SatelliteApplicationsCatapult/PocketQube/hardware/Electronic/PCB Designs/RFP/Manufacture files/RFP.jpg

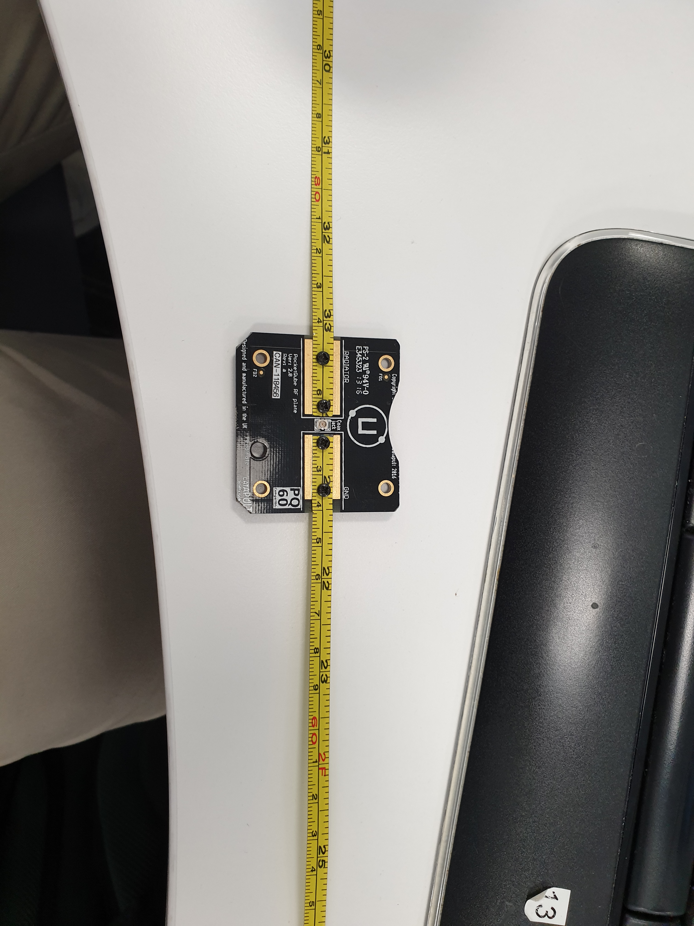
hardware/Electronic/PCB Designs/RFP/Manufacture files/RFP.jpg
