SatelliteApplicationsCatapult/PocketQube/hardware/Electronic/Sketchup Component Models/Textures/IXYS_rear.jpg

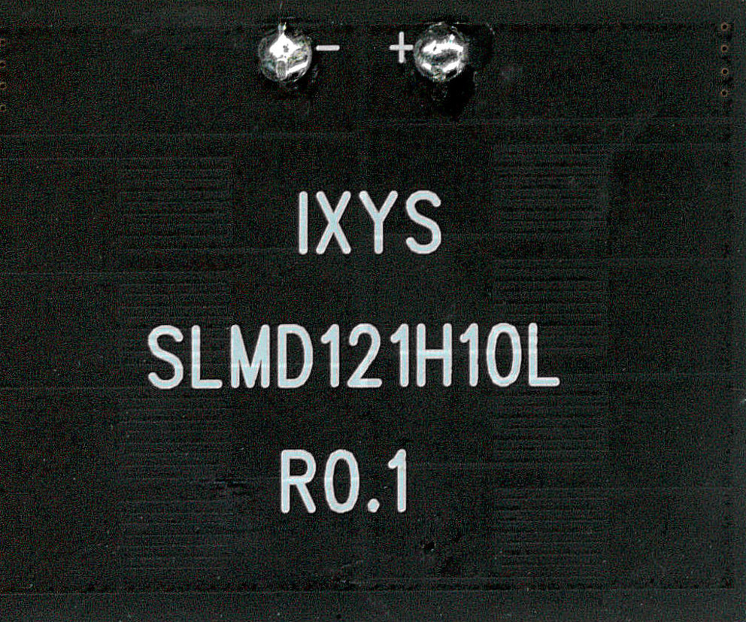
hardware/Electronic/Sketchup Component Models/Textures/IXYS_rear.jpg
