SatelliteApplicationsCatapult/PocketQube/cube/examples/README.md

New example structure. Propose _Basics_ contains blink, and a USB / radio debug terminal, incorporating self tests
_Cube_ will contain sensor access examples through the cube library, EPS communications, mode switching etc
_Payload_ contains payload examples, camera and mock?
_Examples_ will contain a single example for every satellite component
