SatelliteApplicationsCatapult/PocketQube/hardware/Electronic/PCB Designs/EPS/KiCAD/EPS/EPS_conversion_log.txt

#********** START OF renumber-sheet.ulp ULP Version 4.4.4 14-03-2016 :10:27:15 LOG **********#
#OldRef				SheetNumber	NewRef
BAT				2	BAT56
BU4331G-TR				2	BU4331G-TR56
INA210AIDCKT				2	INA210AIDCKT56
PQ60_HEADER				3	PQ60_HEADER56
PQ60_RECEPTACLE				3	PQ60_RECEPTACLE56
PWR				2	PWR56
STWD100PYW83F				2	STWD100PYW83F56
#********** END OF renumber-sheet.ulp ULP Version 4.4.4 14-03-2016 :10:27:15 LOG **********#

#********** START OF fix_via_hack.ulp ULP Version 4.6.0 14-03-2016 :10:28:07 LOG **********#
PADFILL	PadCount=5		Net=GND				(X=6850.000000 Y=21200.000000)	LayerStart=16	LayerEnd=16
PADFILL	PadCount=9		Net=GND				(X=32600.000000 Y=15550.000000)	LayerStart=16	LayerEnd=16
PADFILL	PadCount=11		Net=GND				(X=27400.000000 Y=8750.000000)	LayerStart=16	LayerEnd=16
PADFILL	PadCount=13		Net=GND				(X=26800.000000 Y=14250.000000)	LayerStart=16	LayerEnd=16
PADFILL	PadCount=15		Net=GND				(X=32850.000000 Y=19900.000000)	LayerStart=16	LayerEnd=16
PADFILL	PadCount=17		Net=GND				(X=40800.000000 Y=15550.000000)	LayerStart=16	LayerEnd=16
PADFILL	PadCount=19		Net=GND				(X=34700.000000 Y=8750.000000)	LayerStart=16	LayerEnd=16
PADFILL	PadCount=21		Net=GND				(X=34700.000000 Y=14250.000000)	LayerStart=16	LayerEnd=16
PADFILL	PadCount=23		Net=GND				(X=41050.000000 Y=19800.000000)	LayerStart=16	LayerEnd=16
PADFILL	PadCount=25		Net=GND				(X=4900.000000 Y=21950.000000)	LayerStart=16	LayerEnd=16
PADFILL	PadCount=27		Net=GND				(X=3050.000000 Y=25500.000000)	LayerStart=16	LayerEnd=16
PADFILL	PadCount=29		Net=GND				(X=10600.000000 Y=21950.000000)	LayerStart=16	LayerEnd=16
PADFILL	PadCount=31		Net=GND				(X=28400.000000 Y=22150.000000)	LayerStart=16	LayerEnd=16
PADFILL	PadCount=33		Net=GND				(X=26800.000000 Y=21150.000000)	LayerStart=16	LayerEnd=16
PADFILL	PadCount=39		Net=GND				(X=3600.000000 Y=17200.000000)	LayerStart=16	LayerEnd=16
PADFILL	PadCount=50		Net=GND				(X=29600.000000 Y=16850.000000)	LayerStart=16	LayerEnd=16
PADFILL	PadCount=58		Net=GND				(X=29600.000000 Y=15500.000000)	LayerStart=16	LayerEnd=16
PADFILL	PadCount=61		Net=GND				(X=37800.000000 Y=16850.000000)	LayerStart=16	LayerEnd=16
PADFILL	PadCount=69		Net=GND				(X=37800.000000 Y=15500.000000)	LayerStart=16	LayerEnd=16
PADFILL	PadCount=72		Net=GND				(X=13500.000000 Y=32775.000000)	LayerStart=1	LayerEnd=1
PADFILL	PadCount=73		Net=GND				(X=14100.000000 Y=32775.000000)	LayerStart=1	LayerEnd=1
PADFILL	PadCount=76		Net=GND				(X=15900.000000 Y=32775.000000)	LayerStart=1	LayerEnd=1
PADFILL	PadCount=77		Net=GND				(X=16500.000000 Y=32775.000000)	LayerStart=1	LayerEnd=1
PADFILL	PadCount=80		Net=GND				(X=18300.000000 Y=32775.000000)	LayerStart=1	LayerEnd=1
PADFILL	PadCount=81		Net=GND				(X=18900.000000 Y=32775.000000)	LayerStart=1	LayerEnd=1
PADFILL	PadCount=84		Net=GND				(X=20700.000000 Y=32775.000000)	LayerStart=1	LayerEnd=1
PADFILL	PadCount=85		Net=GND				(X=21300.000000 Y=32775.000000)	LayerStart=1	LayerEnd=1
PADFILL	PadCount=88		Net=GND				(X=23100.000000 Y=32775.000000)	LayerStart=1	LayerEnd=1
PADFILL	PadCount=89		Net=GND				(X=23700.000000 Y=32775.000000)	LayerStart=1	LayerEnd=1
PADFILL	PadCount=92		Net=GND				(X=25500.000000 Y=32775.000000)	LayerStart=1	LayerEnd=1
PADFILL	PadCount=93		Net=GND				(X=26100.000000 Y=32775.000000)	LayerStart=1	LayerEnd=1
PADFILL	PadCount=97		Net=GND				(X=28500.000000 Y=32775.000000)	LayerStart=1	LayerEnd=1
PADFILL	PadCount=114		Net=GND				(X=21300.000000 Y=37225.000000)	LayerStart=1	LayerEnd=1
PADFILL	PadCount=115		Net=GND				(X=20700.000000 Y=37225.000000)	LayerStart=1	LayerEnd=1
PADFILL	PadCount=116		Net=GND				(X=20100.000000 Y=37225.000000)	LayerStart=1	LayerEnd=1
PADFILL	PadCount=117		Net=GND				(X=19500.000000 Y=37225.000000)	LayerStart=1	LayerEnd=1
PADFILL	PadCount=122		Net=GND				(X=16500.000000 Y=37225.000000)	LayerStart=1	LayerEnd=1
PADFILL	PadCount=123		Net=GND				(X=15900.000000 Y=37225.000000)	LayerStart=1	LayerEnd=1
PADFILL	PadCount=124		Net=GND				(X=15300.000000 Y=37225.000000)	LayerStart=1	LayerEnd=1
PADFILL	PadCount=125		Net=GND				(X=14700.000000 Y=37225.000000)	LayerStart=1	LayerEnd=1
PADFILL	PadCount=132		Net=GND				(X=13500.000000 Y=32150.000000)	LayerStart=16	LayerEnd=16
PADFILL	PadCount=133		Net=GND				(X=14100.000000 Y=32150.000000)	LayerStart=16	LayerEnd=16
PADFILL	PadCount=136		Net=GND				(X=15900.000000 Y=32150.000000)	LayerStart=16	LayerEnd=16
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
PADFILL	PadCount=335		Net=GND				(X=24400.000000 Y=21750.000000)	LayerStart=16	LayerEnd=16
PADFILL	PadCount=336		Net=GND				(X=24400.000000 Y=21250.000000)	LayerStart=16	LayerEnd=16
PADFILL	PadCount=363		Net=GND				(X=21800.000000 Y=22000.000000)	LayerStart=16	LayerEnd=16
PADFILL	PadCount=364		Net=GND				(X=23246.400000 Y=23245.900000)	LayerStart=16	LayerEnd=16
PADFILL	PadCount=365		Net=GND				(X=23600.000000 Y=21800.000000)	LayerStart=16	LayerEnd=16
PADFILL	PadCount=370		Net=GND				(X=35990.000000 Y=31765.000000)	LayerStart=16	LayerEnd=16
PADFILL	PadCount=372		Net=GND				(X=40600.000000 Y=21300.000000)	LayerStart=16	LayerEnd=16
PADFILL	PadCount=374		Net=GND				(X=38100.000000 Y=26750.000000)	LayerStart=16	LayerEnd=16
PADFILL	PadCount=376		Net=GND				(X=38100.000000 Y=20450.000000)	LayerStart=16	LayerEnd=16
PADFILL	PadCount=381		Net=GND				(X=12700.000000 Y=19275.000000)	LayerStart=16	LayerEnd=16
PADFILL	PadCount=387		Net=GND				(X=17925.000000 Y=12200.000000)	LayerStart=16	LayerEnd=16
PADFILL	PadCount=396		Net=GND				(X=24508.000000 Y=10352.200000)	LayerStart=16	LayerEnd=16
PADFILL	PadCount=397		Net=GND				(X=24000.000000 Y=10352.200000)	LayerStart=16	LayerEnd=16
PADFILL	PadCount=398		Net=GND				(X=23492.000000 Y=10352.200000)	LayerStart=16	LayerEnd=16
PADFILL	PadCount=403		Net=GND				(X=24508.000000 Y=13247.800000)	LayerStart=16	LayerEnd=16
PADFILL	PadCount=405		Net=GND				(X=24000.000000 Y=11800.000000)	LayerStart=16	LayerEnd=16
PADFILL	PadCount=410		Net=GND				(X=14300.000000 Y=9484.000000)	LayerStart=16	LayerEnd=16
PADFILL	PadCount=412		Net=GND				(X=14300.000000 Y=10500.000000)	LayerStart=16	LayerEnd=16
PADFILL	PadCount=418		Net=GND				(X=13169.800000 Y=29970.000000)	LayerStart=16	LayerEnd=16
PADFILL	PadCount=426		Net=GND				(X=17969.800000 Y=29970.000000)	LayerStart=16	LayerEnd=16
PADFILL	PadCount=434		Net=GND				(X=22669.800000 Y=29970.000000)	LayerStart=16	LayerEnd=16
#********** END OF fix_via_hack.ulp ULP Version 4.6.0 14-03-2016 :10:28:07 LOG **********#

#********** START OF eagle6xx-sch-to-kicad-sch.ulp 1.8 14-03-2016 :10:28:19 LOG **********#
Symbol Name Conflict: Symbol=FX8C-060P-SV(92) from Internal SCH lib=OBC  With Symbol=FX8C-060P-SV(92) from LIB=Template
Device Name Conflict: Device=GND from Internal SCH lib=SparkFun-Aesthetics  With Device=GND from LIB=supply1
Device Name Conflict: Device=GND from Internal SCH lib=SparkFun-Aesthetics  With Device=GND from LIB=ubo_PQ60
Symbol Name Conflict: Symbol=DGND from Internal SCH lib=SparkFun-Aesthetics  With Symbol=DGND from LIB=ubo_PQ60
Symbol Name Conflict: Symbol=FX8C-060P-SV(92) from Internal SCH lib=Template  With Symbol=FX8C-060P-SV(92) from LIB=OBC
Device Name Conflict: Device=GND from Internal SCH lib=supply1  With Device=GND from LIB=SparkFun-Aesthetics
Device Name Conflict: Device=GND from Internal SCH lib=supply1  With Device=GND from LIB=ubo_PQ60
Device Name Conflict: Device=GND from Internal SCH lib=ubo_PQ60  With Device=GND from LIB=SparkFun-Aesthetics
Device Name Conflict: Device=GND from Internal SCH lib=ubo_PQ60  With Device=GND from LIB=supply1
Symbol Name Conflict: Symbol=DGND from Internal SCH lib=ubo_PQ60  With Symbol=DGND from LIB=SparkFun-Aesthetics
#********** END OF eagle6xx-sch-to-kicad-sch.ulp 1.8 14-03-2016 :10:28:19 LOG **********#

#********** START OF exp-lbrs.ulp 6.6 14-03-2016 :10:28:29 LOG **********#
OK: Eagle lib export from SCH/PCB OK
    Conversion completed with no Messages
#********** END OF exp-lbrs.ulp 6.6 14-03-2016 :10:28:29 LOG **********#

#********** START OF eagle-lbr2kicad-1.0.ulp 2.0 14-03-2016 :10:28:39 LOG **********#
Missing Prefix Part =''				ADAFRUIT_FIDUCIAL_1MM					EPS		M
Missing Prefix Part =''				EPS_PQ60_SSOP5					EPS		M
Missing Prefix Part =''				OBC_FX8C-060P-SV(92)					EPS		M
Missing Prefix Part =''				OBC_MKL02Z16VFM4					EPS		M
Missing Prefix Part =''				UBO_PQ60_3MMPILAR					EPS		M
Missing Prefix Part =''				UBO_PQ60_961102-5604-AR					EPS		M
Missing Prefix Part =''				UBO_PQ60_ABS25					EPS		M
Missing Prefix Part =''				UBO_PQ60_SOD-123					EPS		M
Missing Prefix Part =''				UBO_PQ60_PVQFN16-THERM					EPS		M
Missing Prefix Part =''				UBO_PQ60_DEBUG-TP					EPS		M
Missing Prefix Part =''				UBO_PQ60_EL3H7					EPS		M
Missing Prefix Part =''				UBO_PQ60_FAN4010IL6X_F113					EPS		M
Missing Prefix Part =''				UBO_PQ60_SC-70					EPS		M
Missing Prefix Part =''				UBO_PQ60_JST-B2B-ZR					EPS		M
Missing Prefix Part =''				UBO_PQ60_DFN-3X3					EPS		M
Missing Prefix Part =''				UBO_PQ60_XDFN8					EPS		M
Missing Prefix Part =''				UBO_PQ60_SOT23-3					EPS		M
Missing Prefix Part =''				UBO_PQ60_SOT_323-5					EPS		M
Missing Prefix Part =''				UBO_PQ60_TAG_CONNECT					EPS		M
Missing Prefix Part =''				UBO_PQ60_WE-TPC-744031100					EPS		M
#********** END OF eagle-lbr2kicad-1.0.ulp 2.0 14-03-2016 :10:28:39 LOG **********#
