SatelliteApplicationsCatapult/PocketQube/hardware/Electronic/PCB Designs/EPS/pinout.xlsx

Sheet: Pinout
Pin # | Port | Function
1 | PTB6 | OPTO_SHDN
2 | PTB7 | Test Pad
3 | - | VDD
4 | - | VREFH
5 | - | VREFL
6 | - | VSS
7 | PTA3 | EXTAL
8 | PTA4 | XTAL
9 | PTA5 | USB_SHDN
10 | PTA6 | WDI
11 | PTB8 | BAT_BUS_ISEN
12 | PTB9 | BAT_RAW_ISEN
13 | PTB10 | SOL_ISEN
14 | PTB11 | BAT_RAW_ISEN_EN
15 | PTA7 | +3V3_SW_ISEN
16 | PTB0 | +3V3_ISEN
17 | PTB1 | GPIO0
18 | PTB2 | +3V3_SW1_EN
19 | PTA8 | +3V3_SW2_EN
20 | PTA9 | +3V3_SW3_EN
21 | PTA10 | BATV_SW1_EN
22 | PTA11 | BATV_SW2_EN
23 | PTB3 | SCL
24 | PTB4 | SDA
25 | PTB5 | BATV_SENS
26 | PTA12 | MPPTV_SENS
27 | PTA13 | BATV_SENS_EN
28 | PTB12 | MPPTV_SENS_EN
29 | PTB13 | NC
30 | PTA0 | SWDCLK
31 | PTA1 | SWDRST
32 | PTA2 | SWDIO

Sheet: Register map
Address (HEX) | Address (DEC) | Register | R/W | Bit 7 | Bit 6 | Bit 5 | Bit 4 | Bit 3 | Bit 2 | Bit 1 | Bit 0 | Description
0x14 | 20 | WHO_AM_I | R | 0 | 1 | 0 | 1 | 0 | 1 | 0 | 1 | 0x55 or 85 decimal. Read only.
0x15 | 21 | STATUS | R | PWR_GOOD | CHG | SOL | USB | SWTCH_FLT | SNS_FLT | MCU_FLT | Reserved | Brief indication of operational status
0x16 | 22 | OPERATIONAL_MODE | R/W | RESET | LOW_PWR_1 | LOW_PWR_2 | LOW_PWR_3 | MODE_1 | MODE_2 | Reserved | Reserved | Basic operational modes
0x17 | 23 | SWITCHED_BUSES | R/W | 3V3_SW1 | 3V3_SW2 | 3V3_SW3 | BATV_SW1 | BATV_SW2 | USBV? | Reserved | Reserved | Bus switching register
0x18 | 24 | VOLTAGE_BATTERY_L | R | data | data | data | data | data | data | data | data | Battery voltage register
0x19 | 25 | VOLTAGE_BATTERY_H | R | data | data | data | data | data | data | data | data
0x1A | 26 | VOLTAGE_MPPT_L | R | data | data | data | data | data | data | data | data | MPPT voltage register
0x1B | 27 | VOLTAGE_MPPT_H | R | data | data | data | data | data | data | data | data
0x1C | 28 | CURRENT_MPPT_L | R | data | data | data | data | data | data | data | data | MPPT current register
0x1D | 29 | CURRENT_MPPT_H | R | data | data | data | data | data | data | data | data
0x1E | 30 | CURRENT_BATTERY_TOTAL_L | R | data | data | data | data | data | data | data | data | Battery raw current register
0x1F | 31 | CURRENT_BATTERY_TOTAL_H | R | data | data | data | data | data | data | data | data
0x20 | 32 | CURRENT_BATTERY_SWITCHED_L | R | data | data | data | data | data | data | data | data | Battery bus current register
0x21 | 33 | CURRENT_BATTERY_SWITCHED_H | R | data | data | data | data | data | data | data | data
0x22 | 34 | CURRENT_3V3_SYSTEM_L | R | data | data | data | data | data | data | data | data | 3V3 system current register
0x23 | 35 | CURRENT_3V3_SYSTEM_H | R | data | data | data | data | data | data | data | data
0x24 | 36 | CURRENT_3V3_SWITCHED_L | R | data | data | data | data | data | data | data | data | 3V3 switched current register
0x25 | 37 | CURRENT_3V3_SWITCHED_H | R | data | data | data | data | data | data | data | data
0x26 | 38
0x27 | 39
0x28 | 40
0x29 | 41
0x2A | 42
0x2B | 43
0x2C | 44
0x2D | 45
0x2E | 46
0x2F | 47
0x30 | 48
0x31 | 49
0x32 | 50
0x33 | 51
0x34 | 52
0x35 | 53
0x36 | 54
0x37 | 55
0x38 | 56
0x39 | 57
0x3A | 58
0x3B | 59
0x3C | 60
0x3D | 61
0x3E | 62
0x3F | 63

Sheet: Functions
Current sensing:
Raw combined solar output
Total bidirectional battery charge / discharge
Raw battery PQ60 switched line draw
3V3 systems load
3V3 switched line load
Voltage sensing
Raw battery voltage
Raw combined solar output
Switched busses
3 switched 3V3 PQ60 lines
2 switched battery voltage lines
1 switched 5V USB input charging line
Monitors
Watchdog timer STWD100PY
Brownout monitor BU4331G
Internal functions
MPPT shutdown through opto-isolator, to enable accurate voltage measurements
Total battery current sense enable, to prevent power loss through resistor divider
MPPT voltage sense enable
Battery voltage sense enable
Watchdog output
Jumper pin to enable system power
SWD RST, DIO, CLK for debugging
External functions
Reset line, low to reset
I2C connectivity
GPIO0 for interrupting the OBC
