SatelliteApplicationsCatapult/PocketQube/hardware/Electronic/PCB Designs/OBC/pinout.xlsx

Sheet: Pinout
MK20DX256VLH7 pinout
Pin | Name | Function | Teensy | PQ60 | Comments
1 | PTE0 | IO | D31/A20 | N/C | SD card detect pin
2 | PTE1/LLWU_P0 | SD power | D26/A15 | N/C | SD power enable pin
3 | VDD | Supply | VCC | +3V3
4 | VSS | Ground | VSS | GND
5 | USB0_DP | USB D+ | USB D+ | N/C
6 | USB0_DM | USB D- | USB D+ | N/C
7 | VOUT33 | Supply | VCC | +3V3
8 | VREGIN | Supply | VCC | +3V3
9 | PGA0_DP/ADC0_DP0/ADC1_DP3 | N/C | A11/ADC0_DP0 | N/C
10 | PGA0_DM/ADC0_DM0/ADC1_DM3 | N/C | A10/ADC0_DM0 | N/C
11 | PGA1_DP/ADC1_DP0/ADC0_DP3 | IO | A12/ADC0_DP3 | GPIO10 | 13-bit differential or 12-bit single-ended ADC
12 | PGA1_DM/ADC1_DM0/ADC0_DM3 | IO | A13/ADC0_DM3 | GPIO9 | 13-bit differential or 12-bit single-ended ADC
13 | VDDA | Supply | VCC | N/C
14 | VREFH | Reference voltage | VREF-H | N/C
15 | VREFL | Reference voltage | VSS | GND
16 | VSSA | Reference voltage | VSS | GND
17 | VREF_OUT/CMP1_IN5/CMP0_IN5/ADC1_SE18 | Reference output | VREF_OUT | N/C
18 | DAC0_OUT/CMP1_IN3/ADC0_SE23 | IO | A14/DAC | GPIO1 | 12-bit 'true analogue' DAC
19 | XTAL32 | N/C | XTAL32 | N/C | Broken out to test pad
20 | EXTAL32 | N/C | EXTAL32 | N/C | Broken out to test pad
21 | VBAT | Supply | VBAT | +3V3
22 | PTA0 | JTAG | JTAG_TCLK/SWD_CLK | N/C | Connected to MKL02Z PTB0 and SWD header
23 | PTA1 | JTAG | JTAG_TDI | N/C | Connected to USB ID
24 | PTA2 | JTAG | JTAG_TDO/TRACE_SWO | N/C | Connected to MKL02Z PTB1 and SWD header
25 | PTA3 | JTAG | JTAG_TMS/SWD_DIO | N/C | Connected to MKL02Z PTA7 and SWD header
26 | PTA4/LLWU_P3 | LED | D33/PWM/TOUCH | N/C | Connected to blue LED (on OBC)
27 | PTA5 | N/C | D24 | N/C
28 | PTA12 | IO | D3/CAN-TX/PWM | GPIO7 | Digital IO, CAN-TX and PWM support
29 | PTA13/LLWU_P4 | IO | D4/CAN-TX/PWM | GPIO6 | Digital IO, CAN-RX and PWM support
30 | VDD | Supply | VCC | +3V3
31 | VSS | Ground | VSS | GND
32 | PTA18 | XTAL | OSC1 | N/C | Connected to 16MHz crystal
33 | PTA19 | XTAL | OSC2 | N/C | Connected to 16MHz crystal
34 | RESET_b | RESET | RESET | N/C | Connected to MKL02Z PTA4 and PTB5. Not connected to PQ60 reset, power cycling will reset MCU regardless. Bootloader chip requires reset control for programming.
35 | PTB0/LLWU_P5 | NIRQ | D16/A2/TOUCH | N/C | Connected to RF module NIRQ (on OBC)
36 | PTB1 | N/C | D17/A3/TOUCH | NC
37 | PTB2 | SCL | D19/A5/SCL0/TOUCH | SCL | Primary I2C clock line on bus. Externally connected to 4.7K pullup resistor
38 | PTB3 | SDA | D18/A4/SDA0/TOUCH | SDA | Primary I2C data line on bus. Externally connected to 4.7K pullup resistor
39 | PTB16 | LED | D0/RX1/TOUCH | N/C | Connected to green LED (on OBC)
40 | PTB17 | LED | D1/TX1/TOUCH | N/C | Connected to yellow LED (on OBC)
41 | PTB18 | LED | D32/PWM/TOUCH | N/C | Connected to amber LED (on OBC)
42 | PTB19 | N/C | D25/PWM/TOUCH | N/C
43 | PTC0 | CS | D15/A1/TOUCH | N/C | Connected to RF module chip select (on OBC)
44 | PTC1/LLWU_P6 | N/C | D22/A8/PWM/TOUCH | N/C | Broken out to test pad
45 | PTC2 | N/C | D23/A9/PWM/TOUCH | N/C | Broken out to test pad
46 | PTC3/LLWU_P7 | IO | D9/RX2/PWM | GPIO5 | Digital IO, UART RX support
47 | VSS | Ground | VSS | GND
48 | VDD | Supply | VCC | +3V3
49 | PTC4/LLWU_P8 | IO | D10/TX2/PWM | GPIO4 | Digital IO, UART TX support
50 | PTC5/LLWU_P9 | SPI | D13/SCK | SCK | Clock line for SPI communications, connected to PQ60 SCK. Also digital IO
51 | PTC6/LLWU_P10 | SPI | D11/MOSI | MOSI | Master Out Slave In for SPI communications. Also digital IO
52 | PTC7 | SPI | D12/MISO | MISO | Master In Slave Out for SPI communications. Also digital IO
53 | PTC8 | N/C | D28/A17 | N/C
54 | PTC9 | N/C | D27/A16 | N/C
55 | PT10 | IO | D29/A18/SCL1 | GPIO3 | Digital IO, I2C SCL support
56 | PTC11/LLWU_P11 | IO | D30/A19/SDA1 | GPIO2 | Digital IO, I2C SDA support
57 | PTD0/LLWU_P12 | IO | D2 | GPIO0 | EPS interrupt line, not to be used by other systems
58 | PTD1 | N/C | D14/A0 | N/C
59 | PTD2/LLWU_P13 | N/C | D7/RX3 | N/C | Broken out to test pad
60 | PTD3 | N/C | D8/TX3 | N/C | Broken out to test pad
61 | PTD4/LLWU_P14 | N/C | D6/PWM | N/C | Broken out to test pad
62 | PTD5 | IO | D20/A6/PWM | GPIO8 | Digital IO, 12-bit ADC and PWM support
63 | PTD6/LLWU_P15 | IO | D21/A7/PWM | GPIO12 | Digital IO, 12-bit ADC and PWM support
64 | PTD7 | IO | D5/PWM | GPIO11 | Digital IO, PWM support. Connected to SD card chip select

Sheet: PQ60
PQ60 pin | Function
1 | +3V3_SW1
2 | +3V3_SW1
3 | GND
4 | GND
5 | +3V3_SW2
6 | +3V3_SW3
7 | GND
8 | GND
9 | +3V3_SW3
10 | +3V3_SW4
11 | GND
12 | GND
13 | BATV_SW1
14 | BATV_SW1
15 | GND
16 | GND
17 | BATV_SW2
18 | BATV_SW2
19 | GND
20 | GND
21 | USBV
22 | USBV
23 | GND
24 | GND
25 | GPIO0
26 | GPIO1
27 | RESET
28 | GND
29 | SCL
30 | SDA
31 | MOSI
32 | MISO
33 | SCK
34 | GPIO2
35 | GPIO3
36 | GPIO4
37 | GPIO5
38 | GPIO6
39 | GPIO7
40 | GPIO8
41 | GPIO9
42 | GPIO10
43 | GPIO11
44 | GPIO12
45 | GND
46 | GND
47 | GND
48 | GND
49 | BATV_BUS
50 | BATV_BUS
51 | BATV_BUS
52 | BATV_BUS
53 | GND
54 | GND
55 | GND
56 | GND
57 | 3V3_BUS
58 | 3V3_BUS
59 | 3V3_BUS
60 | 3V3_BUS

Sheet: GPIO
GPIO | Port | Pin | Teensy | Description
0 | PTD0/LLWU_P12 | 57 | D2 | EPS interrupt line, not to be used by other systems
1 | DAC0_OUT/CMP1_IN3/ADC0_SE23 | 18 | A14/DAC | 12-bit 'true analogue' DAC
2 | PTC11/LLWU_P11 | 56 | D30/A19/SDA1 | Digital IO, I2C SDA support
3 | PT10 | 55 | D29/A18/SCL1 | Digital IO, I2C SCL support
4 | PTC4/LLWU_P8 | 49 | D10/TX2/PWM | Digital IO, UART TX support
5 | PTC3/LLWU_P7 | 46 | D9/RX2/PWM | Digital IO, UART RX support
6 | PTA13/LLWU_P4 | 29 | D4/CAN-TX/PWM | Digital IO, CAN-RX and PWM support
7 | PTA12 | 28 | D3/CAN-TX/PWM | Digital IO, CAN-TX and PWM support
8 | PTD5 | 62 | D20/A6/PWM | Digital IO, 12-bit ADC and PWM support
9 | PGA1_DM/ADC1_DM0/ADC0_DM3 | 12 | A13/ADC0_DM3 | 13-bit differential or 12-bit single-ended ADC
10 | PGA1_DP/ADC1_DP0/ADC0_DP3 | 11 | A12/ADC0_DP3 | 13-bit differential or 12-bit single-ended ADC
11 | PTD7 | 64 | D5/PWM | Digital IO, PWM support - SD card chip select
12 | PTD6/LLWU_P15 | 63 | D21/A7/PWM | Digital IO, 12-bit ADC and PWM support
