SatelliteApplicationsCatapult/PocketQube/hardware/Electronic/PCB Designs/Archive/OBC_PQ60/pinout.xlsx

ATmega32U4 port pinouts
Port B
Pin | Name | Function | PQ60 | Notes
P$8 | PB0 | SS | SS/GPIO2 | D17, Slave Select, also RX LED
P$9 | PB1 | SCK | SCK | Serial Clock for SPI
P$10 | PB2 | MOSI | MOSI | Master Out Slave In
P$11 | PB3 | MISO | MISO | Master In Slave Out
P$28 | PB4 | GPIO | GPIO3 | (ADC11, D17) ISOL, solar panel current sensor
P$29 | PB5 | GPIO | 3V3_BUS | (ADC12, D9) VBUS, bus voltage measurement DO NOT CONNECT DIRECTLY
P$30 | PB6 | GPIO | NC | (ADC13, D10), NSEL rf module, all on OBC
P$12 | PB7 | GPIO | GPIO4 | (D11) Currently free.
Port C
P$31 | PC6 | GPIO | GPIO11 | (D5) Currently free
P$32 | PC7 | GPIO | GPIO1 | (D13) Currently free
Port D
P$18 | PD0 | SCL | SCL | I2C Serial Clock line
P$19 | PD1 | SDA | SDA | I2C Serial Data line
P$20 | PD2 | RX | GPIO8 | UART RX, or GPIO
P$21 | PD3 | TX | GPIO9 | UART TX, or GPIO
P$25 | PD4 | GPIO | GPIO5 | IBUS, bus current
P$22 | PD5 | TX LED | NC | TX LED
P$26 | PD6 | GPIO | GPIO7 | SHDN, solar disconnect
P$27 | PD7 | GPIO | GPIO6 | (D6) VSOL, Solar voltage
Port E
P$33 | PE2 | HWB | NC | Hardware boot. Ground, but break out.
P$1 | PE6 | NIRQ | NC | RF module. All on OBC
Port F
P$41 | PF0 | GPIO | +3V3_SW2 | Not currently used
P$40 | PF1 | GPIO | +3V3_SW3 | Not currently used
P$39 | PF4 | GPIO | BATV_SW | GPIO2, Not used
P$38 | PF5 | GPIO | GPIO10 | GPIO3, not used
P$37 | PF6 | GPIO | GPIO0 | GPIO0, watchdog kicker. On header, so other modules can kick it if they really have to.
P$36 | PF7 | GPIO | GPIO12 | SD card
