SatelliteApplicationsCatapult/PocketQube/cube/softwarearchitecture.png

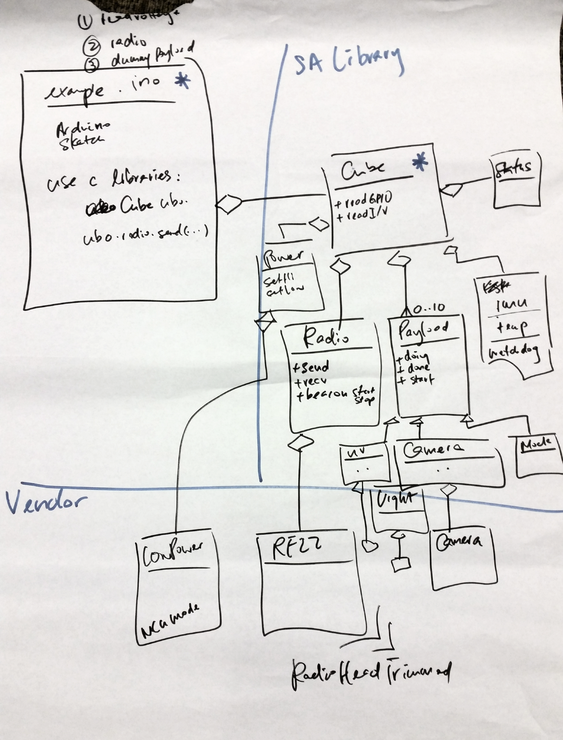
cube/softwarearchitecture.png
