SatelliteApplicationsCatapult/PocketQube/hardware/Electronic/PCB Designs/EPS/Sketchup/EPSBottom.jpg

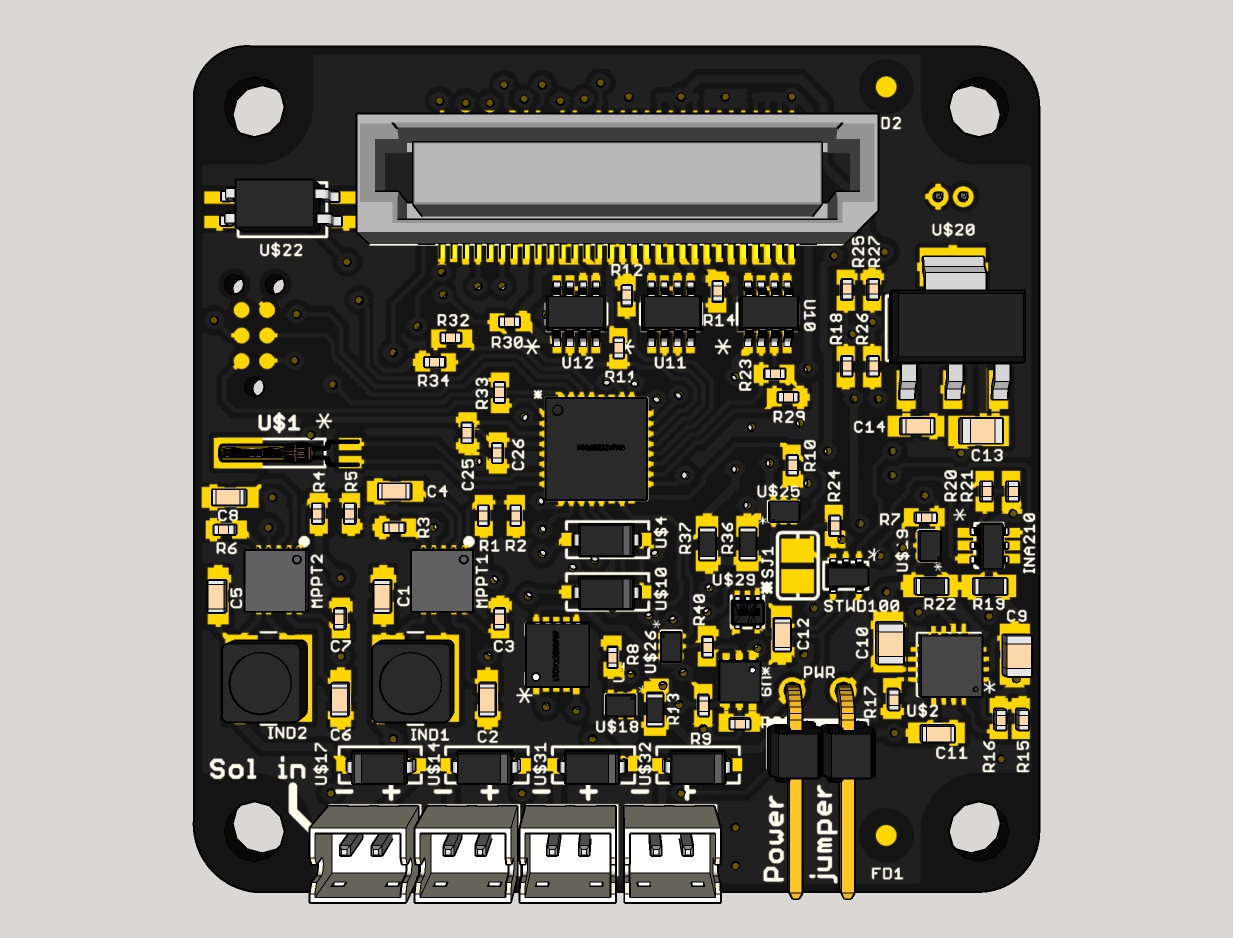
hardware/Electronic/PCB Designs/EPS/Sketchup/EPSBottom.jpg
