SatelliteApplicationsCatapult/PocketQube/hardware/Electronic/PCB Designs/EPS/Sketchup/EPSTop.jpg

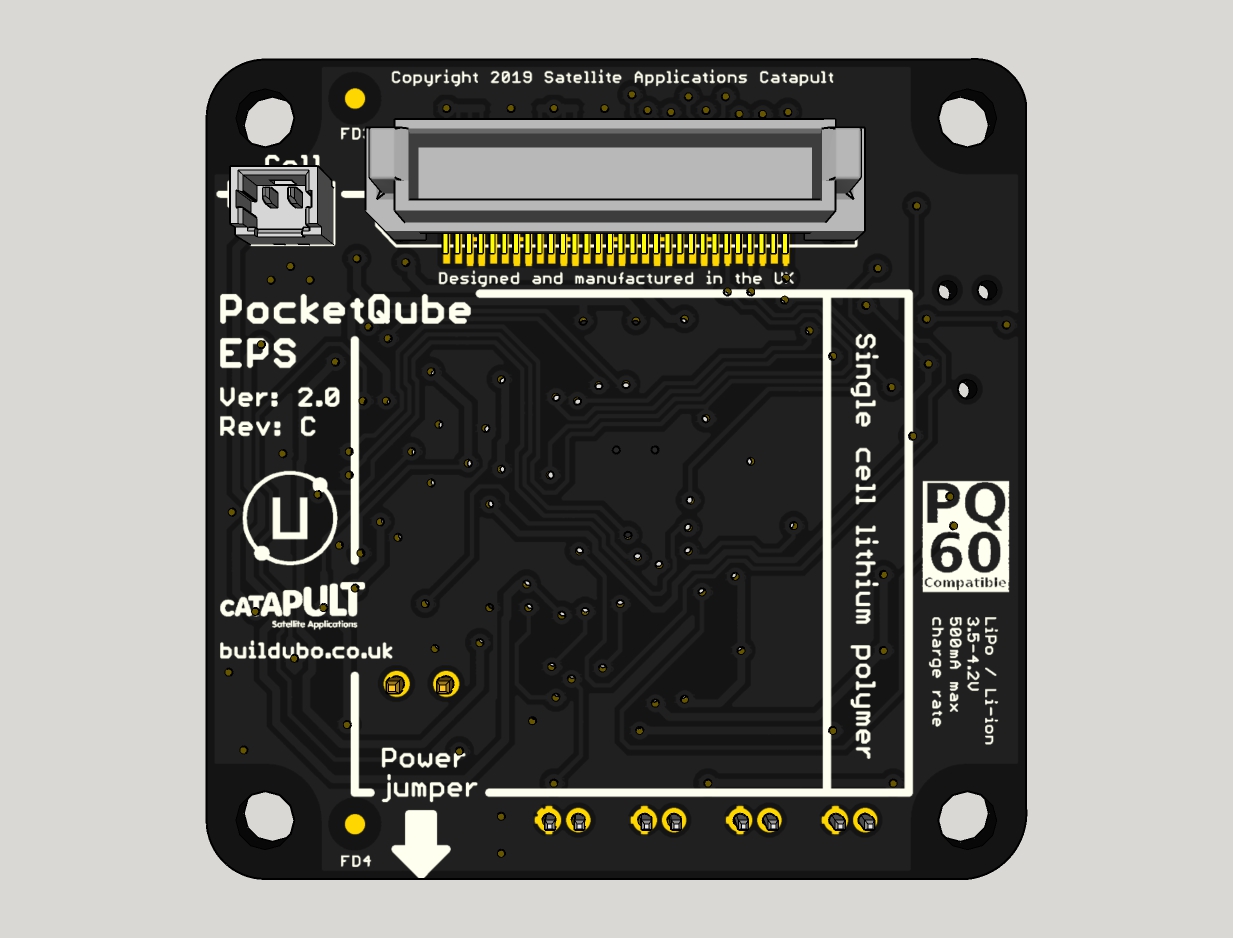
hardware/Electronic/PCB Designs/EPS/Sketchup/EPSTop.jpg
