SatelliteApplicationsCatapult/PocketQube/hardware/Electronic/PCB Designs/OBC/Sketchup/OBCBottom.jpg

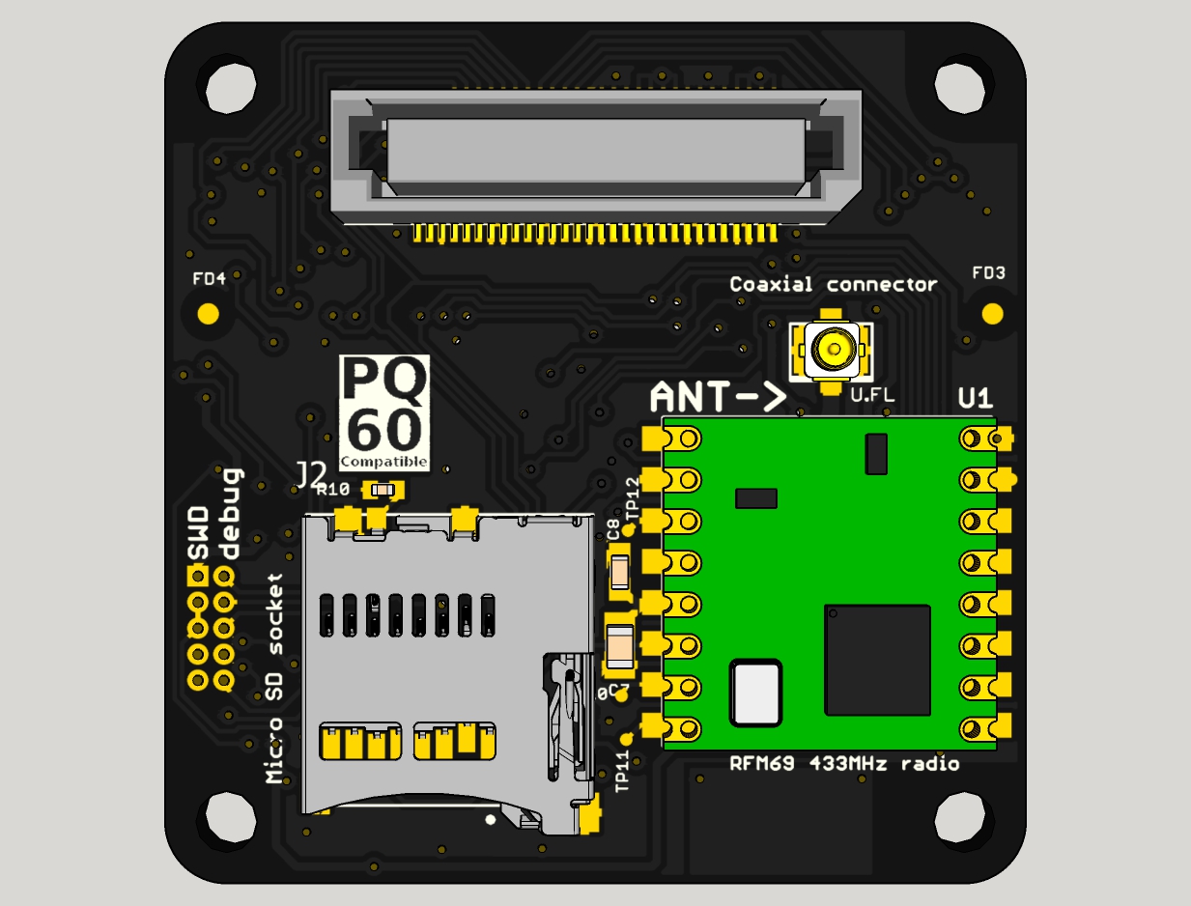
hardware/Electronic/PCB Designs/OBC/Sketchup/OBCBottom.jpg
