SatelliteApplicationsCatapult/PocketQube/hardware/Electronic/PCB Designs/OBC/Sketchup/OBCTop.jpg

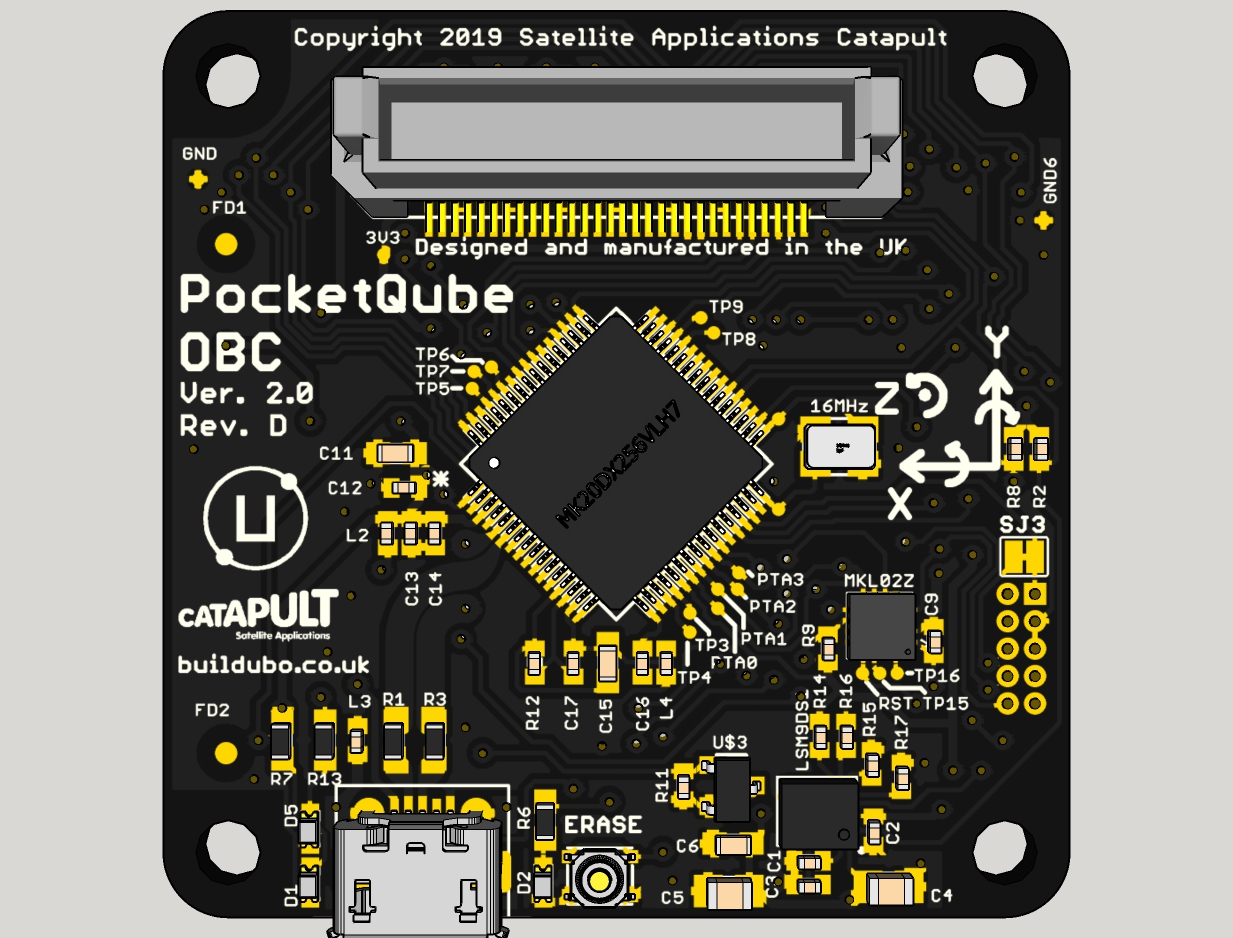
hardware/Electronic/PCB Designs/OBC/Sketchup/OBCTop.jpg
