SatelliteApplicationsCatapult/PocketQube/hardware/Electronic/PCB Designs/Pq60_comp.bmp

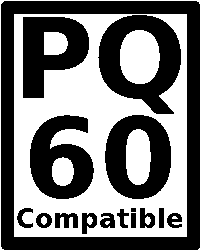
hardware/Electronic/PCB Designs/Pq60_comp.bmp
