SatelliteApplicationsCatapult/PocketQube/hardware/Electronic/PCB Designs/PSB/eagleUp/eagleUp_PSB_board_bottom.jpg

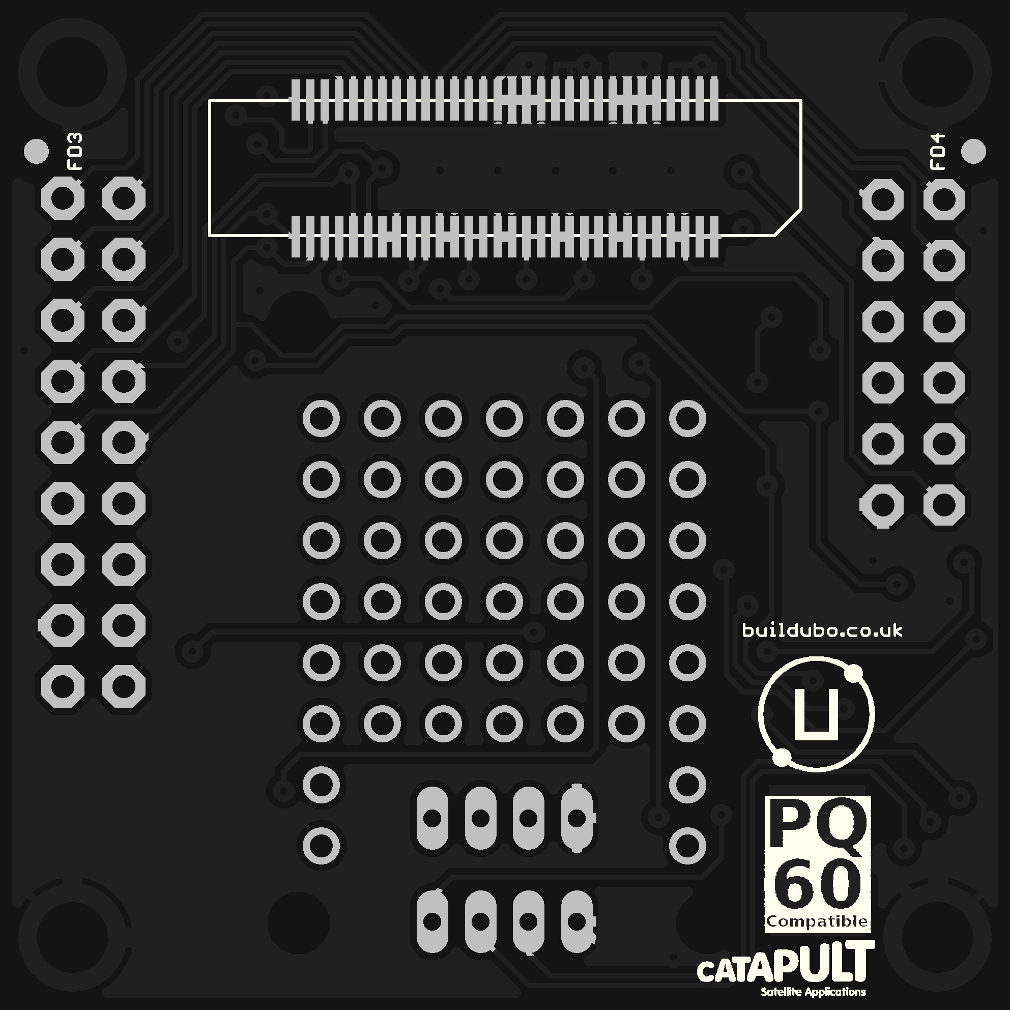
hardware/Electronic/PCB Designs/PSB/eagleUp/eagleUp_PSB_board_bottom.jpg
