SatelliteApplicationsCatapult/PocketQube/hardware/Electronic/PCB Designs/PSB/eagleUp/eagleUp_PSB_board_bottom.png

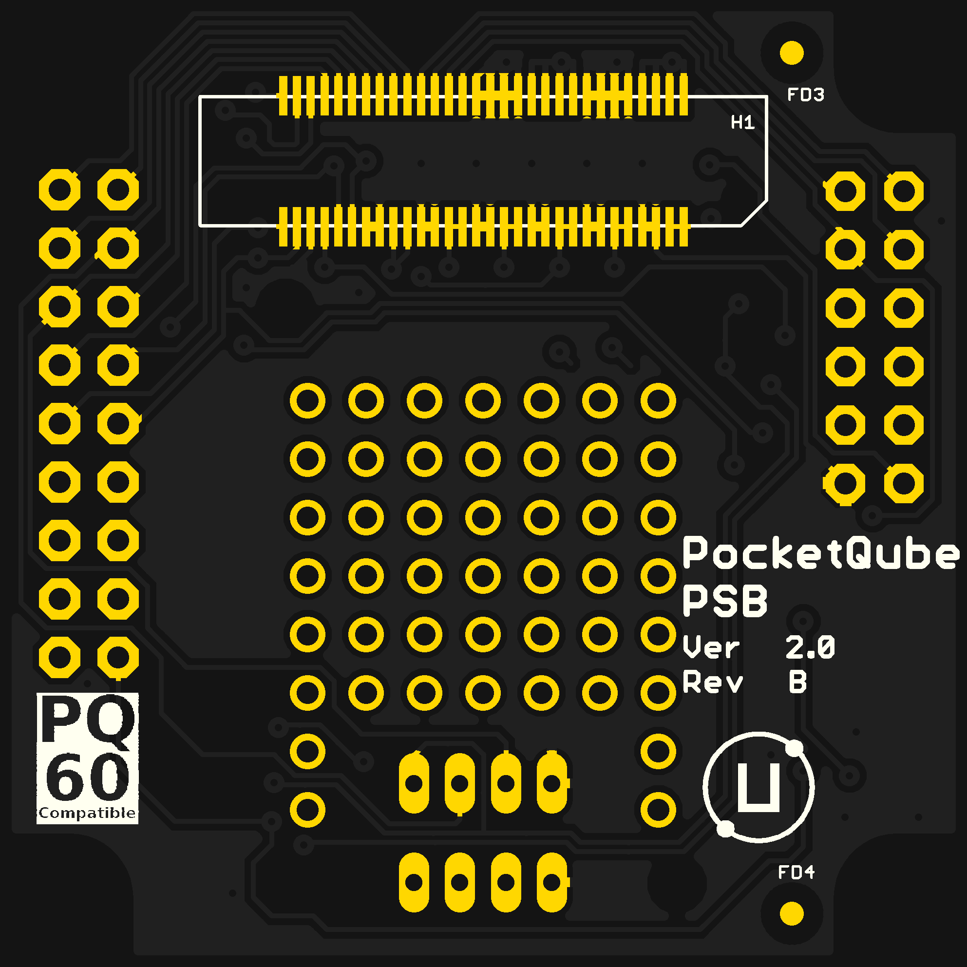
hardware/Electronic/PCB Designs/PSB/eagleUp/eagleUp_PSB_board_bottom.png
