SatelliteApplicationsCatapult/PocketQube/hardware/Electronic/PCB Designs/PSB/eagleUp/eagleUp_PSB_board_top.jpg

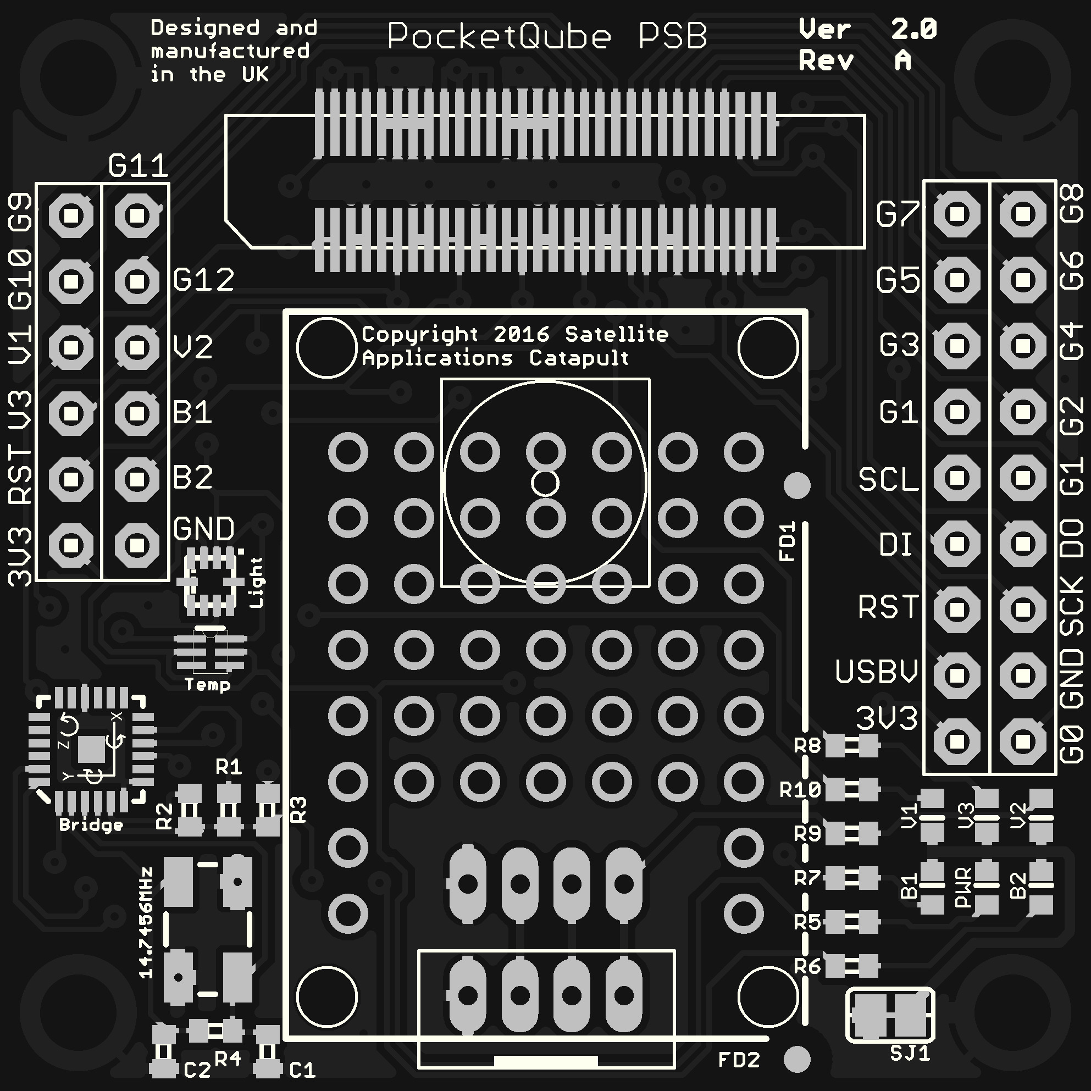
hardware/Electronic/PCB Designs/PSB/eagleUp/eagleUp_PSB_board_top.jpg
