SatelliteApplicationsCatapult/PocketQube/hardware/Electronic/PCB Designs/PSB/eagleUp/eagleUp_PSB_board_top.png

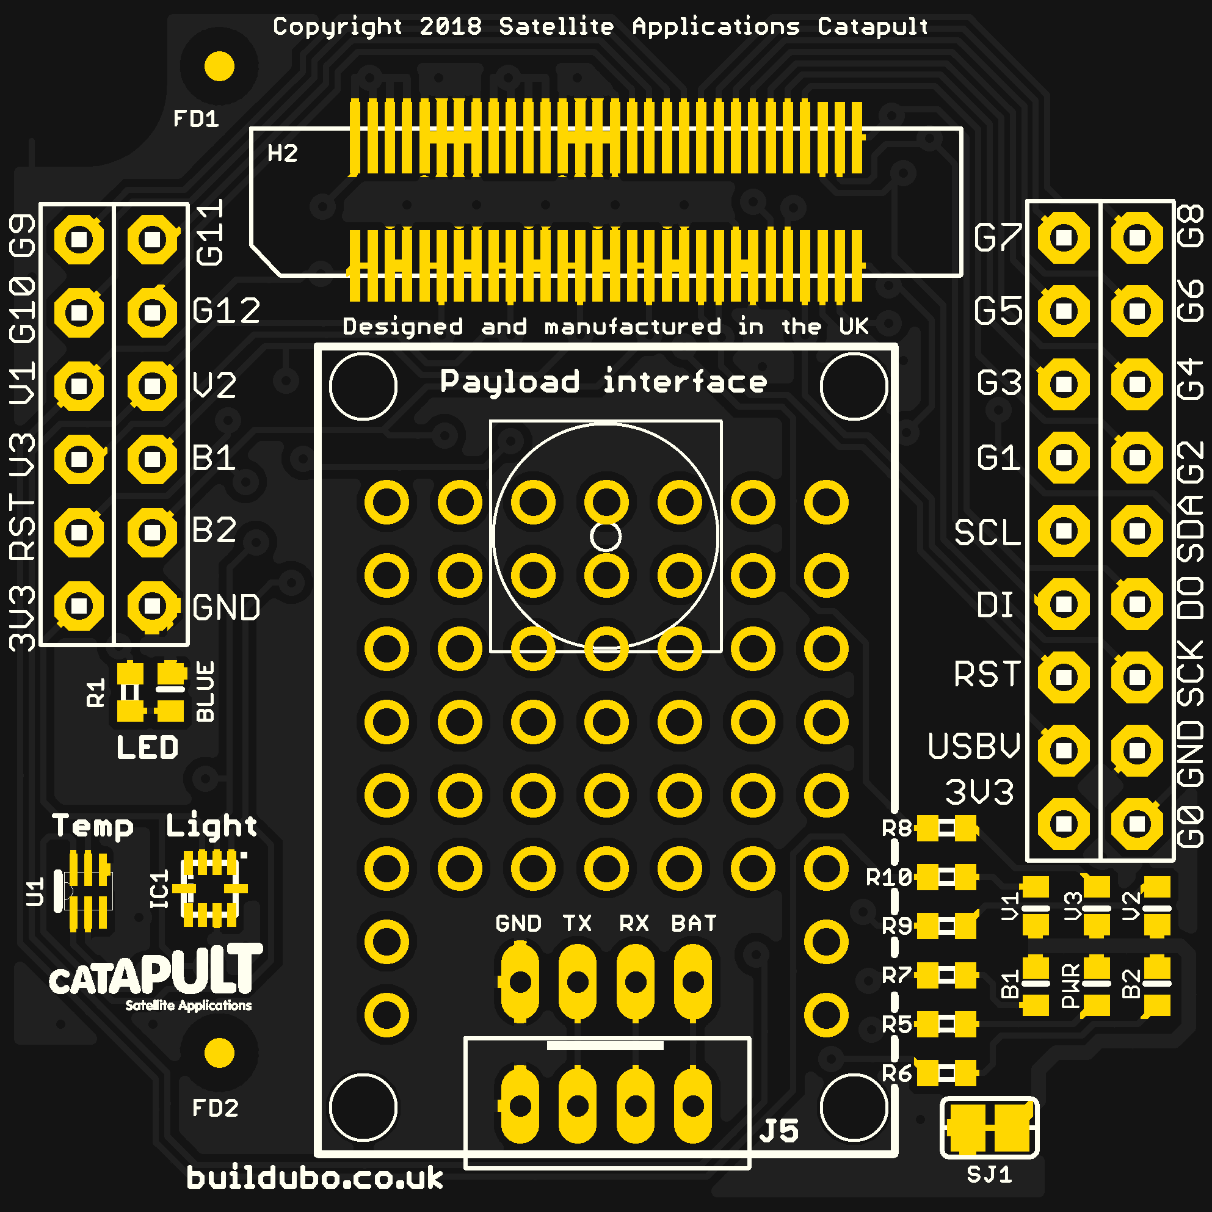
hardware/Electronic/PCB Designs/PSB/eagleUp/eagleUp_PSB_board_top.png
