SatelliteApplicationsCatapult/PocketQube/hardware/Electronic/PCB Designs/PSB/Sketchup/bottom.png

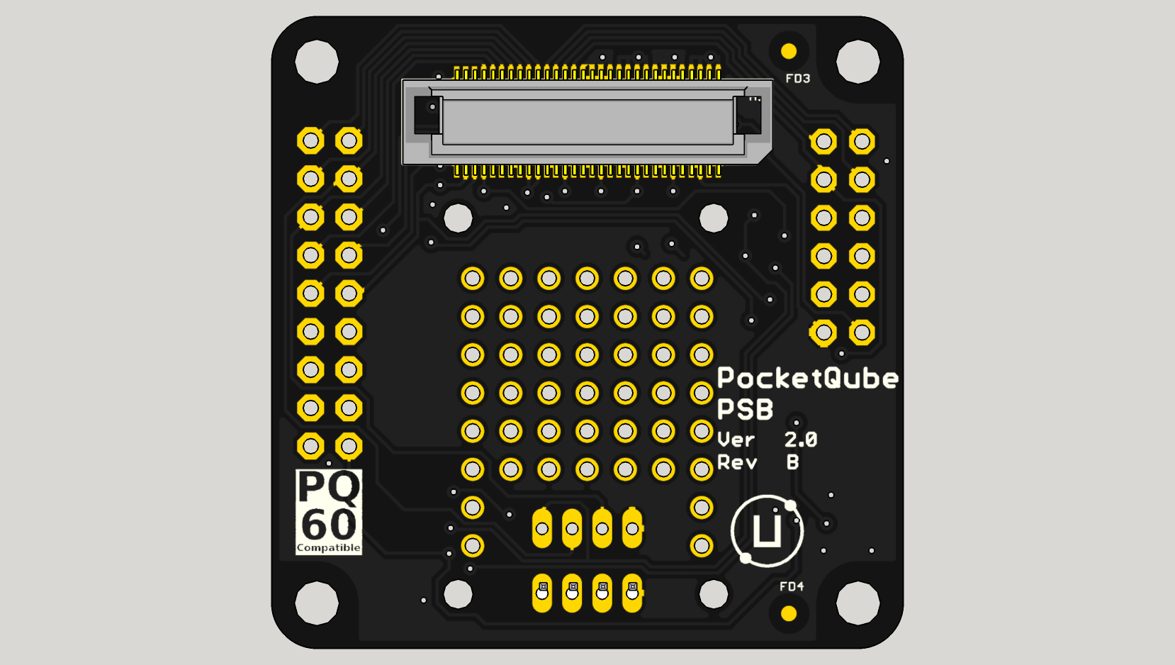
hardware/Electronic/PCB Designs/PSB/Sketchup/bottom.png
