SatelliteApplicationsCatapult/PocketQube/hardware/Electronic/PCB Designs/PSB/Sketchup/top.png

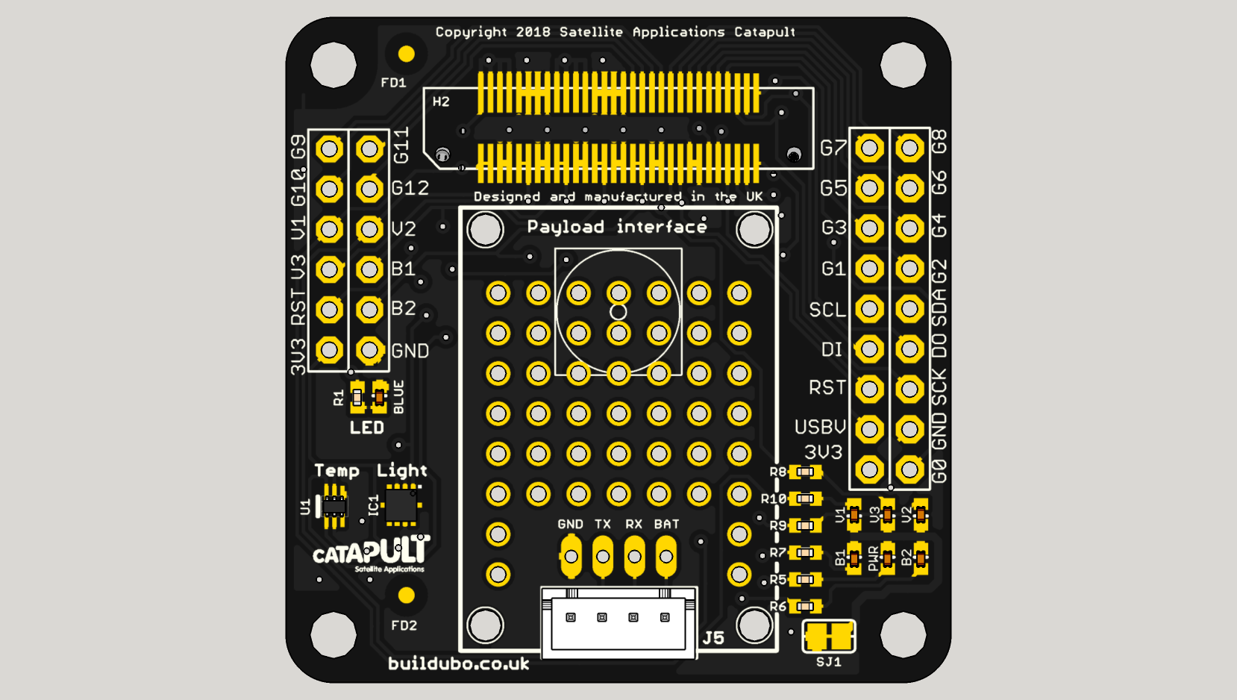
hardware/Electronic/PCB Designs/PSB/Sketchup/top.png
