SatelliteApplicationsCatapult/PocketQube/hardware/Electronic/PCB Designs/RFP/eagleUp/eagleUp_RFP_board_bottom.png

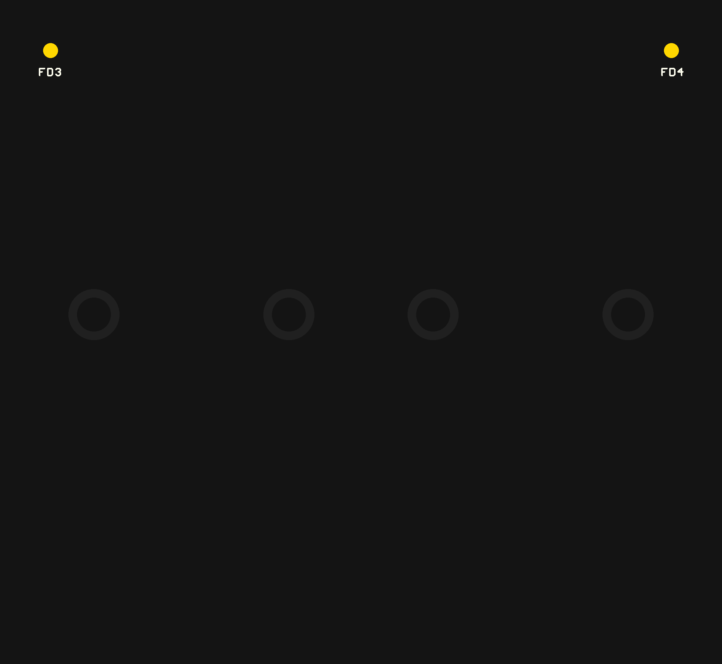
hardware/Electronic/PCB Designs/RFP/eagleUp/eagleUp_RFP_board_bottom.png
