SatelliteApplicationsCatapult/PocketQube/hardware/Electronic/PCB Designs/RFP/eagleUp/eagleUp_RFP_board_top.png

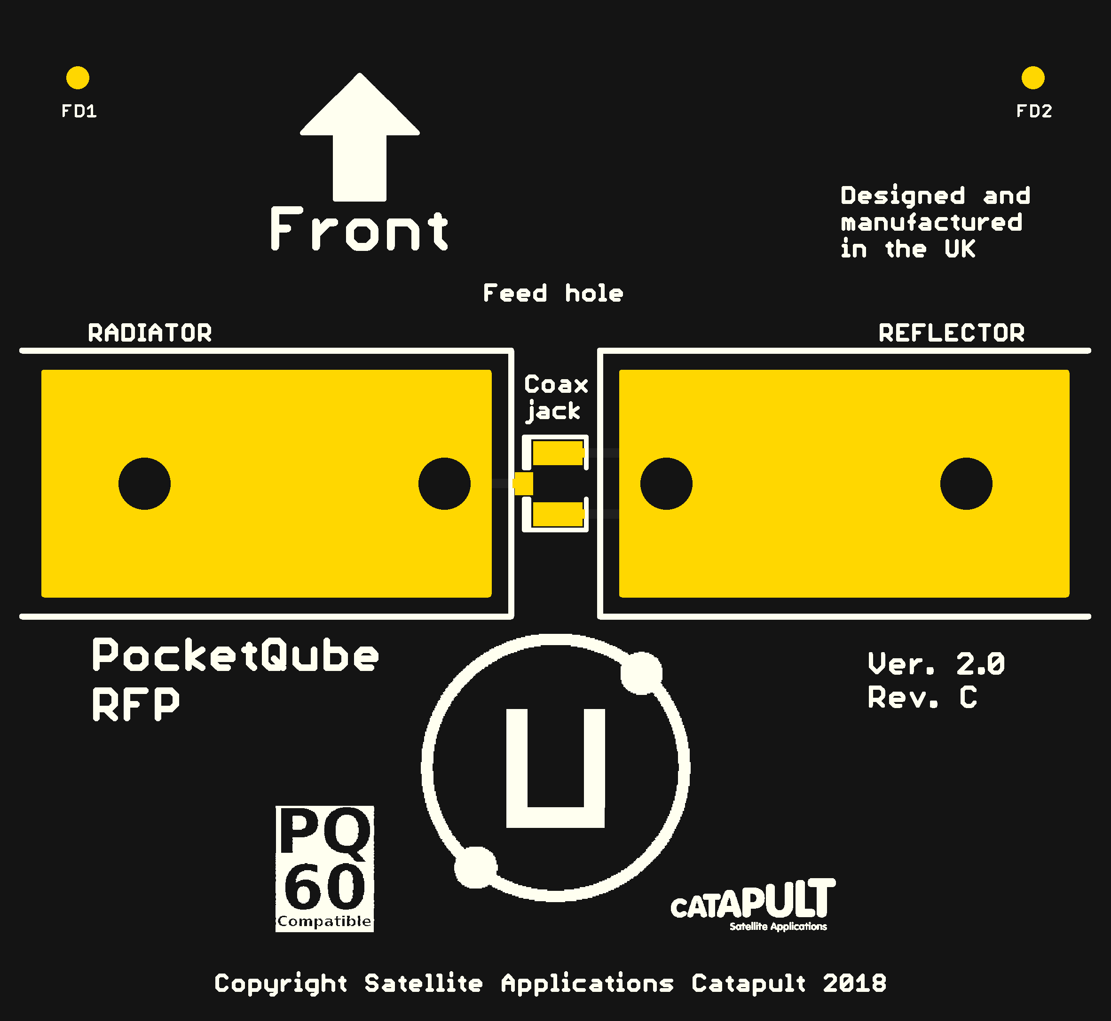
hardware/Electronic/PCB Designs/RFP/eagleUp/eagleUp_RFP_board_top.png
