SatelliteApplicationsCatapult/PocketQube/hardware/Electronic/PCB Designs/RFP/Sketchup/bottom.png

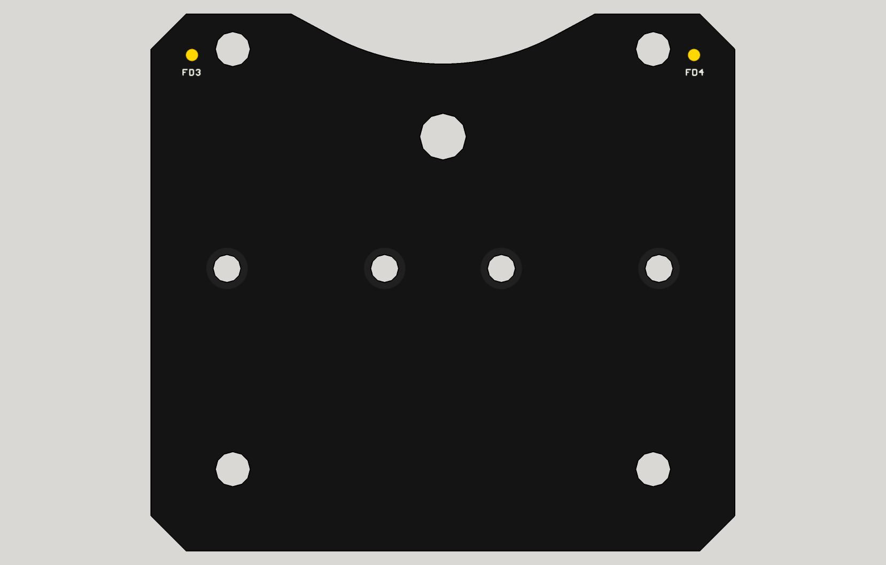
hardware/Electronic/PCB Designs/RFP/Sketchup/bottom.png
