SatelliteApplicationsCatapult/PocketQube/hardware/Electronic/PCB Designs/RFP/Sketchup/top.png

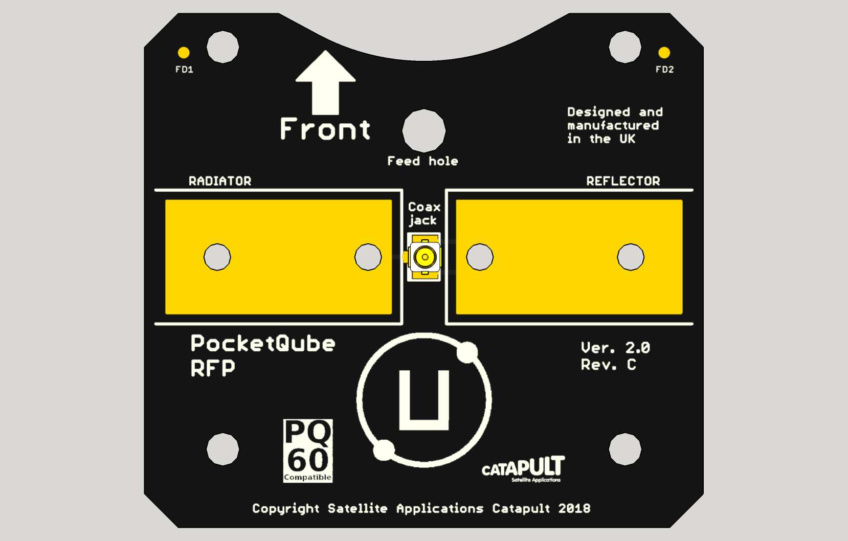
hardware/Electronic/PCB Designs/RFP/Sketchup/top.png
