SatelliteApplicationsCatapult/PocketQube/hardware/Electronic/PCB Designs/SA_LG_Black.bmp

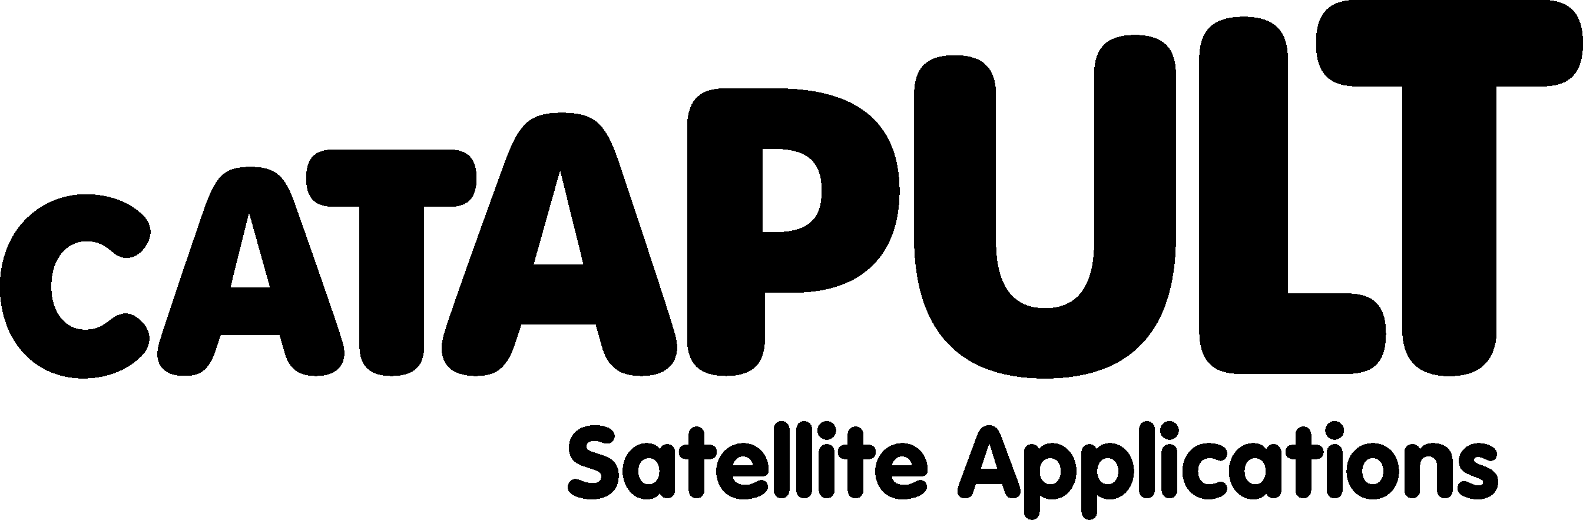
hardware/Electronic/PCB Designs/SA_LG_Black.bmp
