SatelliteApplicationsCatapult/PocketQube/hardware/Electronic/PCB Designs/EPS/Manufacture files/EPS_BOM.xlsx

Parts | Manufacturer | Part number | Value | Qty | Package | Description | Distributor | Order code | Price per | Total | Notes | ROHS | Temp range
C1, C2, C4, C5, C6, C8 |  | C-EUC0603 | 10uF | 6 | C0603 | CAPACITOR, European symbol |  |  |  |  | Any compatible X7R MLCC
C11, C12, C14 |  | C-EUC0603 | 1uF | 3 | C0603 | CAPACITOR, European symbol |  |  |  |  | Any compatible X7R MLCC
C13 |  | C-EUC0805 | 4.7uF | 1 | C0805 | CAPACITOR, European symbol |  |  |  |  | Any compatible X7R MLCC
C25 |  | C-EUC0402 | 0.1uF | 1 | C0402 | CAPACITOR, European symbol |  |  |  |  | Any compatible X7R MLCC
C3, C7, C26 |  | C-EUC0402 | 1uF | 3 | C0402 | CAPACITOR, European symbol |  |  |  |  | Any compatible X7R MLCC
C9, C10 |  | C-EUC0805 | 10uF | 2 | C0805 | CAPACITOR, European symbol |  |  |  |  | Any compatible X7R MLCC
FD1, FD2, FD3, FD4 |  | FIDUCIAL |  | 4 | FIDUCIAL_1MM | For use by pick and place machines to calibrate the vision/machine, 1mm |  |  |  |  | Do not populate
INA210 | Texas Instruments | INA210AIDCKR |  | 1 | SC-70 | Current sense amplifier | Digi-key | 296-38954-1-ND | 1.1 | 30.8 |  | Yes | -40 to 125
IND1, IND2 | Würth | 744031100 |  | 2 | WE-TPC-744031100 | Series Shielded Wire-wound SMD Inductor with a Ferrite Core | Digi-key | 732-1010-1-ND | 1.223 | 68.488 | Alternative suppliers available | Yes | -40 to 125
MPPT1, MPPT2 | Linear Technology | LTC3105EMS#PBF |  | 2 | DFN-3X3 | Step-up DC/DC converter | Mouser | 584-LTC3105EMS#PBF | 3.56 | 199.36 |  | Yes | -40 to 85
PQ60_HEADER | Hirose | FX8C-60P-SV6(91) |  | 1 | FX8C-060P-SV(92) | Header | Mouser | 798-FX8C60PSV691 | 2.48 | 69.44 | Alternative suppliers available, however ensure the FX8C60PSV6 part is used, not SV or SV2. | Yes
PQ60_RECEPTACLE | Hirose | FX8C-60S-SV(91) |  | 1 | FX8C-060S-SV(92) | Socket | Digi-key | H126151-ND | 2.7516 | 77.0448 | Alternative suppliers available for FX8C60SSV | Yes
PWR | Molex | 90121-0762 |  | 1 | NA | PCB Header, 2.54mm pitch, right angle | Farnell | 9733442 | 0.391 | 10.948 |  | Yes | -55 to 125
R1, R4 |  | R-EU_R0402 | 1.3M | 2 | R0402 | RESISTOR, European symbol |  |  |  |  | Any standard chip SMD resistor acceptable, 1% tolerance or better
R13, R22, R36, R37 | Panasonic | ERJ8RQFR56V | 0.56R, 1% | 4 | R0603 | RESISTOR, European symbol | Farnell | 1717849 | 0.14 | 15.68 | Or compatible alternative | Yes | -55 to 125
R16 |  | R-EU_R0402 | 1.2K | 1 | R0402 | RESISTOR, European symbol |  |  |  |  | Any standard chip SMD resistor acceptable, 1% tolerance or better
R17 |  | R-EU_R0402 | 3.3K | 1 | R0402 | RESISTOR, European symbol |  |  |  |  | Any standard chip SMD resistor acceptable, 1% tolerance or better
R18, R20, R21, R25, R27 |  | R-EU_R0402 | 22K 1% | 5 | R0402 | RESISTOR, European symbol |  |  |  |  | Any standard chip SMD resistor acceptable, 1% tolerance or better
R19 | Panasonic | ERJ3BQFR30V | 0.015R 1% | 1 | R0603 | RESISTOR, European symbol | Farnell | 2692819 | 0.18 | 5.04 | Or compatible alternative
R2, R5 |  | R-EU_R0402 | 330K | 2 | R0402 | RESISTOR, European symbol |  |  |  |  | Any standard chip SMD resistor acceptable, 1% tolerance or better
R26 |  | R-EU_R0402 | 22k 1% | 1 | R0402 | RESISTOR, European symbol |  |  |  |  | Any standard chip SMD resistor acceptable, 1% tolerance or better
R3, R6 |  | R-EU_R0402 | 501K | 2 | R0402 | RESISTOR, European symbol |  |  |  |  | Any standard chip SMD resistor acceptable, 1% tolerance or better
R32, R34 |  | R-EU_R0402 |  | 2 | R0402 | RESISTOR, European symbol |  |  |  |  | Do not populate
R33 |  | R-EU_R0402 | 150R | 1 | R0402 | RESISTOR, European symbol |  |  |  |  | Any standard chip SMD resistor acceptable, 1% tolerance or better
R40 |  | R-EU_R0402 | 47K | 1 | R0402 | RESISTOR, European symbol |  |  |  |  | Any standard chip SMD resistor acceptable, 1% tolerance or better
R7, R8, R9, R10, R11, R12, R14, R15, R23, R24, R28, R29, R30 |  | R-EU_R0402 | 10K | 13 | R0402 | RESISTOR, European symbol |  |  |  |  | Any standard chip SMD resistor acceptable, 1% tolerance or better
SJ1 |  | SJ |  | 1 | SJ | SMD solder JUMPER |  |  |  |  | Do not populate
SOL1, SOL2, SOL3, SOL4 | JST | B2B-ZR(LF)(SN) |  | 4 | JST-B2B-ZR | 2-way crimp style Header Connector | Farnell | 9491775 | 0.0697 | 6.97 | Alternative suppliers available | Yes | -25 to 85
STWD100 | STMicroelectronics | STWD100PYW83F |  | 1 | SOT_323-5 | Watchdog timer circuit | Farnell | 2460853RL | 0.678 | 18.984 | Alternative suppliers available | Yes | -40 to 125
U$1 | Abracon LLC | AB26TRQ |  | 1 | AB26TRQ |  |  |  |  |  | Do not populate
U$18, U$19, U$25, U$26 | ON Semiconductor | FAN4010IL6X-F113 |  | 4 | FAN4010IL6X_F113 | Current sense amplifier | Farnell | 2454632 | 0.341 | 38.192 | Alternative suppliers available | Yes | -40 to 85
U$2 | Texas Instruments | BQ24079RGTR |  | 1 | PVQFN16-THERM | Battery Charger for 1 Cell of Li-Ion battery | Farnell | 2492089 | 1.52 | 42.56 | Alternative suppliers available | Yes | -40 to 85
U$20 | Microchip | MCP1826S-3302E/DB |  | 1 | SOT223-3 | Fixed LDO Voltage Regulator | Farnell | 1578424 | 0.479 | 13.412 | Alternative suppliers available | Yes | -40 to 125
U$21 | NXP | MKL02Z16VFM4 |  | 1 | MKL02Z16VFM4 | Microcontroller | Farnell | 2409469 | 1.83 | 51.24 | Alternative suppliers available | Yes | -55 to 150
U$22 |  | TAG_CONNECT_NO_HOLES |  | 1 | TAG_CONNECT_NO_HOLES |  |  |  |  |  | Do not populate
U$24 | Everlight Electronics | EL3H7(TA)-VG |  | 1 | EL3H7 | Phototransistor photocoupler | Digi-key | 1080-1198-1-ND | 0.304 | 8.512 | Alternative suppliers available | Yes | -55 to 125
U$29 | ROHM Semiconductor | BD4835FVE-TR |  | 1 | VSOF5 | CMOS voltage monitor | Mouser | 755-BD4835FVE-TR | 0.339 | 9.492 | Or compatible alternative | Yes | -40 to 105
U$3 | Molex | 53047-0210 |  | 1 | PICOBLADE53047 | Wire-to-board header | Farnell | 9733051 | 0.119 | 3.332 | Alternative suppliers available | Yes | -40 to 85
U$4, U$10, U$14, U$17, U$31, U$32 | STMicroelectronics | BAT41 |  | 6 | SOD-123 | Schottky diode | Farnell | 9801421 | 0.12 | 20.16 | Alternative suppliers available | Yes | -60 to 125
U1 | Linear Technology | LTC4413EDD#TRPBF |  | 1 | DFN300X300X80-11N | Dual 2.6A, 2.5V to 5.5V, Ideal Diodes | Digi-key | LTC4413EDD#PBF-ND | 2.8424 | 79.5872 | Alternative suppliers available | Yes | -40 to 85
U10, U11, U12 | Texas Instruments | TPS22960DCNR |  | 3 | SOT65P280X145-8N | LOW INPUT VOLTAGE, DUAL LOAD SWITCH WITH CONTROLLED TURN-ON | Farnell | 3008910 | 0.621 | 52.164 | Alternative suppliers available | Yes | -40 to 85
U9 | Texas Instruments | TPS2553DRVT |  | 1 | SON65P200X200X80-7N | POWER-DISTRIBUTION SWITCHES | Mouser | 595-TPS2553DRVT | 1.45 | 40.6 | Alternative suppliers available | Yes | -40 to 85
 |  |  |  | Partlist exported from C:/Users/Ken.Diep/repos/hardware/Electronic/PCB Designs/EPS/EPS.sch at 08/08/2019 10:52
 |  |  |  |  |  |  |  |  |  | 862.006
