SatelliteApplicationsCatapult/PocketQube/hardware/Electronic/PCB Designs/OBC/Manufacture files/OBC_BOM.xlsx

Parts | Manufacturer | Part number | Value | Qty | Package | Description | Distributor | Order code | Notes | ROHS | Temp range
3V3, GND, GND6, PTA0, PTA1, PTA2, PTA3, RST, TP1, TP2, TP3, TP4, TP5, TP6, TP7, TP8, TP9, TP10, TP11, TP12, TP13, TP14, TP15, TP16 |  | PTR1TP06R |  | 24 | TP06R | TEST PIN |  |  | Do not populate
C1, C2, C9, C12, C13, C14, C16, C17 |  | C-EUC0402 | 0.1uF | 8 | C0402 | CAPACITOR, European symbol |  |  | Any compatible X7R MLCC
C11, C15 |  | C-EUC0603 | 2.2uF | 2 | C0603 | CAPACITOR, European symbol |  |  | Any compatible X7R MLCC
C3 |  | C-EUC0402 | 10nF | 1 | C0402 | CAPACITOR, European symbol |  |  | Any compatible X7R MLCC
C4, C5, C7 |  | C-EUC0805 | 10uF | 3 | C0805 | CAPACITOR, European symbol |  |  | Any compatible X7R MLCC
C6, C8 |  | C-EUC0603 | 1uF | 2 | C0603 | CAPACITOR, European symbol |  |  | Any compatible X7R MLCC
D1 | Kingbright | KPT-1608EC | Red | 1 | CHIPLED_0603 | LED | Farnell | 2099221RL | Or any compatible 0603 SMD low power red LED | Yes | -40 to 85
D2 | Kingbright | KPG-1608QBC-D | Blue | 1 | CHIPLED_0603 | LED | Farnell | 1686063RL | Or any compatible 0603 SMD low power blue LED | Yes | -40 to 85
D5 | Kingbright | KPTD-1608SYCK | Yellow | 1 | CHIPLED_0603 | LED | Farnell | 2449898 | Or any compatible 0603 SMD low power yellow LED | Yes | -40 to 85
ERASE | Panasonic | EVPAF7B70 |  | 1 | EVPAF7B70 | Tactile switch | Farnell | 2425605 | Alternative suppliers available | Yes | -40 to 85
FD1, FD2, FD3, FD4 |  | FIDUCIAL |  | 4 | FIDUCIAL_1MM | For use by pick and place machines to calibrate the vision/machine, 1mm |  |  | Do not populate
J2 | Molex | 47352-1001 |  | 1 | MOLEX_47352-1001 | 1.10mm Pitch microSD Card Connector, Push-Push Type, with VSS (Supply Voltage Ground) Detect Switch, Lead-Free | RS Components | 720-6016P | Alternative suppliers available | Yes | -20 to 85
L2, L3, L4 | Murata | BLM15HG601SN1 |  | 3 | 402 | EMIFIL (R) Chip Ferrite Bead for GHz Noise | RS Components | 724-1289P | Alternative suppliers available | Yes | -55 to 125
LSM9DS1 | STMicroelectronics | LSM9DS1TR |  | 1 | LGA24-8X4 | LSM9DS1 3D accelerometer, gyroscope & magnetometer | Mouser | 511-LSM9DS1TR | Alternative suppliers available | Yes | -40 to 85
NDK_NX3225SA | Epson | X1E0000210117 TSX-3225 16MHZ 9PF | 16MHz | 1 | 4SMD_DFN_LCC | 16 MHz SMD crystal | Farnell | 2471850 | Must be 16 MHz, 9 pF, ≤10ppm, 3.2x2.5 crystal | Yes | -20 to 75
PQ60_HEADER | Hirose | FX8C-60P-SV6(91) |  | 1 | FX8C-060P-SV4(92) | Header | Mouser | 798-FX8C60PSV691 | Alternative suppliers available, however ensure the FX8C60PSV6 part is used, not SV or SV2. | Yes
PQ60_RECEPTACLE |  | FX8C-060S-SV(92) |  | 1 | FX8C-060S-SV(92) |  |  |  | Do not populate | Yes
R1, R3 |  | RESISTOR0603-RES | 33R | 2 | 0603-RES | Resistor |  |  | Any standard chip SMD resistor, 1% tolerance or better
R12 |  | RESISTOR0402-RES | 10K | 1 | 0402-RES | Resistor |  |  | Any standard chip SMD resistor, 1% tolerance or better
R14, R15, R16, R17 |  | R-EU_R0402 | 10K | 4 | R0402 | RESISTOR, European symbol |  |  | Any standard chip SMD resistor, 1% tolerance or better
R2, R8 |  | R-EU_R0402 | 4.7K | 2 | R0402 | RESISTOR, European symbol |  |  | Any standard chip SMD resistor, 1% tolerance or better
R6, R7, R13 |  | RESISTOR0603-RES | 330R | 3 | 0603-RES | Resistor |  |  | Any standard chip SMD resistor, 1% tolerance or better
R9, R10, R11 |  | R-EU_R0402 | 22K | 3 | R0402 | RESISTOR, European symbol |  |  | Any standard chip SMD resistor, 1% tolerance or better
SJ3 |  | SJNC |  | 1 | SJNC | Solder jumper |  |  | Do not populate
U$1 | NXP | MKL02Z32VFG4SMD |  | 1 | QFN16 | Kinetis KL02 32 KB Flash |  |  | This must be pre-programmed with Teensy bootloader. We will supply this component.
U$11 | Molex | 105017-0001 |  | 1 | USB-MICRO-TABS | Micro USB type B connector | Farnell | 2293836 | Alternative suppliers available | Yes | -30 to 85
U$3 | Nexperia | PMV40UN2R |  | 1 | SOT23-3 | N-channel trench MOSFET | Mouser | 771-PMV40UN2R | Alternative suppliers available | Yes | -55 to 150
U$4 | NXP | MK20DX256VLH7 |  | 1 | QFP50P1200X1200X160-64N | This is a footprint for the MK20dx256VHL7, the chip at the heart of the Teensy 3.1 | Farnell | 2133577 | Alternative suppliers available. | Yes | -40 to 105
U$9 |  | SWD_10_PIN |  | 1 | SWD_10_PIN |  |  |  | Do not populate
U.FL | Hirose | U.FL-R-SMT-1(10) |  | 1 | U.FL | SMD antenna connector- WRL-09144 | Farnell | 1688077 | Alternative suppliers available | Yes | -40 to 90
U1 | SparkFun | COM-13910 |  | 1 | RFM69HCW-XXXS2 | Wireless transceiver | Mouser | 474-COM-13910 | Alternative suppliers available but must be 433 MHz, HCW variant | Yes | -55 to 115
 |  |  |  | Partlist exported from C:/Users/Ken.Diep/repos/hardware/Electronic/PCB Designs/OBC/OBC.sch at 08/08/2019 13:57
