SatelliteApplicationsCatapult/PocketQube/hardware/Electronic/PCB Designs/PSB/Manufacture files/PSB BOM.xlsx

Qty | Value | Device | Package | Parts | Description | Supplier | Order code | Price per | Total | Notes
2 |  | PINHD-1X9 | 1X09-BIG | JP2, JP5 | Pin header 1x10 0.1 spacing" |  |  |  | 0 | Do not populate
1 |  | PINHD-2X6 | 2X06-CLEANBIG | JP1 | PIN HEADER |  |  |  | 0 | Do not populate
1 |  | SJ | SJ | SJ1 | SMD solder JUMPER |  |  |  | 0 | Do not populate
5 | 220R | R-EU_R0402 | R0402 | R1, R5, R8, R9, R10 | RESISTOR, European symbol |  |  |  | 0
2 | 330R | R-EU_R0402 | R0402 | R6, R7 | RESISTOR, European symbol |  |  |  | 0
4 | FIDUCIAL | FIDUCIAL | FIDUCIAL_1MM | FD1, FD2, FD3, FD4 | For use by pick and place machines to calibrate the vision/machine, 1mm |  |  |  | 0 | Do not populate
1 | FX8C-060P-SV(91) | FX8C-060P-SV(91) | FX8C-060P-SV(91) | H2 |  |  |  |  | 0 | Do not populate
1 | FX8C-060P-SV(91) | FX8C-060P-SV(91) | FX8C-060S-SV(91) | H1 |  | Farnell |  | 2.7516 | 77.0448 | Other suppliers available
1 | JST-PH_4-PIN_HEADER | JST-PH_4-PIN_HEADER | JST_B4B-PH_HEADER | J5 | 4-pin JST PH Shrouded Header, top entry | Farnell | 9492437 | 0.112 | 11.2 | Other suppliers available
1 | JST-PH_4-PIN_HEADER | JST-PH_4-PIN_HEADER | JST_B4B-PH_HEADER | J6 | 4-pin JST PH Shrouded Header, top entry |  |  |  | 0 | Do not populate
1 | LED-0402 | LED-0402 | 0402-LED | BLUE |  |  |  |  | 0 | Any 0402 blue LED
3 | LED-0402 | LED-0402 | 0402-LED | GREEB@2, GREEN@1, GREEN@3 |  |  |  |  | 0 | Any 0402 green LED
1 | LED-0402 | LED-0402 | 0402-LED | RED |  |  |  |  | 0 | Any 0402 red LED
2 | LED-0402 | LED-0402 | 0402-LED | YELLOW@1, YELLOW@2 |  |  |  |  | 0 | Any 0402 yellow LED
1 | SI1146 | SI1146 | QFN-10 | IC1 | PROXIMITY/UV/AMBIENT LIGHT SENSOR IC WITH I2C INTERFACE | Digikey | 336-2623-1-ND | 3.1136 | 87.1808 | Available from other suppliers, but must be A10 variant
1 | TMP102AIDRLT | TMP102AIDRLT | SOT50P160X60-6N | U1 | Temperature Sensor | Farnell | 1652477 | 1 | 28 | Available from other suppliers
 |  |  |  |  |  |  |  |  | 203.4256
