SatelliteApplicationsCatapult/PocketQube/hardware/Electronic/PCB Designs/RFP/Manufacture files/RFP_BOM.xlsx

Qty | Value | Device | Package | Parts | Description | Supplier | Order number | Notes
4 | 2MMPILLAR | 2MMPILLAR | 2MMPILLAR | U$5, U$6, U$7, U$8 |  |  |  | Do not populate
1 | ANTENNA | ANTENNA_U.FL | U.FL | ANTENNA | U.FL Antenna Connector | Farnell | 1688077 | Or compatible alternative
4 | FIDUCIAL | FIDUCIAL | FIDUCIAL_1MM | FD1, FD2, FD3, FD4 | For use by pick and place machines to calibrate the vision/machine, 1mm |  |  | Do not populate
1 | TPSQTP20SQ | TPSQTP20SQ | TP20SQ | RADIATOR | Test pad |  |  | Do not populate
