SatelliteApplicationsCatapult/PocketQube/hardware/Electronic/Sketchup Component Models/Models/CAM01.png

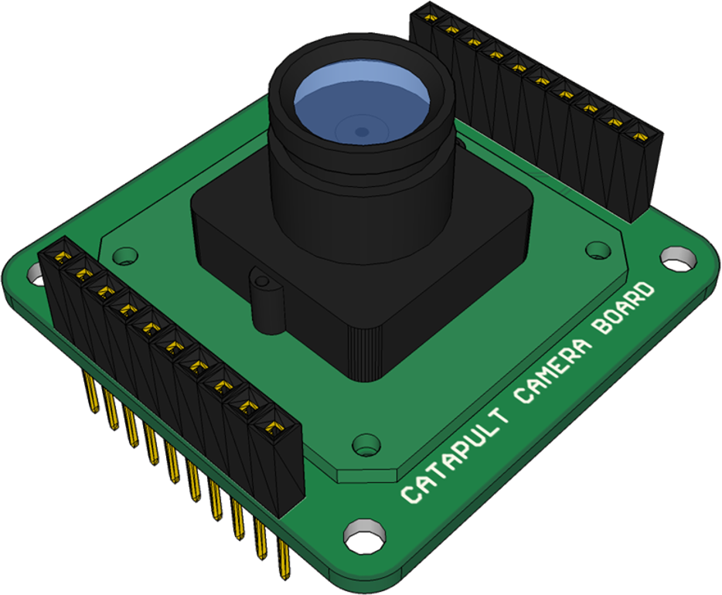
hardware/Electronic/Sketchup Component Models/Models/CAM01.png
