SatelliteApplicationsCatapult/PocketQube/hardware/Electronic/Sketchup Component Models/Models/OBC1.png

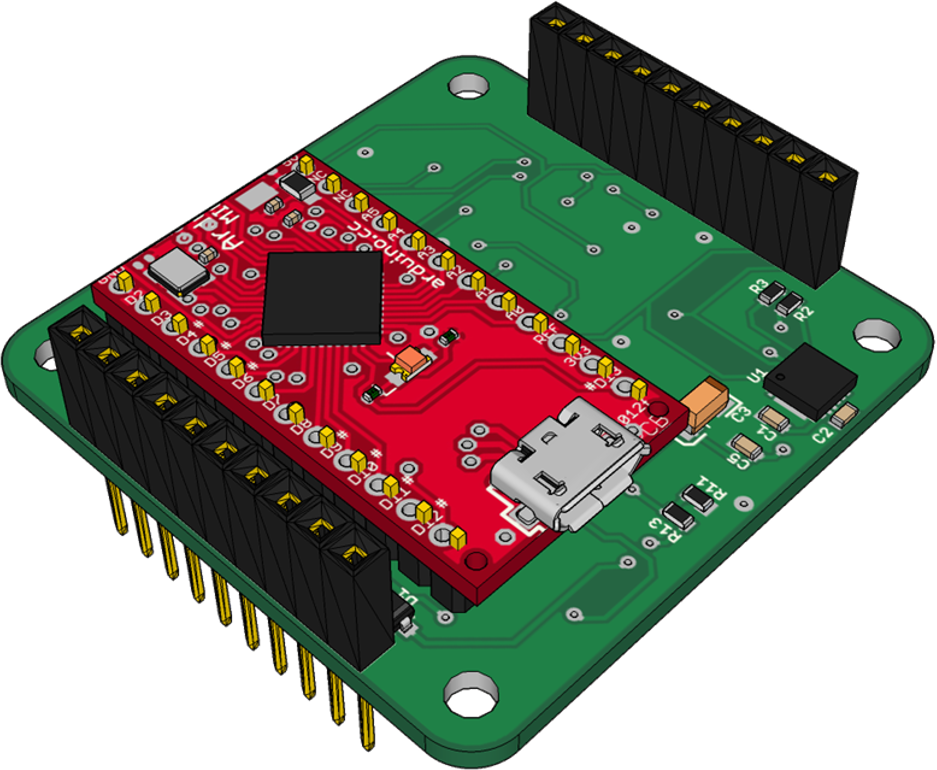
hardware/Electronic/Sketchup Component Models/Models/OBC1.png
