SatelliteApplicationsCatapult/PocketQube/hardware/Electronic/Sketchup Component Models/Models/PocketQube structure.png

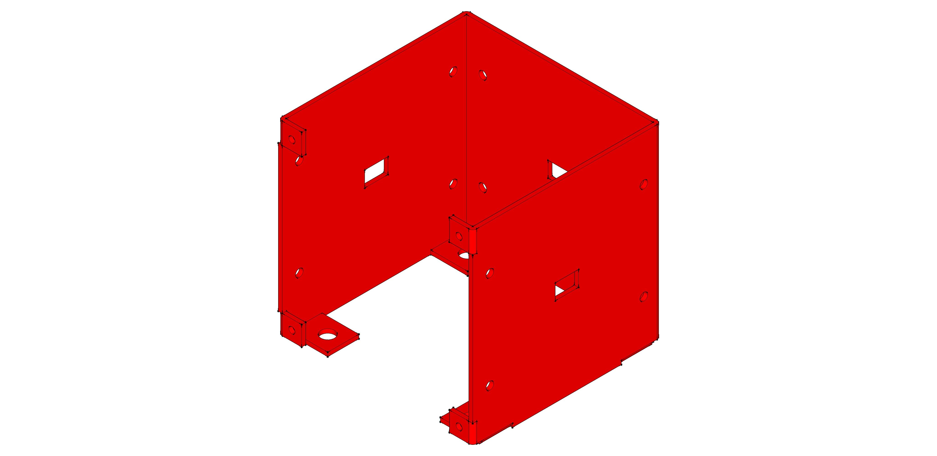
hardware/Electronic/Sketchup Component Models/Models/PocketQube structure.png
