SatelliteApplicationsCatapult/PocketQube/hardware/Electronic/Sketchup Component Models/Models/PSIMU_bottom.png

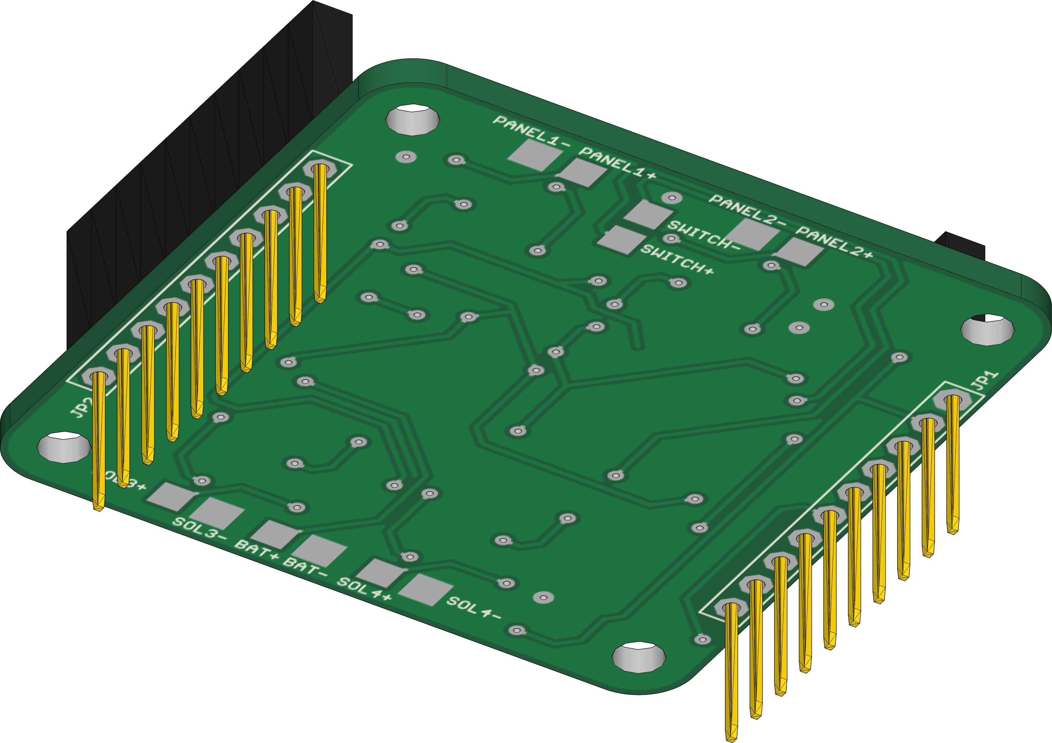
hardware/Electronic/Sketchup Component Models/Models/PSIMU_bottom.png
