SatelliteApplicationsCatapult/PocketQube/hardware/Electronic/Sketchup Component Models/Models/PSIMU_top.png

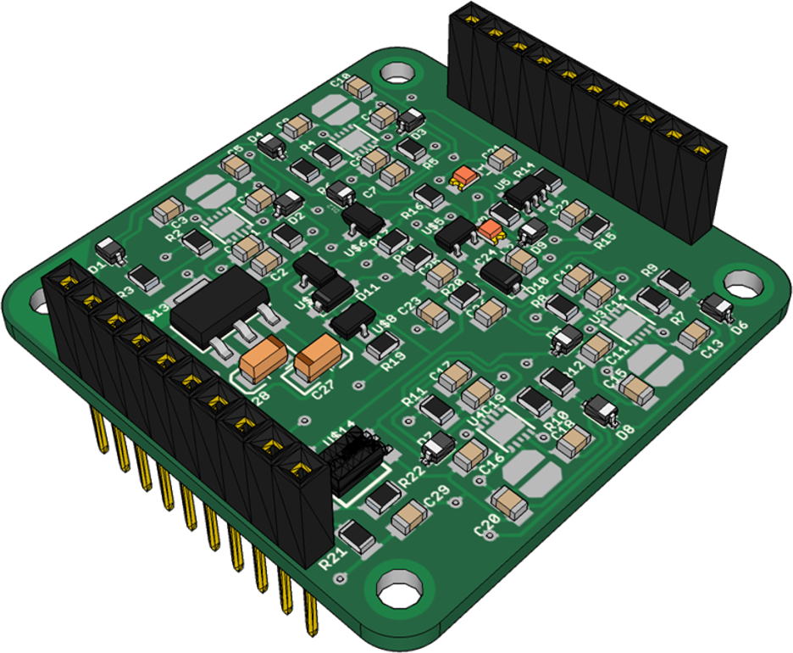
hardware/Electronic/Sketchup Component Models/Models/PSIMU_top.png
