SatelliteApplicationsCatapult/PocketQube/hardware/Electronic/Sketchup Component Models/Models/SNS01.png

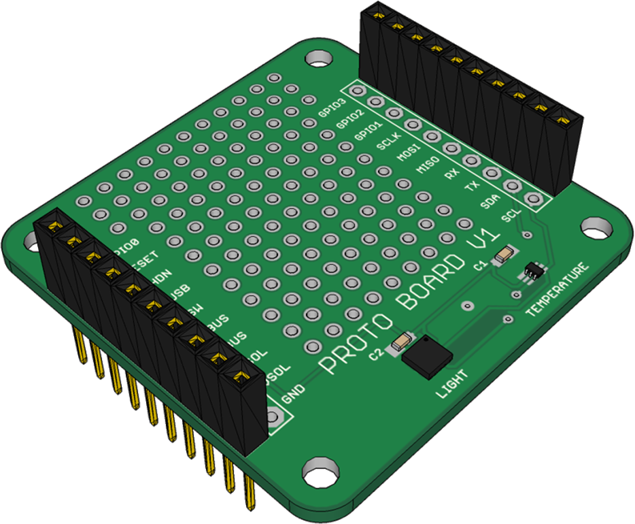
hardware/Electronic/Sketchup Component Models/Models/SNS01.png
