SatelliteApplicationsCatapult/PocketQube/hardware/Electronic/Sketchup Component Models/Textures/IXYS_front.jpg

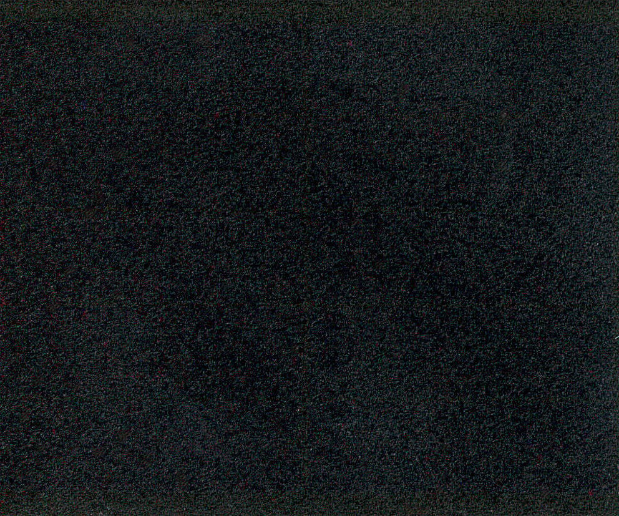
hardware/Electronic/Sketchup Component Models/Textures/IXYS_front.jpg
