SatelliteApplicationsCatapult/PocketQube/hardware/Electronic/Sketchup Component Models/Textures/TASC texture.png

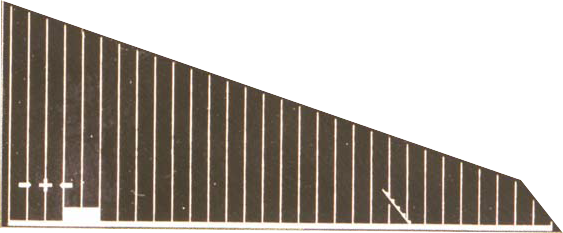
hardware/Electronic/Sketchup Component Models/Textures/TASC texture.png
