SatelliteApplicationsCatapult/PocketQube/hardware/Electronic/Sketchup Component Models/Models/CAM01.stl

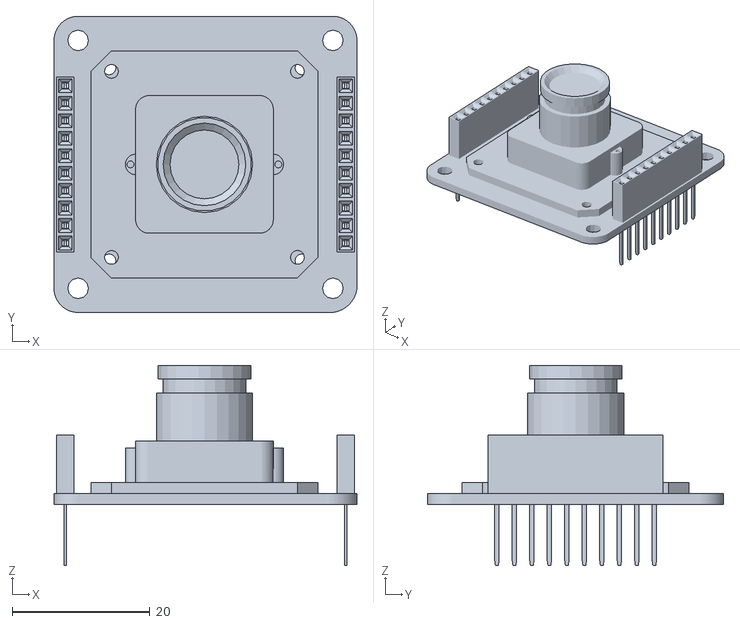
[picture p28: CAD file, 2022-01-14]
hardware/Electronic/Sketchup Component Models/Models/CAM01.stl
44.0 x 43.0 x 29.1
