SatelliteApplicationsCatapult/PocketQube/hardware/Structure/Fusion/top_cap v11.stl

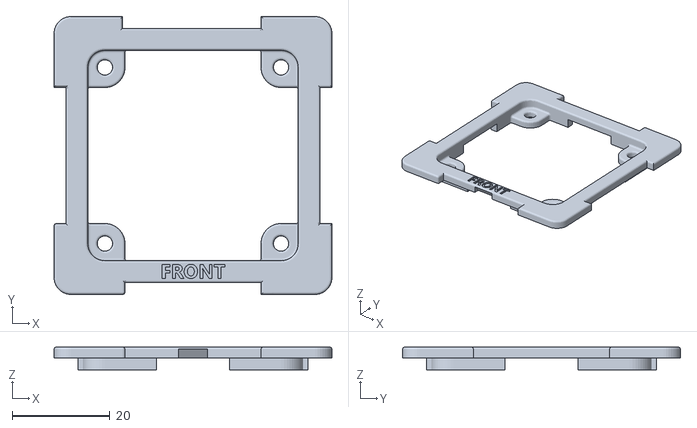
[picture p29: CAD file, 2022-01-14]
hardware/Structure/Fusion/top_cap v11.stl
56.8 x 56.8 x 4.70
