SatelliteApplicationsCatapult/PocketQube/hardware/Structure/Solidworks/pillar.SLDPRT

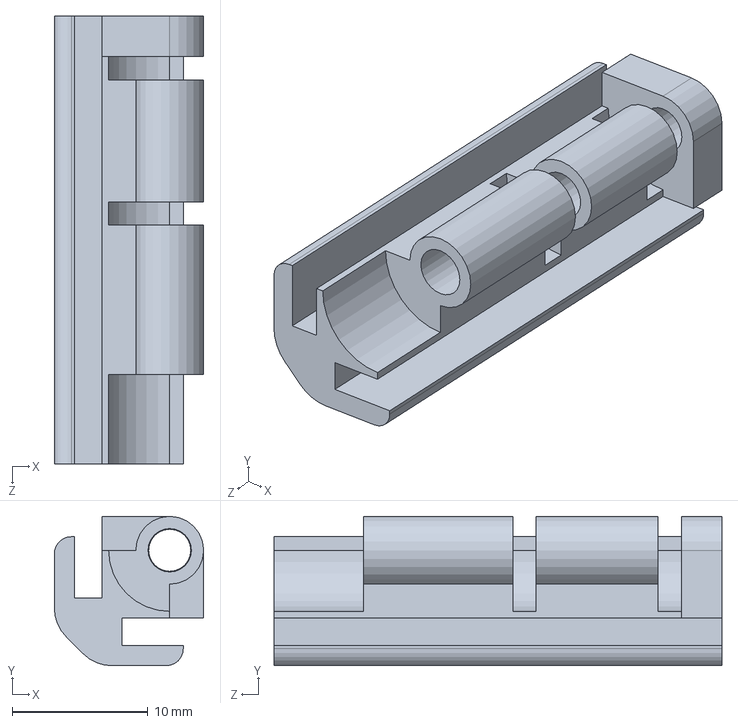
[picture p30: CAD file, 2022-01-14]
hardware/Structure/Solidworks/pillar.SLDPRT
11.0 x 11.0 x 33.0 mm
