SatelliteApplicationsCatapult/PocketQube/hardware/Structure/Fusion/pillar v21.stl

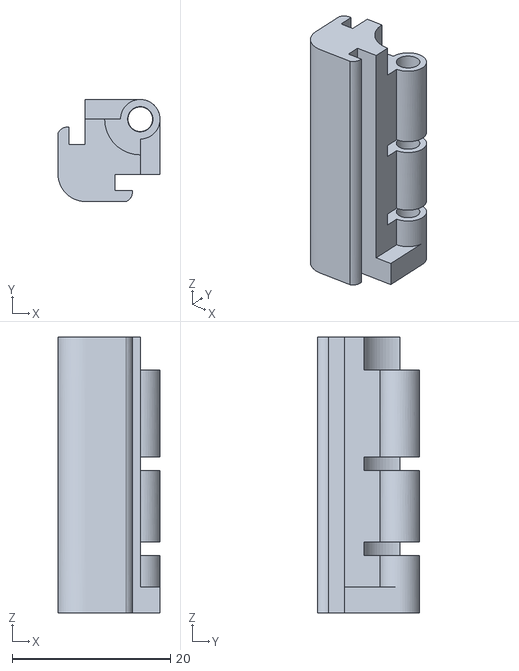
[picture p31: CAD file, 2022-01-14]
hardware/Structure/Fusion/pillar v21.stl
12.9 x 12.9 x 34.9
