SatelliteApplicationsCatapult/PocketQube/hardware/Structure/Fusion/bottom_cap v20.stl

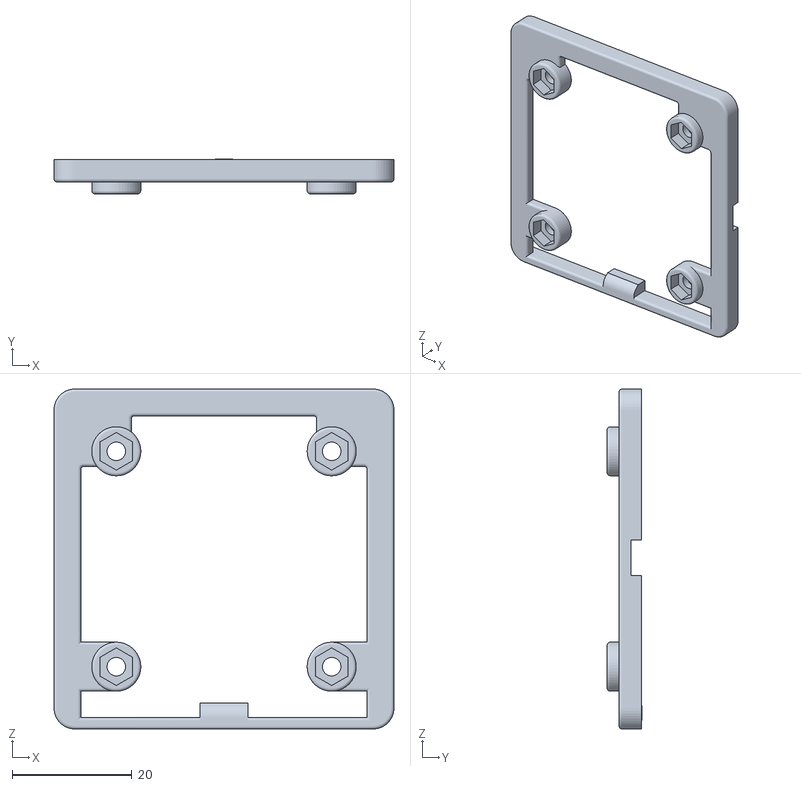
[picture p32: CAD file, 2022-01-14]
hardware/Structure/Fusion/bottom_cap v20.stl
56.8 x 5.80 x 56.8
