SatelliteApplicationsCatapult/PocketQube/hardware/Structure/Solidworks/top_cap.SLDPRT

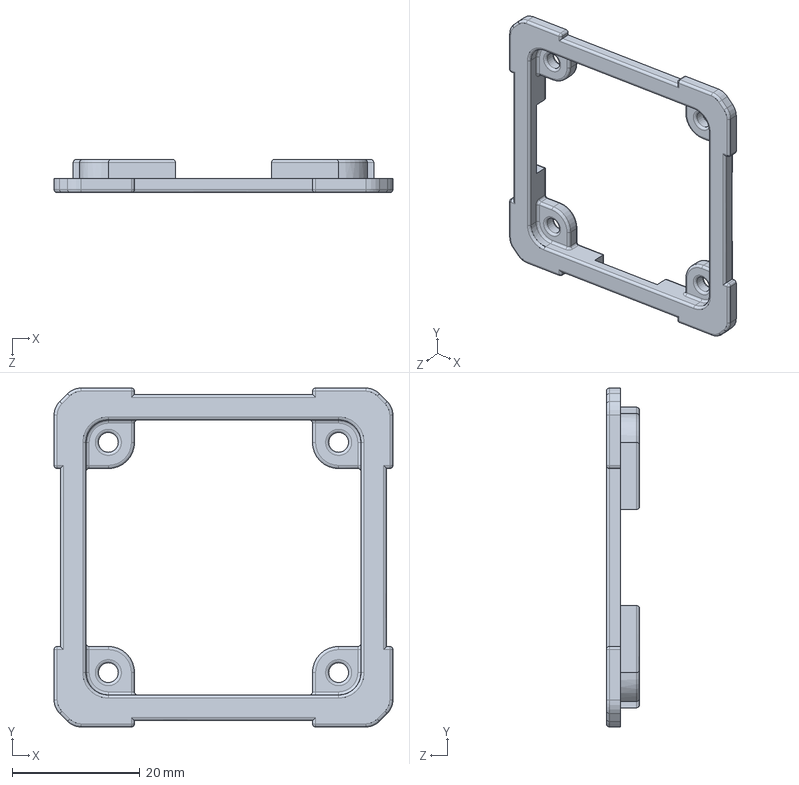
[picture p33: CAD file, 2022-01-14]
hardware/Structure/Solidworks/top_cap.SLDPRT
53.0 x 53.0 x 5.20 mm
