SatelliteApplicationsCatapult/PocketQube/hardware/Structure/Solidworks/bottom_cap.SLDPRT

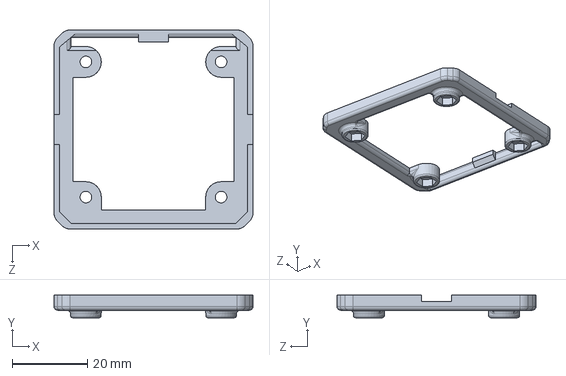
[picture p34: CAD file, 2022-01-14]
hardware/Structure/Solidworks/bottom_cap.SLDPRT
53.0 x 6.00 x 53.0 mm
