SatelliteApplicationsCatapult/PocketQube/hardware/Structure/Solidworks/M3 x 0.5mm Thread 40mm LONG SOCKET HEAD CAP SCREW.STEP

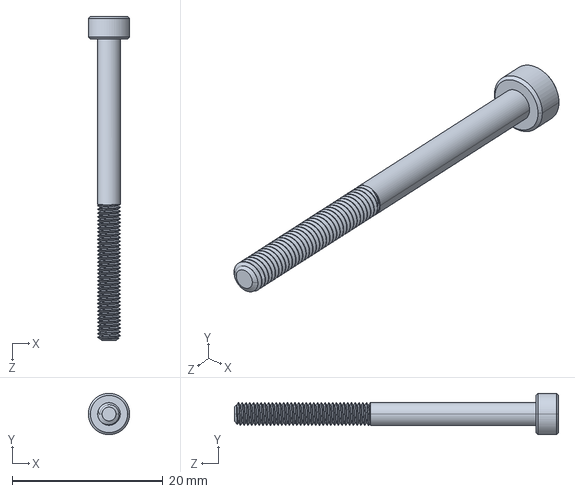
[picture p35: CAD file, 2022-01-14]
hardware/Structure/Solidworks/M3 x 0.5mm Thread 40mm LONG SOCKET HEAD CAP SCREW.STEP
5.50 x 5.50 x 43.0 mm
