SatelliteApplicationsCatapult/PocketQube/hardware/Structure/Solidworks/M3 x 0.5mm Thread HEX NUT.STEP

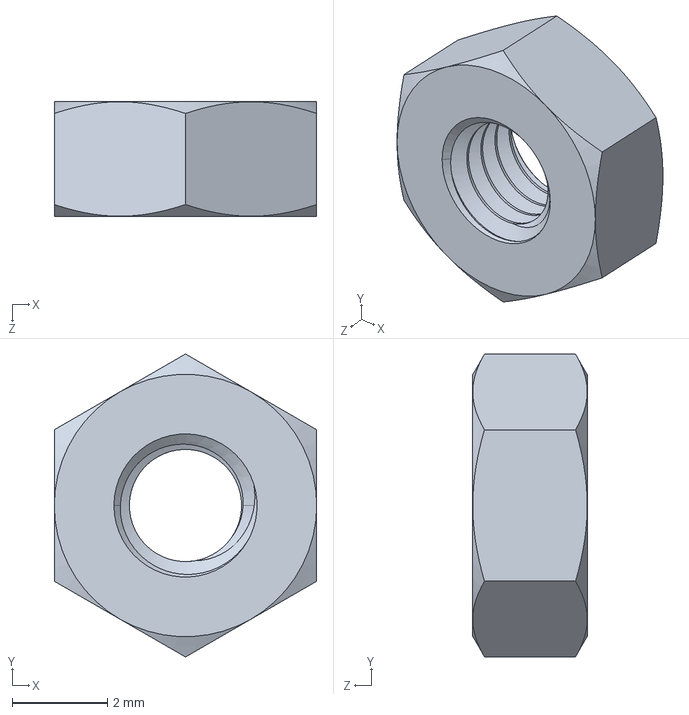
[picture p36: CAD file, 2022-01-14]
hardware/Structure/Solidworks/M3 x 0.5mm Thread HEX NUT.STEP
5.50 x 6.35 x 2.40 mm
