SatelliteApplicationsCatapult/PocketQube/(list of files, cad)

Other CAD files:
hardware/Electronic/PCB Designs/PSB/Sketchup/PSB.skp
hardware/Electronic/PCB Designs/RFP/Sketchup/RFP.skp
hardware/Electronic/Sketchup Component Models/0402-LED.skp
hardware/Electronic/Sketchup Component Models/1734037-1.skp
hardware/Electronic/Sketchup Component Models/1X10-SHORT.skp
hardware/Electronic/Sketchup Component Models/1X10.skp
hardware/Electronic/Sketchup Component Models/1X5_127.skp
hardware/Electronic/Sketchup Component Models/3D_Models/0402.skp
hardware/Electronic/Sketchup Component Models/3D_Models/4SMD_DFN_LCC.skp
hardware/Electronic/Sketchup Component Models/3D_Models/ABS25.skp
hardware/Electronic/Sketchup Component Models/3D_Models/DFN300X300X80-11N.skp
hardware/Electronic/Sketchup Component Models/3D_Models/DFN300X300X80-15N.skp
hardware/Electronic/Sketchup Component Models/3D_Models/EL3H7.skp
hardware/Electronic/Sketchup Component Models/3D_Models/FAN4010IL6X_F113.skp
hardware/Electronic/Sketchup Component Models/3D_Models/MKL02Z16VFM4.skp
hardware/Electronic/Sketchup Component Models/3D_Models/MKL02Z32VFM4.skp
hardware/Electronic/Sketchup Component Models/3D_Models/PVQFN16-THERM.skp
hardware/Electronic/Sketchup Component Models/3D_Models/QFN-24.skp
hardware/Electronic/Sketchup Component Models/3D_Models/QFN-44-NOPAD.skp
hardware/Electronic/Sketchup Component Models/3D_Models/QFN50P500X500X100-33N.skp
hardware/Electronic/Sketchup Component Models/3D_Models/QFP50P1200X1200X160-64N.skp
hardware/Electronic/Sketchup Component Models/3D_Models/QFP80P900X900X120-32N.skp
hardware/Electronic/Sketchup Component Models/3D_Models/R0402.skp
hardware/Electronic/Sketchup Component Models/3D_Models/SC-70.skp
hardware/Electronic/Sketchup Component Models/3D_Models/SON65P200X200X80-7N.skp
hardware/Electronic/Sketchup Component Models/3D_Models/SOT23-3.skp
hardware/Electronic/Sketchup Component Models/3D_Models/SOT65P280X145-8N.skp
hardware/Electronic/Sketchup Component Models/3D_Models/SOT95P280X145-5N.skp
hardware/Electronic/Sketchup Component Models/3D_Models/SOT_323-5.skp
hardware/Electronic/Sketchup Component Models/3D_Models/SSOP5.skp
hardware/Electronic/Sketchup Component Models/3D_Models/WE-TPC-744031100.skp
hardware/Electronic/Sketchup Component Models/3D_Models/XDFN8.skp
hardware/Electronic/Sketchup Component Models/3M-961210-5500.skp
hardware/Electronic/Sketchup Component Models/8mm pillar clip.skp
hardware/Electronic/Sketchup Component Models/961102-5604-AR.skp
hardware/Electronic/Sketchup Component Models/9Vbatt.skp
hardware/Electronic/Sketchup Component Models/AB26TRQ.skp
hardware/Electronic/Sketchup Component Models/B2B-ZR-SM4-TF.skp
hardware/Electronic/Sketchup Component Models/B2B-ZR.skp
hardware/Electronic/Sketchup Component Models/B4B-PH-K-S.skp
hardware/Electronic/Sketchup Component Models/C0603.skp
hardware/Electronic/Sketchup Component Models/C1206.skp
hardware/Electronic/Sketchup Component Models/CHIPLED_0603.skp
hardware/Electronic/Sketchup Component Models/DFN-3X3.skp
hardware/Electronic/Sketchup Component Models/DMP1045U.skp
hardware/Electronic/Sketchup Component Models/Dangerous Prototypes/0402-CAP.skp
hardware/Electronic/Sketchup Component Models/Dangerous Prototypes/0402-RES.skp
hardware/Electronic/Sketchup Component Models/Dangerous Prototypes/1X03.skp
hardware/Electronic/Sketchup Component Models/Dangerous Prototypes/1X06.skp
hardware/Electronic/Sketchup Component Models/Dangerous Prototypes/1x10_PinHeader.skp
hardware/Electronic/Sketchup Component Models/Dangerous Prototypes/2X05.skp
hardware/Electronic/Sketchup Component Models/Dangerous Prototypes/4X6@1.skp
hardware/Electronic/Sketchup Component Models/Dangerous Prototypes/C0402.skp
hardware/Electronic/Sketchup Component Models/Dangerous Prototypes/C0603.skp
hardware/Electronic/Sketchup Component Models/Dangerous Prototypes/C0805.skp
hardware/Electronic/Sketchup Component Models/Dangerous Prototypes/C1206.skp
hardware/Electronic/Sketchup Component Models/Dangerous Prototypes/C603.skp
hardware/Electronic/Sketchup Component Models/Dangerous Prototypes/C805.skp
hardware/Electronic/Sketchup Component Models/Dangerous Prototypes/CHIP-LED0805.skp
hardware/Electronic/Sketchup Component Models/Dangerous Prototypes/CHIPLED_0805.skp
hardware/Electronic/Sketchup Component Models/Dangerous Prototypes/CONN_USB_MINI-B.skp
hardware/Electronic/Sketchup Component Models/Dangerous Prototypes/CW8A.skp
hardware/Electronic/Sketchup Component Models/Dangerous Prototypes/D2PACK.skp
hardware/Electronic/Sketchup Component Models/Dangerous Prototypes/DEC.skp
hardware/Electronic/Sketchup Component Models/Dangerous Prototypes/DIL-08.skp
hardware/Electronic/Sketchup Component Models/Dangerous Prototypes/DIL06.skp
hardware/Electronic/Sketchup Component Models/Dangerous Prototypes/DO323.skp
hardware/Electronic/Sketchup Component Models/Dangerous Prototypes/DO35-7.skp
hardware/Electronic/Sketchup Component Models/Dangerous Prototypes/DO41-7.6.skp
hardware/Electronic/Sketchup Component Models/Dangerous Prototypes/EIA3216.skp
hardware/Electronic/Sketchup Component Models/Dangerous Prototypes/EIA3528.skp
hardware/Electronic/Sketchup Component Models/Dangerous Prototypes/EIA6032.skp
hardware/Electronic/Sketchup Component Models/Dangerous Prototypes/EIA7343.skp
hardware/Electronic/Sketchup Component Models/Dangerous Prototypes/F1X1.skp
hardware/Electronic/Sketchup Component Models/Dangerous Prototypes/F1X10.skp
hardware/Electronic/Sketchup Component Models/Dangerous Prototypes/F1X11.skp
hardware/Electronic/Sketchup Component Models/Dangerous Prototypes/F1X12.skp
hardware/Electronic/Sketchup Component Models/Dangerous Prototypes/F1X13.skp
hardware/Electronic/Sketchup Component Models/Dangerous Prototypes/F1X14.skp
hardware/Electronic/Sketchup Component Models/Dangerous Prototypes/F1X15.skp
hardware/Electronic/Sketchup Component Models/Dangerous Prototypes/F1X16.skp
hardware/Electronic/Sketchup Component Models/Dangerous Prototypes/F1X17.skp
hardware/Electronic/Sketchup Component Models/Dangerous Prototypes/F1X18.skp
hardware/Electronic/Sketchup Component Models/Dangerous Prototypes/F1X19.skp
hardware/Electronic/Sketchup Component Models/Dangerous Prototypes/F1X2.skp
hardware/Electronic/Sketchup Component Models/Dangerous Prototypes/F1X20.skp
hardware/Electronic/Sketchup Component Models/Dangerous Prototypes/F1X3.skp
hardware/Electronic/Sketchup Component Models/Dangerous Prototypes/F1X4.skp
hardware/Electronic/Sketchup Component Models/Dangerous Prototypes/F1X5.skp
hardware/Electronic/Sketchup Component Models/Dangerous Prototypes/F1X6.skp
hardware/Electronic/Sketchup Component Models/Dangerous Prototypes/F1X7.skp
hardware/Electronic/Sketchup Component Models/Dangerous Prototypes/F1X8.skp
hardware/Electronic/Sketchup Component Models/Dangerous Prototypes/F1X9.skp
hardware/Electronic/Sketchup Component Models/Dangerous Prototypes/FB603.skp
hardware/Electronic/Sketchup Component Models/Dangerous Prototypes/Ferrite0805.skp
hardware/Electronic/Sketchup Component Models/Dangerous Prototypes/HC49U.skp
hardware/Electronic/Sketchup Component Models/Dangerous Prototypes/HC49UP.skp
hardware/Electronic/Sketchup Component Models/Dangerous Prototypes/HC49US.skp
hardware/Electronic/Sketchup Component Models/Dangerous Prototypes/HR911105A.skp
hardware/Electronic/Sketchup Component Models/Dangerous Prototypes/IC socket.skp
hardware/Electronic/Sketchup Component Models/Dangerous Prototypes/LED-0603.skp
hardware/Electronic/Sketchup Component Models/Dangerous Prototypes/LED-805.skp
hardware/Electronic/Sketchup Component Models/Dangerous Prototypes/LED5MM.skp
hardware/Electronic/Sketchup Component Models/Dangerous Prototypes/LQFP64.skp
hardware/Electronic/Sketchup Component Models/Dangerous Prototypes/LSH43.skp
hardware/Electronic/Sketchup Component Models/Dangerous Prototypes/M0805.skp
hardware/Electronic/Sketchup Component Models/Dangerous Prototypes/M1206.skp
hardware/Electronic/Sketchup Component Models/Dangerous Prototypes/M1X2.skp
hardware/Electronic/Sketchup Component Models/Dangerous Prototypes/MA03-2.skp
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
