SatelliteApplicationsCatapult/PocketQube/hardware/Electronic/Sketchup Component Models/Drawings/ENG_CD_1734037_G1.pdf

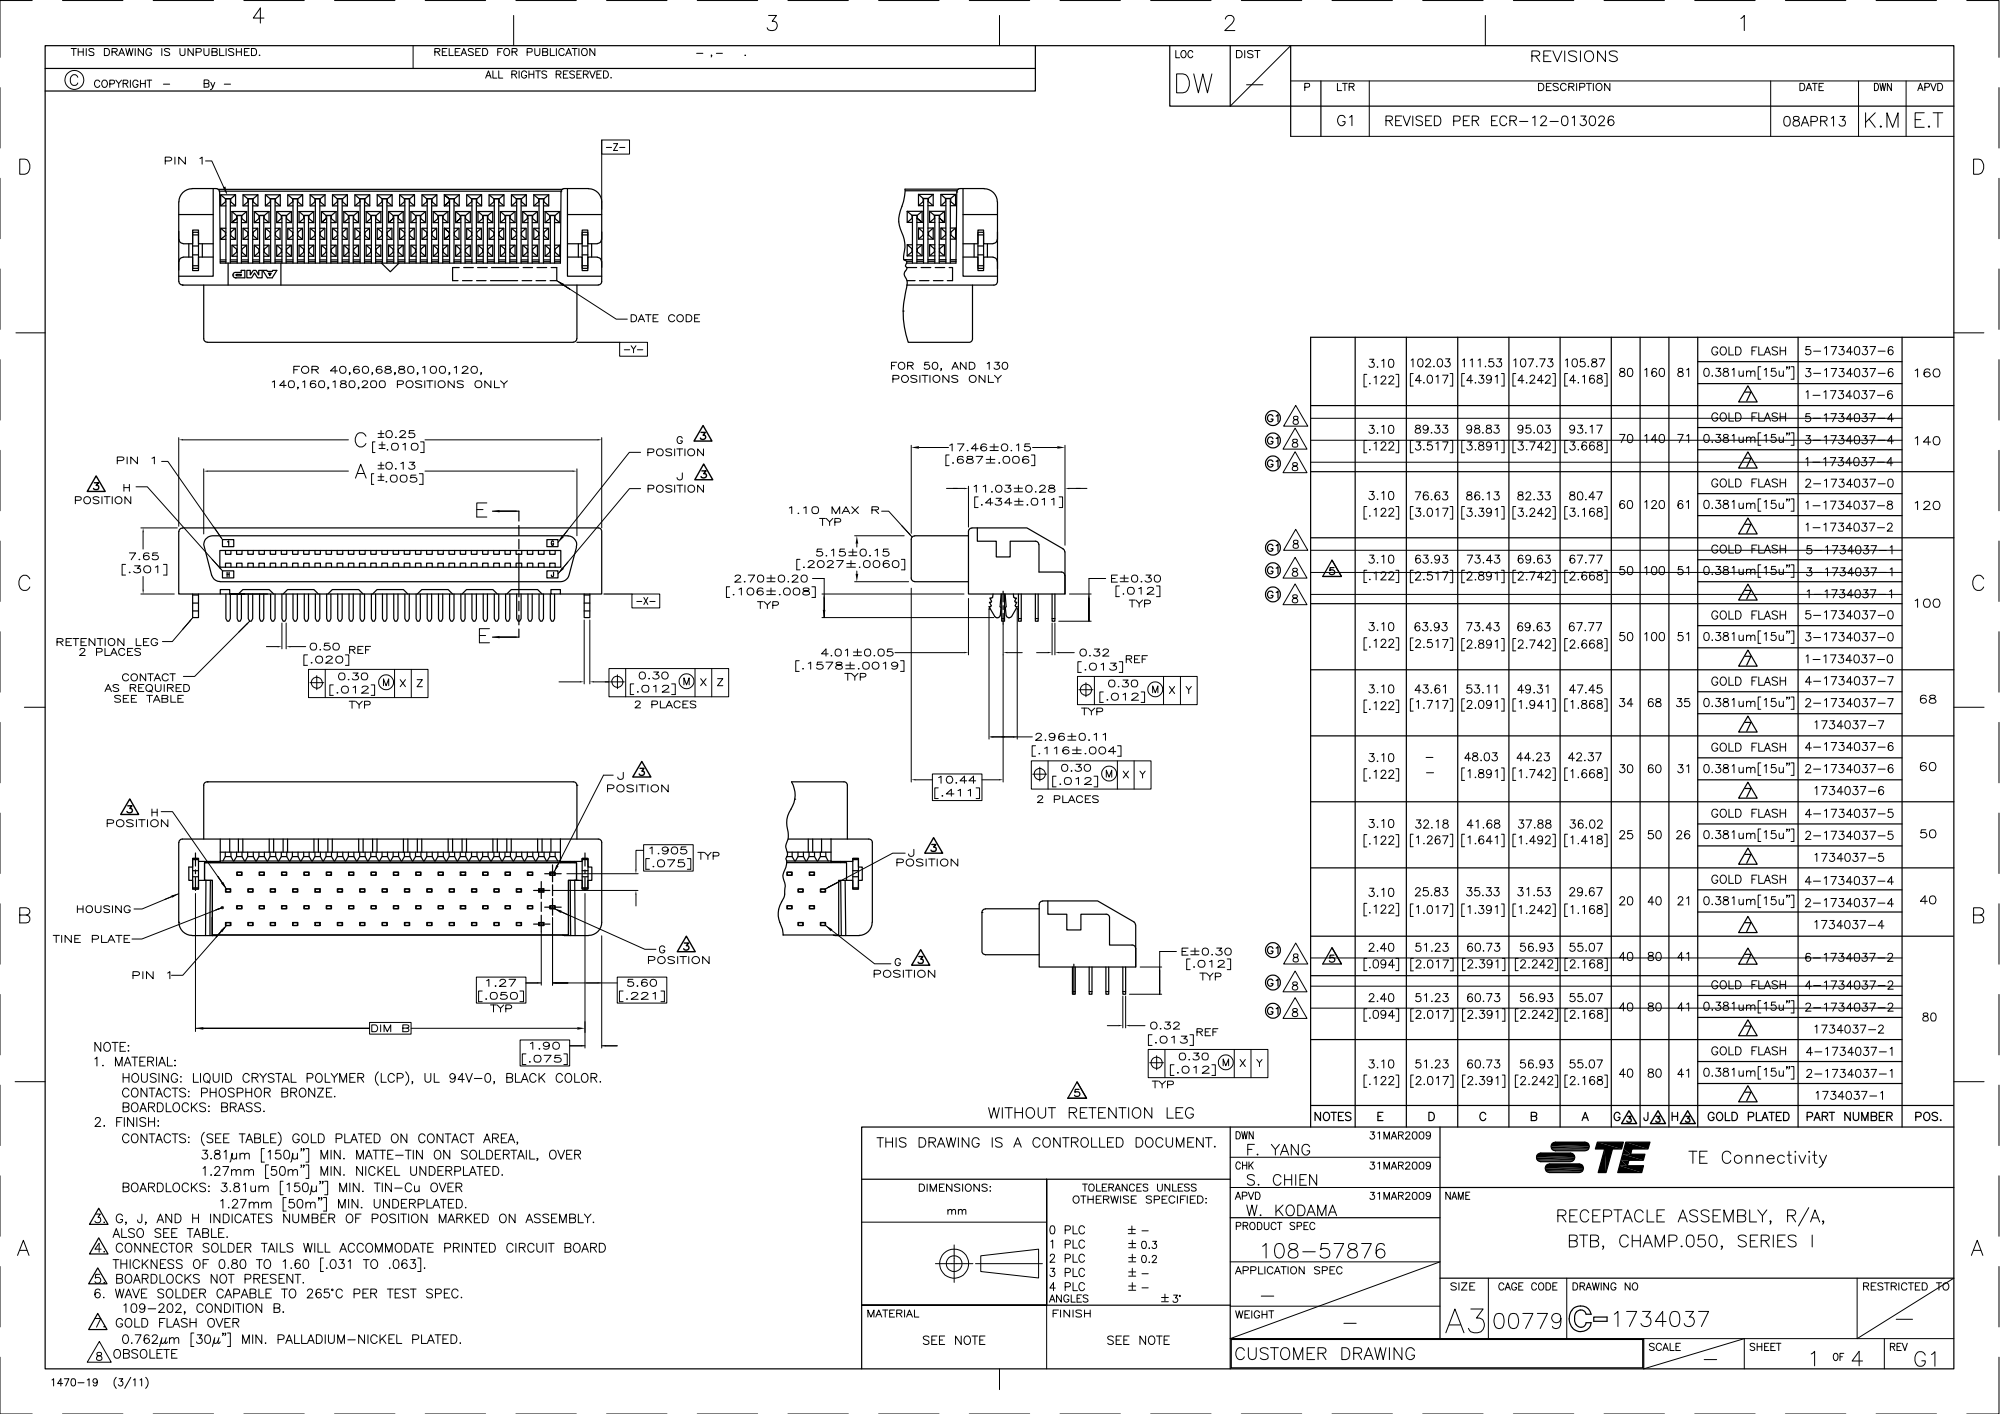
[picture p37: page 1]

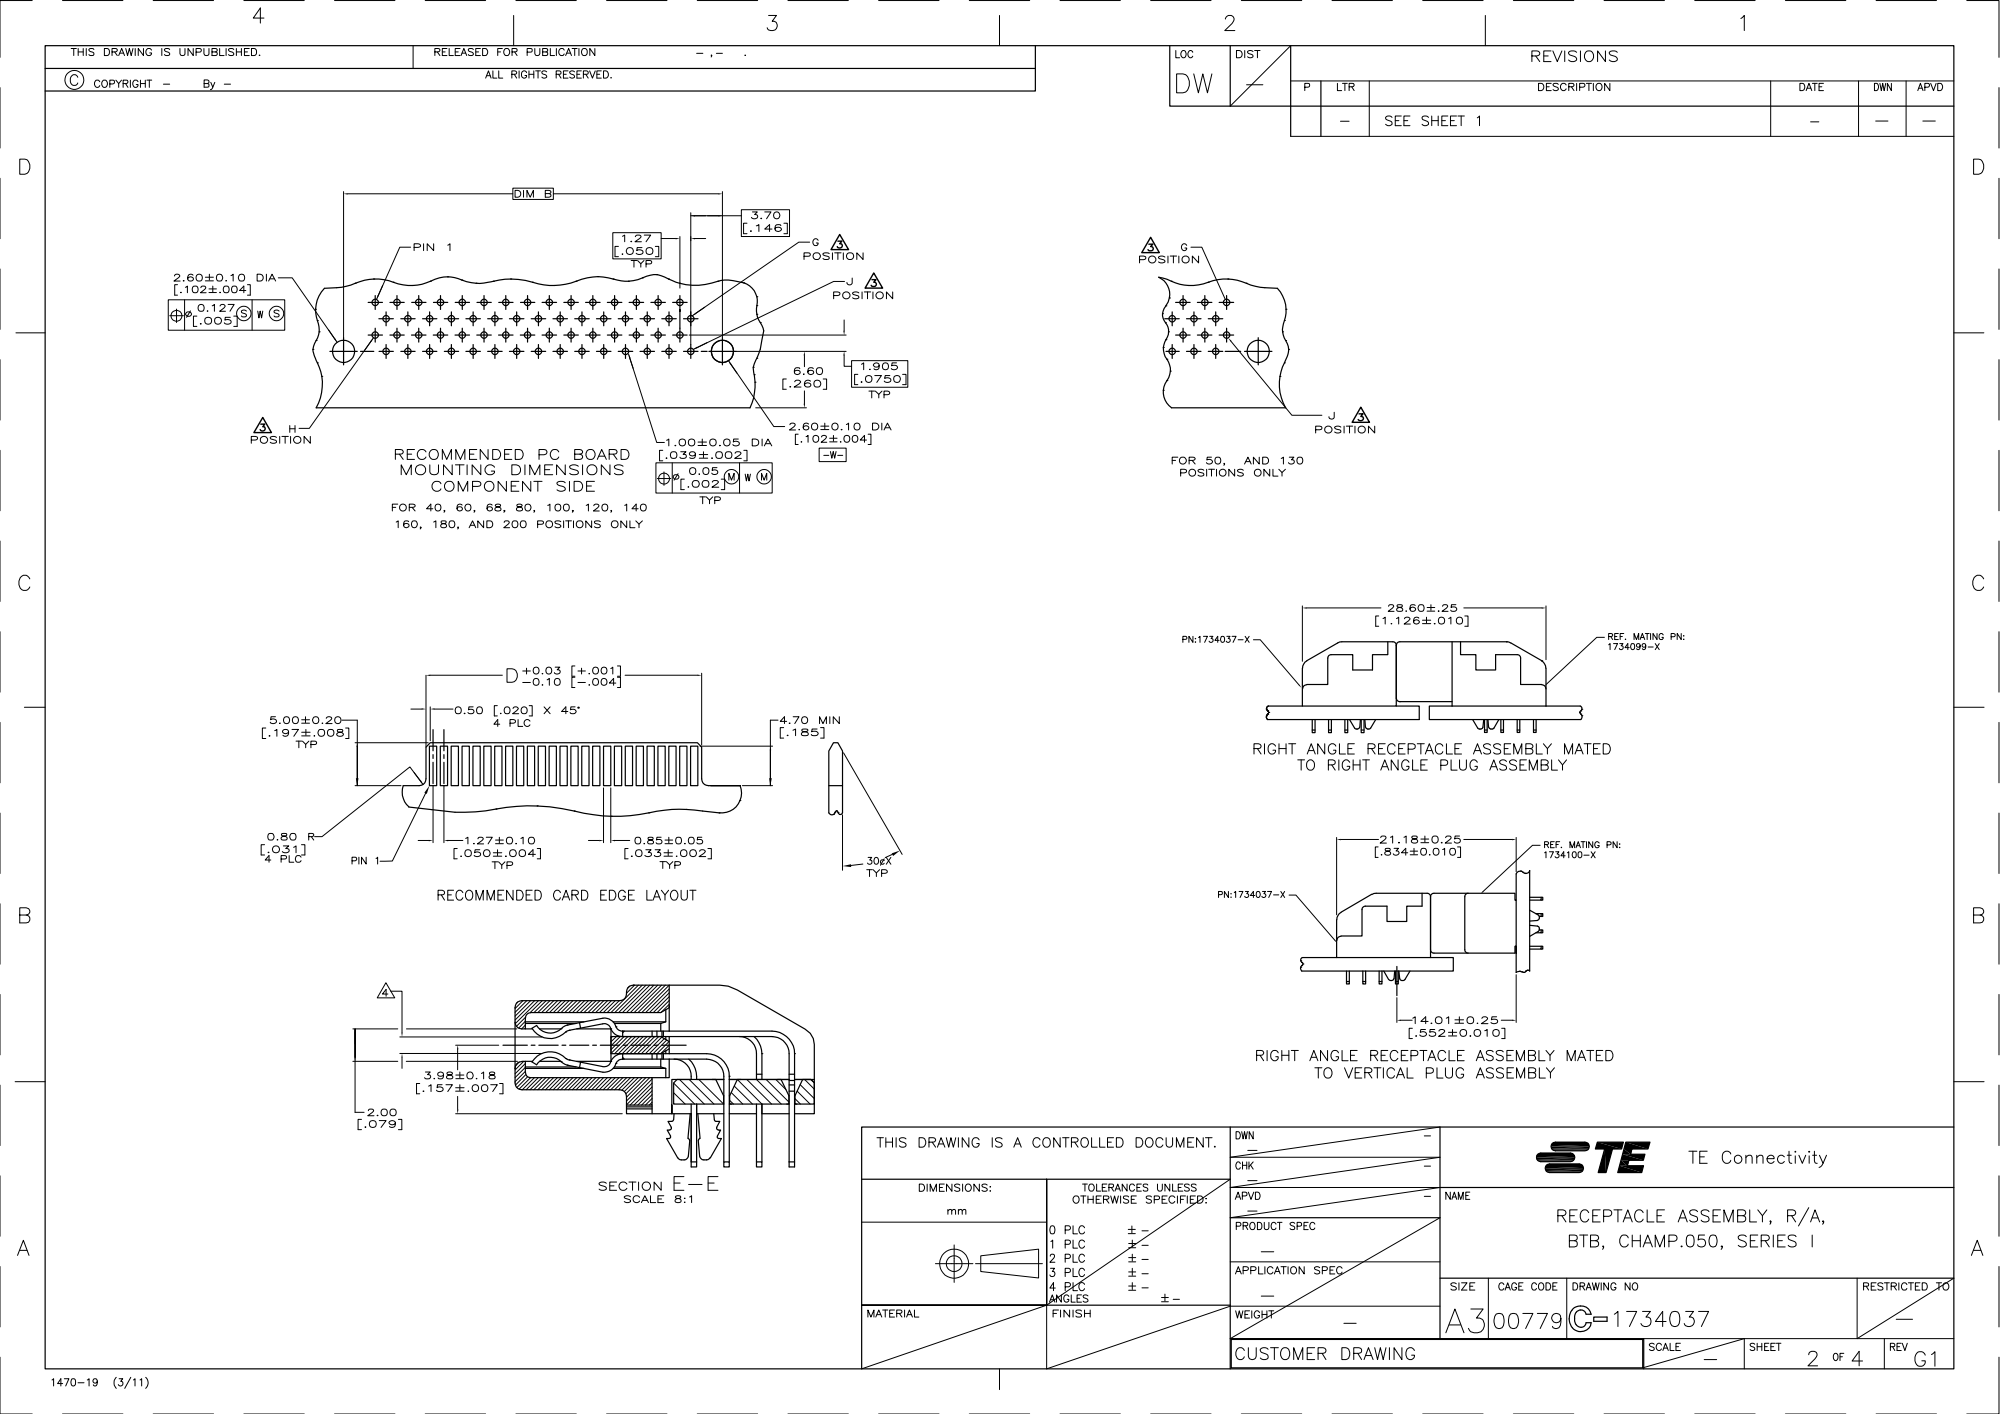
[picture p38: page 2]

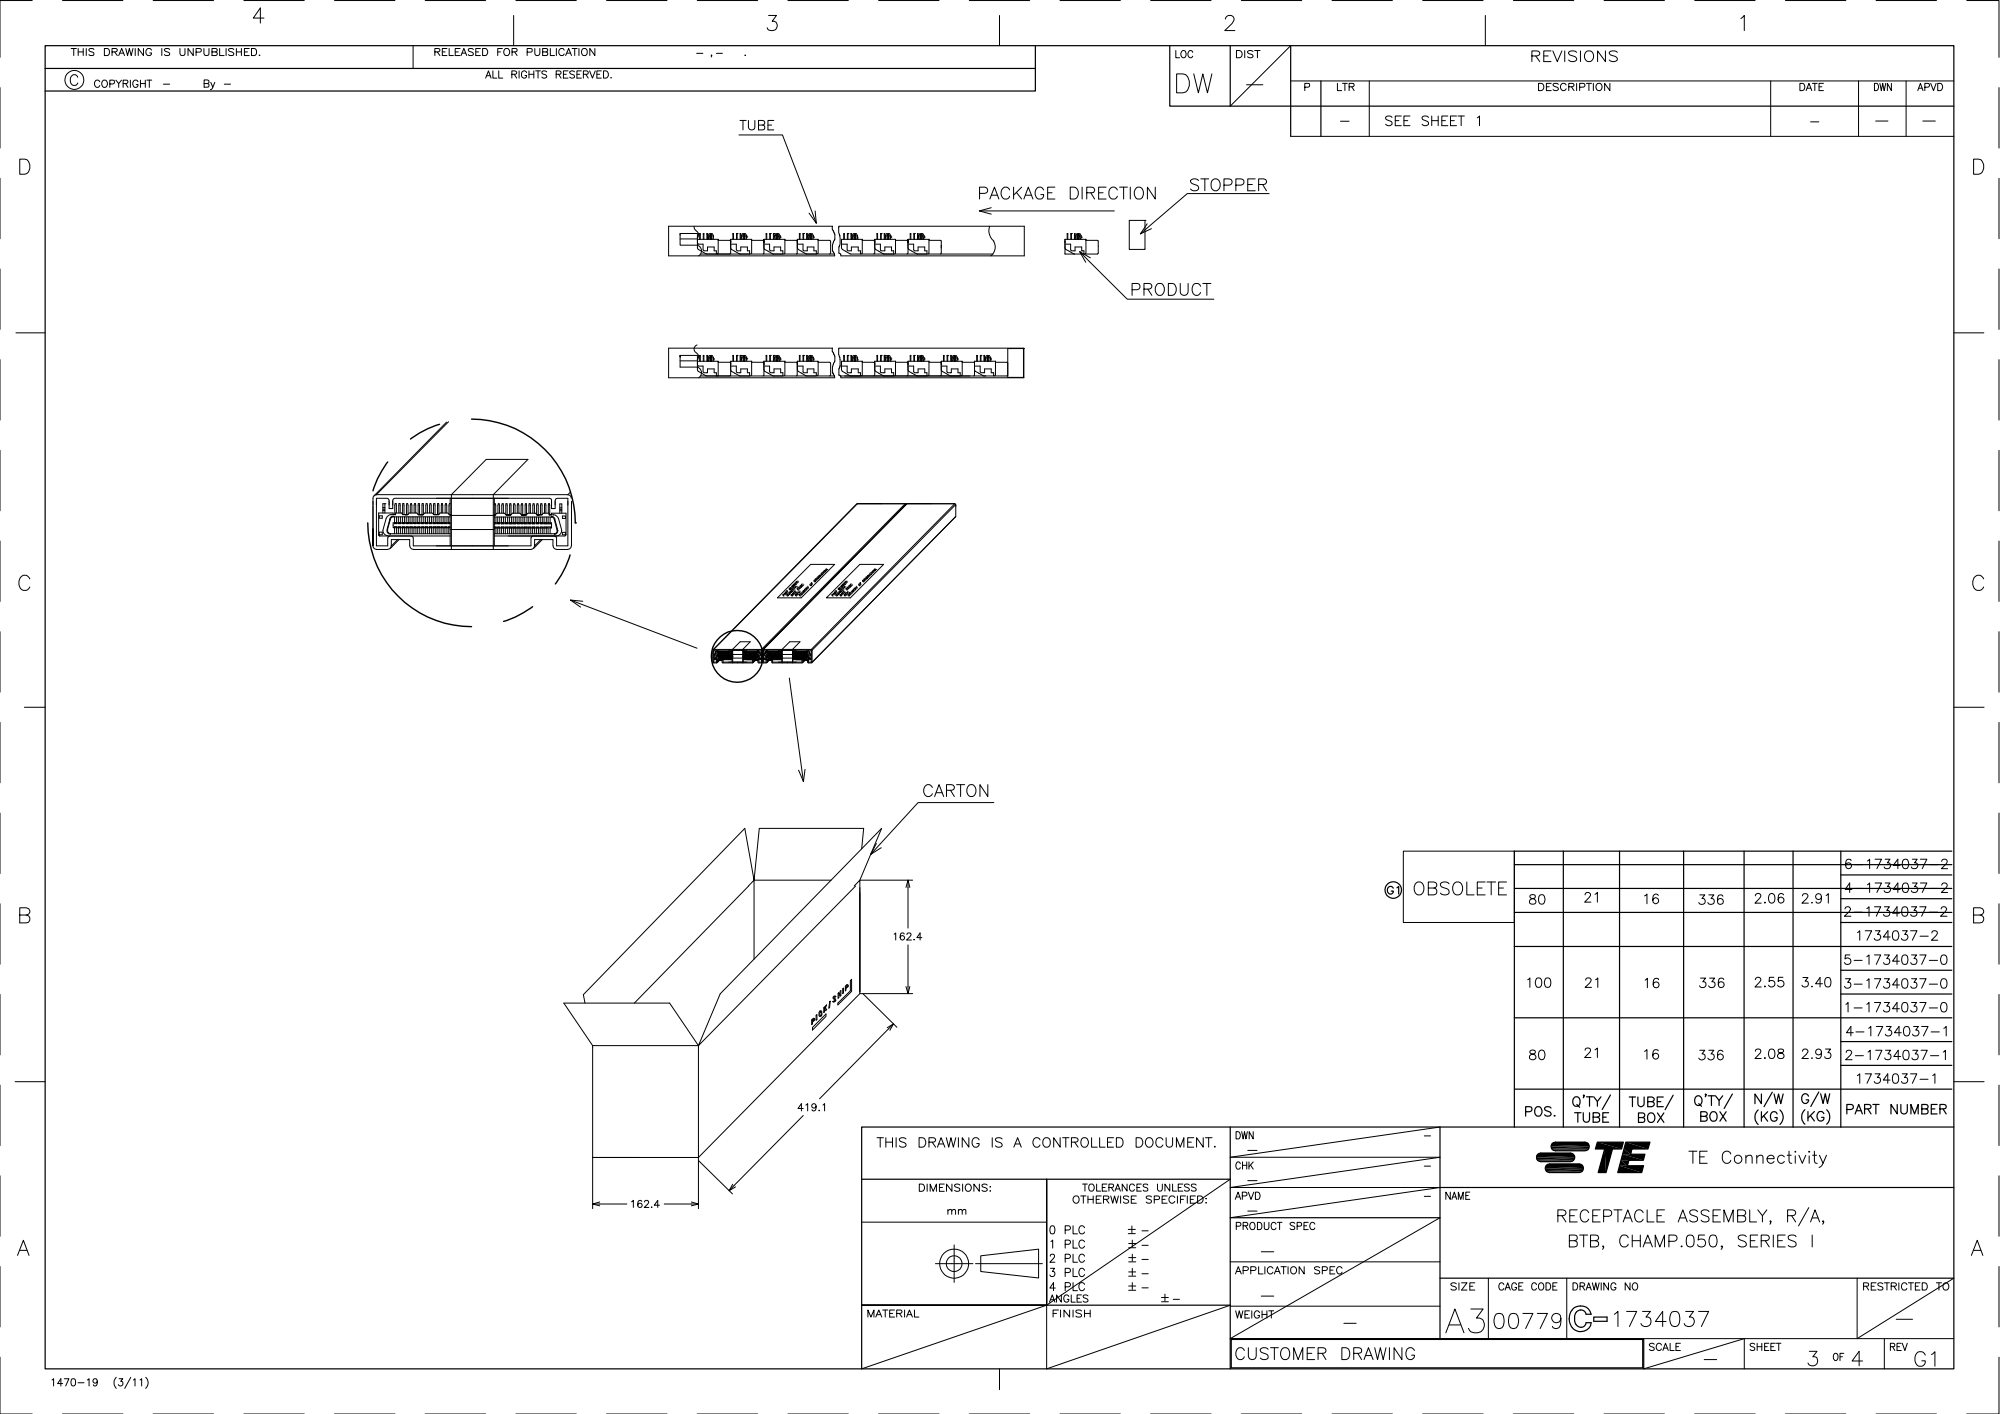
[picture p39: page 3]

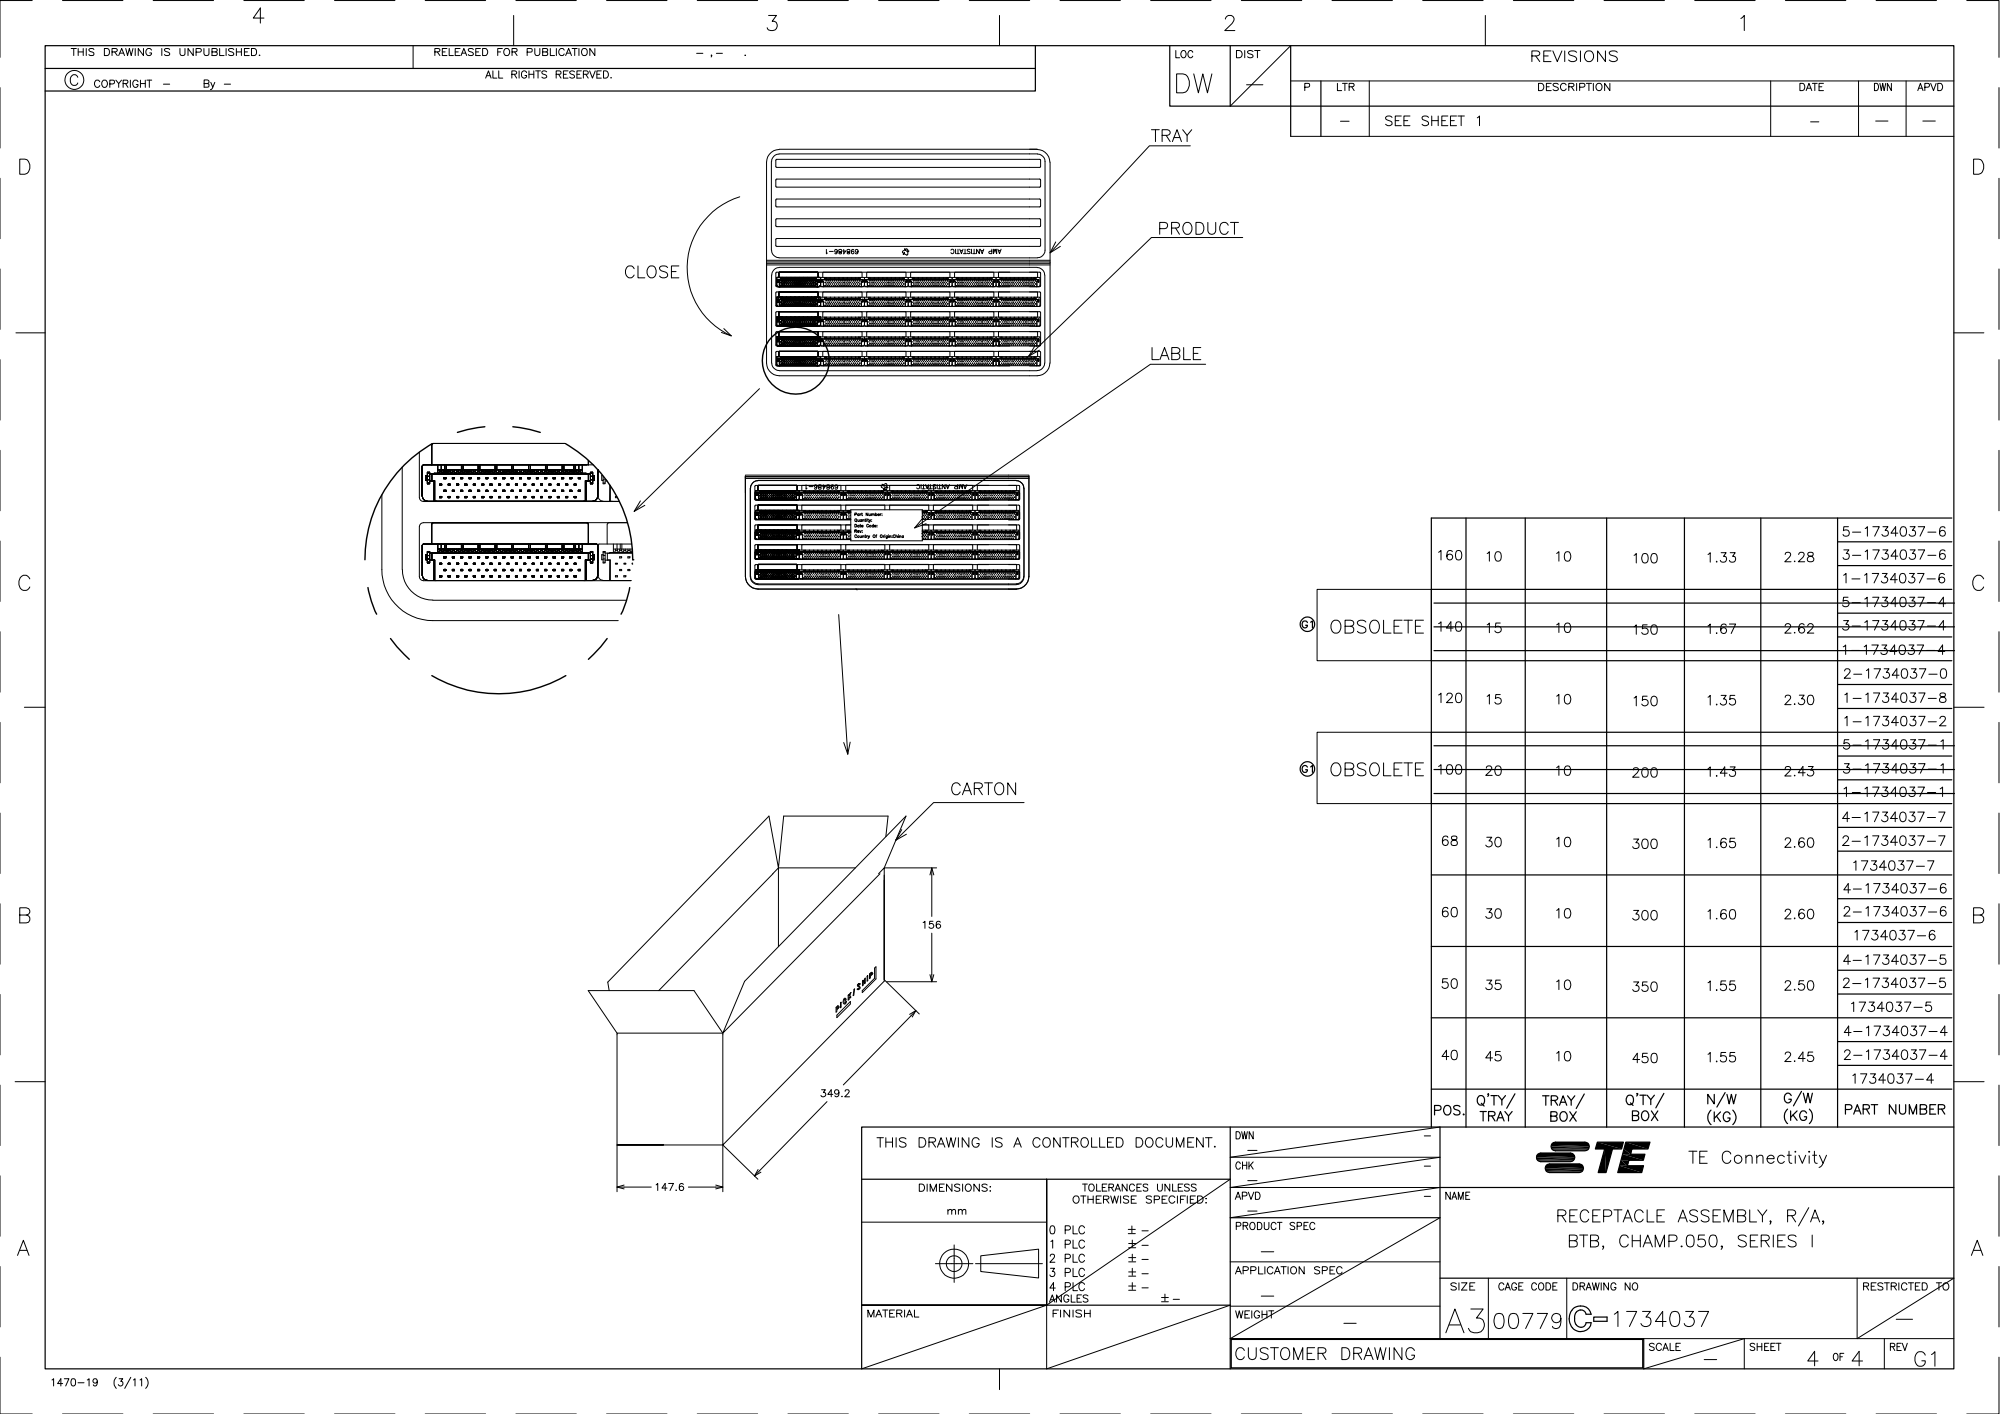
[picture p40: page 4]
