SatelliteApplicationsCatapult/PocketQube/hardware/Electronic/PCB Designs/EPS/KiCAD/EPS/EPS.kicad_pcb

## KiCad design hardware/Electronic/PCB Designs/EPS/KiCAD/EPS/EPS.kicad_pcb (2022-01-14)

Schematic: EPS_SS_1.sch, EPS.sch

Parts:
C1, C2, C4, C5, C6, C8: 10uF; RESISTOR_C0603
C3, C7: 1uF; RESISTOR_C0402
IND1, IND2: WE-TPC-744031100; UBO_PQ60_WE-TPC-744031100
MPPT1, MPPT2: LTC3105; UBO_PQ60_DFN-3X3
R1, R4: 1.3M; RESISTOR_R0402
R2, R5: 330K; RESISTOR_R0402
R3, R6: 501K; RESISTOR_R0402
R33: 150R; RESISTOR_R0402
SOL1, SOL2, SOL3, SOL4: JST-B2B-ZH; UBO_PQ60_JST-B2B-ZR
U1: LTC4413EDDPBF; UBO_PQ60_DFN300X300X80-11N
U$4, U$10, U$14, U$17, U$31, U$32: BAT41; UBO_PQ60_SOD-123
U$24: EL3H7; UBO_PQ60_EL3H7

Connections:
GND: C1.2, C2.2, C3.2, C4.2, C5.2, C6.2, C7.2, C8.2, MPPT1.3 (FBLDO), MPPT1.EXP (GND), MPPT2.3 (FBLDO), MPPT2.EXP (GND), R2.1, R3.2, R5.1, R6.2, SOL1.P$1 (-), SOL2.P$1 (-), SOL3.P$1 (-), SOL4.P$1 (-), U1.2 (ENBA), U1.3 (GND), U1.4 (ENBB), U1.9 (STAT), U1.11 (EP), U$24.CATH (CATHODE), U$24.EMIT (EMITTER); also elsewhere on the board
MPPT1: C2.1, MPPT1.9 (VOUT), R1.2, U1.1 (INA)
MPPT2: C6.1, MPPT2.9 (VOUT), R4.2, U1.5 (INB)
MPPT_RAW: U1.6 (OUTB), U1.10 (OUTA); also elsewhere on the board
unnamed: IND1.P$1 (1), MPPT1.7 (SW)
unnamed: C1.1, IND1.P$3 (2), MPPT1.6 (VIN), U$31.P$1 (C), U$32.P$1 (C)
unnamed: IND2.P$1 (1), MPPT2.7 (SW)
unnamed: C3.1, MPPT1.10 (AUX)
unnamed: C7.1, MPPT2.10 (AUX)
unnamed: C5.1, IND2.P$3 (2), MPPT2.6 (VIN), U$14.P$1 (C), U$17.P$1 (C)
unnamed: MPPT2.1 (FB), R4.1, R5.2
unnamed: C4.1, MPPT1.2 (LDO)
unnamed: MPPT1.1 (FB), R1.1, R2.2
unnamed: MPPT2.5 (MPPC), R6.1
unnamed: C8.1, MPPT2.2 (LDO)
unnamed: MPPT2.4 (SHDN), U$10.P$2 (A)
unnamed: SOL4.P$2 (+), U$17.P$2 (A)
unnamed: MPPT1.4 (SHDN), U$4.P$2 (A)
unnamed: MPPT1.5 (MPPC), R3.1
unnamed: SOL3.P$2 (+), U$14.P$2 (A)
unnamed: SOL2.P$2 (+), U$31.P$2 (A)
unnamed: SOL1.P$2 (+), U$32.P$2 (A)
unnamed: R33.2, U$24.ANOD (ANODE)
OPTO: R33.1; also elsewhere on the board
SHDN: U$4.P$1 (C), U$10.P$1 (C), U$24.COLL (COLLECTOR)

Notes on the sheet:
10uH
501K --> 5.01V MPPV
1.004Vx((1.3M/330K)+1) =~4.959Vout
Maxmimu Power Point Tracking circuits, Opto-isolated charge disable and dual ideal diode outputs

Schematic: EPS_SS_2.sch, EPS.sch

Parts:
BAT56: JST-B2B-ZH; UBO_PQ60_JST-B2B-ZR
BU4331G-TR56: BU4231G-TR; EPS_PQ60_SSOP5
C21: 10nF; RESISTOR_C0402
C22: 1uF; RESISTOR_C0402
C23: 1nF; RESISTOR_C0402
INA210AIDCKT56: INA211A; UBO_PQ60_SC-70
PWR56: 961102-5604-AR; UBO_PQ60_961102-5604-AR
R7, R8, R9, R10, R15, R20, R21, R24, R28: 10K; RESISTOR_R0402
R13, R22, R36, R37: 0.15R, 1%; RESISTOR_R0603
R16: 2.2K; RESISTOR_R0402
R17: 3.3K; RESISTOR_R0402
R19: 0.015R 1%; RESISTOR_R0603
R40: 47K; RESISTOR_R0402
SJ1: UBO_PQ60_SJ
STWD100PYW83F56: STWD100PYW83F; UBO_PQ60_SOT_323-5
U9: TPS2553DRVT; UBO_PQ60_SON65P200X200X80-7N
U$2: BQ24079; UBO_PQ60_PVQFN16-THERM
U$15: PMV40UN2; UBO_PQ60_SOT23-3
U$18, U$19, U$25, U$26: FAN4010IL6X_F113; UBO_PQ60_FAN4010IL6X_F113
U$20: NCP706AMX300TAG; UBO_PQ60_XDFN8

Connections:
+3V3: INA210AIDCKT56.3 (VCC), R20.2, R36.2, U$25.6 (LOAD); also elsewhere on the board
+3V3_ISEN: R10.2, U$25.3 (IOUT); also elsewhere on the board
+3V3_REG: R36.1, R37.1, U$20.P$1 (OUT), U$20.P$2 (OUT), U$20.P$4 (SNS), U$25.1 (VIN), U$26.1 (VIN)
+3V3_SW: R37.2, U$26.6 (LOAD); also elsewhere on the board
+3V3_SW_ISEN: R9.2, U$26.3 (IOUT); also elsewhere on the board
BATV_BUS: R22.1, U$19.6 (LOAD); also elsewhere on the board
BAT_BUS_ISEN: R7.1, U$19.3 (IOUT); also elsewhere on the board
BAT_RAW_ISEN: INA210AIDCKT56.6 (OUT); also elsewhere on the board
BAT_RAW_ISEN_EN: U$15.1 (G); also elsewhere on the board
CHG_INPUT: R13.2, U$2.6 (EN1), U$2.13 (IN), U$18.6 (LOAD); also elsewhere on the board
EN: BU4331G-TR56.1 (VOUT), C23.1, R28.1, STWD100PYW83F56.1 (WDO), U9.4 (EN), U$20.P$6 (EN); also elsewhere on the board
GND: BAT56.P$1 (-), BU4331G-TR56.3 (GND), C21.2, C22.2, C23.2, INA210AIDCKT56.2 (GND), R7.2, R8.1, R9.1, R10.1, R15.1, R16.1, R17.1, R24.1, R40.1, STWD100PYW83F56.2 (GND), U9.5 (GND), U9.7 (EP), U$2.4 (CE), U$2.5 (EN2), U$2.7 (PGOOD), U$2.8 (VSS), U$2.9 (CHG), U$2.14 (TMR), U$2.15 (SYSOFF), U$2.17 (VSS), U$15.2 (S), U$18.5 (GND), U$19.5 (GND), U$20.P$5 (GND), U$20.P$9 (GND), U$25.5 (GND), U$26.5 (GND); also elsewhere on the board
MPPT_RAW: R13.1, U$18.1 (VIN); also elsewhere on the board
unnamed: INA210AIDCKT56.4 (IN+), R19.2, U$2.2 (BAT), U$2.3 (BAT)
unnamed: R15.2, U$2.1 (TS)
unnamed: R16.2, U$2.16 (ISET)
unnamed: R17.2, U$2.12 (ILIM)
unnamed: BAT56.P$2 (+), INA210AIDCKT56.5 (IN-), R19.1, R22.2, U$19.1 (VIN)
unnamed: R21.1, U$15.3 (D)
unnamed: INA210AIDCKT56.1 (REF), R20.1, R21.2
unnamed: BU4331G-TR56.5 (CT), C21.1
unnamed: R24.2, SJ1.2, STWD100PYW83F56.3 (EN)
unnamed: R40.2, U9.2 (ILIM)
SOL_ISEN: R8.2, U$18.3 (IOUT); also elsewhere on the board
SYS: PWR56.PIN2, U$2.10 (OUT), U$2.11 (OUT)
SYS_RAW: SJ1.1, U9.1 (OUT), U$20.P$7 (IN), U$20.P$8 (IN)
SYS_SW: BU4331G-TR56.2 (VDD), C22.1, PWR56.PIN1, R28.2, STWD100PYW83F56.5 (VCC), U9.6 (IN)
WDI: STWD100PYW83F56.4 (WDI); also elsewhere on the board

Notes on the sheet:
Panasonic ERJ3RSFR15V
200mA --> 3V
SUSUMU RR0816P-103-B-T5
VISHAY WSL0805R0300FEA
Total battery current monitoring
charge / discharge
INA210 200 gain 1.5V = A 3V = +500mA 0V = -500mA
Current monitoring on raw battery line
Main systems load
3v3 total bus load
~500mA limit
Watchdog timer Solder bridge to disable
Brownout monitor Vout high when valid voltage source detected
MOSFET load switch
3.0V 1.5A LDO
2.2K --> 405mA charge limit
3.3K --> 470mA input limit
Thermistor input

Schematic: EPS_SS_3.sch, EPS.sch

Parts:
C25, C26: 1uF; RESISTOR_C0402
FD1, FD2, FD3, FD4: FIDUCIAL; ADAFRUIT_FIDUCIAL_1MM
PQ60_HEADER56: FX8C-060P-SV2(92); OBC_FX8C-060P-SV(92)
PQ60_RECEPTACLE56: FX8C-060S-SV(92); TEMPLATE_FX8C-060S-SV(92)
R18, R25, R26, R27, R30: 10K; RESISTOR_R0402
TP1: TPTP07R; TESTPAD_TP07R
U10, U11, U12: TPS22960DCNR; UBO_PQ60_SOT65P280X145-8N
U$1, U$5, U$6, U$7: 3MMPILAR; UBO_PQ60_3MMPILAR
U$3, U$16, U$23, U$27, U$28: DEBUG-TP; UBO_PQ60_DEBUG-TP
U$8: ABS25_32.768KHZ; UBO_PQ60_ABS25
U$11, U$12: PMV40UN2; UBO_PQ60_SOT23-3
U$21: MKL02Z16VFM4; OBC_MKL02Z16VFM4
U$22: TAG_CONNECT; UBO_PQ60_TAG_CONNECT

Connections:
+3V3: C25.1, C26.1, PQ60_HEADER56.P$57, PQ60_HEADER56.P$58, PQ60_HEADER56.P$59, PQ60_HEADER56.P$60, PQ60_RECEPTACLE56.P$57, PQ60_RECEPTACLE56.P$58, PQ60_RECEPTACLE56.P$59, PQ60_RECEPTACLE56.P$60, U$3.P$1, U$21.3 (VDD), U$21.4 (VREFH), U$22.1 (VCC); also elsewhere on the board
+3V3_ISEN: U$21.16 (PTB0); also elsewhere on the board
+3V3_SW: U10.1 (VIN1), U10.4 (VIN2), U11.4 (VIN2); also elsewhere on the board
+3V3_SW1: PQ60_HEADER56.P$1, PQ60_HEADER56.P$2, PQ60_RECEPTACLE56.P$1, PQ60_RECEPTACLE56.P$2, U10.5 (VOUT2)
+3V3_SW1_EN: U10.3 (ON2), U$21.18 (PTB2)
+3V3_SW2: PQ60_HEADER56.P$5, PQ60_HEADER56.P$6, PQ60_RECEPTACLE56.P$5, PQ60_RECEPTACLE56.P$6, U10.8 (VOUT1)
+3V3_SW2_EN: U10.2 (ON1), U$21.19 (PTA8)
+3V3_SW3: PQ60_HEADER56.P$9, PQ60_HEADER56.P$10, PQ60_RECEPTACLE56.P$9, PQ60_RECEPTACLE56.P$10, U11.5 (VOUT2)
+3V3_SW3_EN: U11.3 (ON2), U$21.20 (PTA9)
+3V3_SW_ISEN: U$21.15 (PTA7); also elsewhere on the board
+5V_USB: PQ60_HEADER56.P$21, PQ60_HEADER56.P$22, PQ60_RECEPTACLE56.P$21, PQ60_RECEPTACLE56.P$22, R30.2, U12.1 (VIN1)
BATV_BUS: PQ60_HEADER56.P$49, PQ60_HEADER56.P$50, PQ60_HEADER56.P$51, PQ60_HEADER56.P$52, PQ60_RECEPTACLE56.P$49, PQ60_RECEPTACLE56.P$50, PQ60_RECEPTACLE56.P$51, PQ60_RECEPTACLE56.P$52, R18.2, U11.1 (VIN1), U12.4 (VIN2); also elsewhere on the board
BATV_SENS: R18.1, R25.2, U$21.25 (PTB5)
BATV_SENS_EN: U$11.1 (G), U$21.27 (PTA13)
BATV_SW1: PQ60_HEADER56.P$13, PQ60_HEADER56.P$14, PQ60_RECEPTACLE56.P$13, PQ60_RECEPTACLE56.P$14, U11.8 (VOUT1)
BATV_SW1_EN: U11.2 (ON1), U$21.21 (PTA10)
BATV_SW2: PQ60_HEADER56.P$17, PQ60_HEADER56.P$18, PQ60_RECEPTACLE56.P$17, PQ60_RECEPTACLE56.P$18, U12.5 (VOUT2)
BATV_SW2_EN: U12.3 (ON2), U$21.22 (PTA11)
BAT_BUS_ISEN: U$21.11 (PTB8); also elsewhere on the board
BAT_RAW_ISEN: U$21.12 (PTB9); also elsewhere on the board
BAT_RAW_ISEN_EN: U$21.14 (PTB11); also elsewhere on the board
CHG_INPUT: U12.8 (VOUT1); also elsewhere on the board
EN: PQ60_HEADER56.P$27, PQ60_RECEPTACLE56.P$27; also elsewhere on the board
EXTAL: U$8.1, U$21.7 (PTA3)
GND: C25.2, C26.2, PQ60_HEADER56.P$3, PQ60_HEADER56.P$4, PQ60_HEADER56.P$7, PQ60_HEADER56.P$8, PQ60_HEADER56.P$11, PQ60_HEADER56.P$12, PQ60_HEADER56.P$15, PQ60_HEADER56.P$16, PQ60_HEADER56.P$19, PQ60_HEADER56.P$20, PQ60_HEADER56.P$23, PQ60_HEADER56.P$24, PQ60_HEADER56.P$28, PQ60_HEADER56.P$45, PQ60_HEADER56.P$46, PQ60_HEADER56.P$47, PQ60_HEADER56.P$48, PQ60_HEADER56.P$53, PQ60_HEADER56.P$54, PQ60_HEADER56.P$55, PQ60_HEADER56.P$56, PQ60_RECEPTACLE56.P$3, PQ60_RECEPTACLE56.P$4, PQ60_RECEPTACLE56.P$7, PQ60_RECEPTACLE56.P$8, PQ60_RECEPTACLE56.P$11, PQ60_RECEPTACLE56.P$12, PQ60_RECEPTACLE56.P$15, PQ60_RECEPTACLE56.P$16, PQ60_RECEPTACLE56.P$19, PQ60_RECEPTACLE56.P$20, PQ60_RECEPTACLE56.P$23, PQ60_RECEPTACLE56.P$24, PQ60_RECEPTACLE56.P$28, PQ60_RECEPTACLE56.P$45, PQ60_RECEPTACLE56.P$46, PQ60_RECEPTACLE56.P$47, PQ60_RECEPTACLE56.P$48, PQ60_RECEPTACLE56.P$53, PQ60_RECEPTACLE56.P$54, PQ60_RECEPTACLE56.P$55, PQ60_RECEPTACLE56.P$56, U10.6 (GND), U11.6 (GND), U12.6 (GND), U$1.P$1, U$5.P$1, U$6.P$1, U$7.P$1, U$11.2 (S), U$12.2 (S), U$21.5 (VREFL), U$21.6 (VSS), U$21.GND@ (VSS), U$22.5 (GND), U$23.P$1; also elsewhere on the board
GPIO0: PQ60_HEADER56.P$25, PQ60_RECEPTACLE56.P$25, U$21.17 (PTB1)
GPIO1: PQ60_HEADER56.P$26, PQ60_RECEPTACLE56.P$26
GPIO2: PQ60_HEADER56.P$34, PQ60_RECEPTACLE56.P$34
GPIO3: PQ60_HEADER56.P$35, PQ60_RECEPTACLE56.P$35
GPIO4: PQ60_HEADER56.P$36, PQ60_RECEPTACLE56.P$36
GPIO5: PQ60_HEADER56.P$37, PQ60_RECEPTACLE56.P$37
GPIO6: PQ60_HEADER56.P$38, PQ60_RECEPTACLE56.P$38
GPIO7: PQ60_HEADER56.P$39, PQ60_RECEPTACLE56.P$39
GPIO8: PQ60_HEADER56.P$40, PQ60_RECEPTACLE56.P$40
GPIO9: PQ60_HEADER56.P$41, PQ60_RECEPTACLE56.P$41
GPIO10: PQ60_HEADER56.P$42, PQ60_RECEPTACLE56.P$42
GPIO11: PQ60_HEADER56.P$43, PQ60_RECEPTACLE56.P$43
GPIO12: PQ60_HEADER56.P$44, PQ60_RECEPTACLE56.P$44
MISO: PQ60_HEADER56.P$32, PQ60_RECEPTACLE56.P$32
MOSI: PQ60_HEADER56.P$31, PQ60_RECEPTACLE56.P$31
MPPTV_SENS: R26.1, R27.2, U$21.26 (PTA12)
MPPTV_SENS_EN: U$12.1 (G), U$21.28 (PTB12)
MPPT_RAW: R26.2; also elsewhere on the board
unnamed: TP1.TP, U$21.2 (PTB7)
unnamed: R25.1, U$11.3 (D)
unnamed: R27.1, U$12.3 (D)
OPTO: U$21.1 (PTB6); also elsewhere on the board
SCK: PQ60_HEADER56.P$33, PQ60_RECEPTACLE56.P$33
SCL: PQ60_HEADER56.P$29, PQ60_RECEPTACLE56.P$29, U$21.23 (PTB3)
SDA: PQ60_HEADER56.P$30, PQ60_RECEPTACLE56.P$30, U$21.24 (PTB4)
SOL_ISEN: U$21.13 (PTB10); also elsewhere on the board
SWDCLK: U$21.30 (PTA0), U$22.4 (CLK), U$27.P$1
SWDIO: U$21.32 (PTA2), U$22.2 (DIO), U$28.P$1
SWDRST: U$16.P$1, U$21.31 (PTA1), U$22.3 (RST)
USB_DISCONNECT: R30.1, U12.2 (ON1), U$21.9 (PTA5)
WDI: U$21.10 (PTA6); also elsewhere on the board
XTAL: U$8.4, U$21.8 (PTA4)

Notes on the sheet:
Fiducial markers

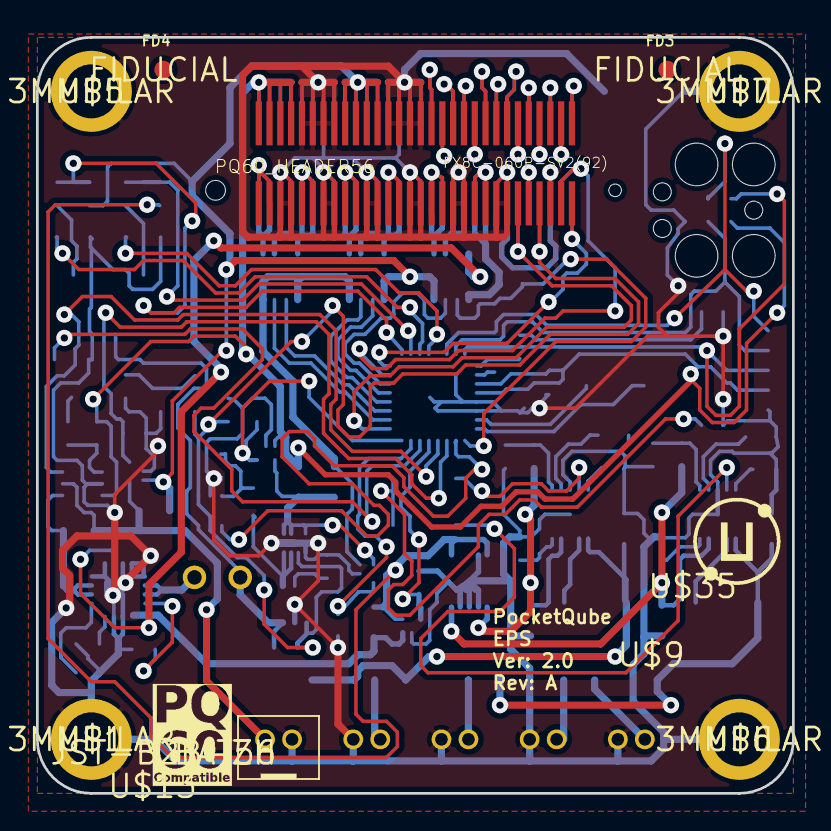
[picture p41: board EPS.kicad_pcb from above]

Board: 2 copper layers, 42.0 x 42.0 mm, 99 parts (0 on the bottom side), 92 nets.

Other parts of the board:
U$9: SA_LOGO_SMALL
U$13: PQ60_CMP
U$35: UBO_LOGO
