SatelliteApplicationsCatapult/PocketQube/hardware/Electronic/PCB Designs/Breakout/FlatSat/FlatSat.kicad_pcb

## KiCad design hardware/Electronic/PCB Designs/Breakout/FlatSat/FlatSat.kicad_pcb (2022-01-14)

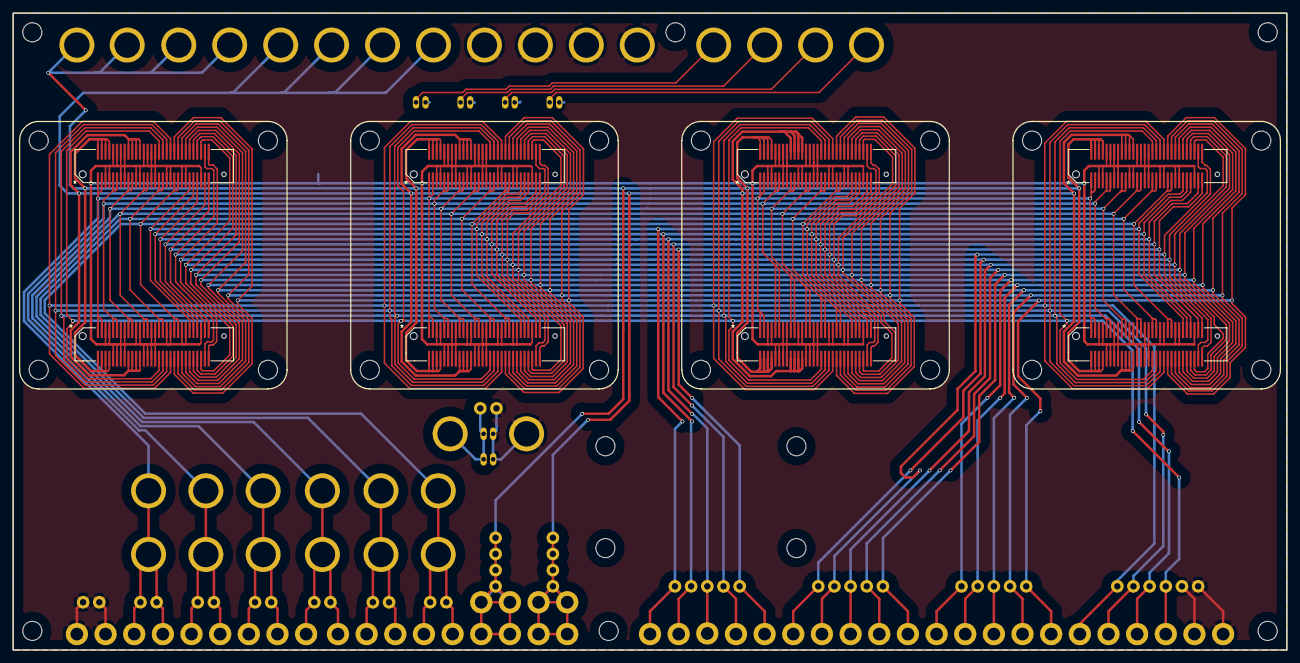
[picture p42: board FlatSat.kicad_pcb from above]

Board: 2 copper layers, 200.0 x 100.0 mm, 158 parts (0 on the bottom side), 33 nets.

Parts:
H1, H2, H3, H4, H9, H10, H27, H28, H29, H30, H31, H32, H37, H38, H51, H52, H53, H54, H55, H56, H61, H62, H68, H70, H72, H74, H75, H76, H82, H84, H86, H88, H89, H92, H93, H96, H97, H100, H104, H105, H108, H109, H112: test_probe_hook_2mm; test_probe_2mm
H5, H6, H7, H8, H11, H12, H23, H24, H25, H26, H33, H34, H39, H40, H47, H48, H49, H50, H57, H58, H63, H64, H67, H69, H71, H73, H77, H78, H81, H83, H85, H87, H90, H91, H94, H95, H98, H99, H103, H106, H107, H110, H111, H119, H121: pin_hdr_std_2.54mm
H13, H14, H15, H16, H17, H18, H19, H20, H21, H22, H35, H36, H41, H42, H43, H44, H45, H46, H59, H60, H65, H66, H79, H80, H101, H113, H115, H117, H123, H124: banana_direct_4mm
H102, H114, H116, H118, H120, H122: JST_ZH; JST_ZH_B2B
J1, J2, J3, J4: FX8C-060P
J5, J6, J7, J8: FX8C-060S
SMD: pcb_standoff_mount
SMD#2, SMD#3, SMD#4, SMD#5, SMD#6, SMD#7, SMD#8, SMD#9, SMD#10, SMD#11, SMD#12, SMD#13, SMD#14, SMD#15, SMD#16, SMD#17, SMD#18, SMD#19, SMD#20, SMD#21, SMD#22, SMD#23, SMD#24, SMD#25, SMD#26: pcb_standoff_mount

Connections:
/P1: H9.1, H10.1, H11.1, H12.1, H13.1, H14.1, J1.1, J1.2, J2.1, J2.2, J3.1, J3.2, J4.1, J4.2, J5.1, J5.2, J6.1, J6.2, J7.1, J7.2, J8.1, J8.2
/P5: H31.1, H32.1, H33.1, H34.1, H35.1, H36.1, J1.5, J1.6, J2.5, J2.6, J3.5, J3.6, J4.5, J4.6, J5.5, J5.6, J6.5, J6.6, J7.5, J7.6, J8.5, J8.6
/P10: H37.1, H38.1, H39.1, H40.1, H41.1, H42.1, J1.9, J1.10, J2.9, J2.10, J3.9, J3.10, J4.9, J4.10, J5.9, J5.10, J6.9, J6.10, J7.9, J7.10, J8.9, J8.10
/P13: H55.1, H56.1, H57.1, H58.1, H59.1, H60.1, J1.13, J1.14, J2.13, J2.14, J3.13, J3.14, J4.13, J4.14, J5.13, J5.14, J6.13, J6.14, J7.13, J7.14, J8.13, J8.14
/P17: H61.1, H62.1, H63.1, H64.1, H65.1, H66.1, J1.17, J1.18, J2.17, J2.18, J3.17, J3.18, J4.17, J4.18, J5.17, J5.18, J6.17, J6.18, J7.17, J7.18, J8.17, J8.18
/P21: H75.1, H76.1, H77.1, H78.1, H79.1, H80.1, J1.21, J1.22, J2.21, J2.22, J3.21, J3.22, J4.21, J4.22, J5.21, J5.22, J6.21, J6.22, J7.21, J7.22, J8.21, J8.22
/P25: H89.1, H90.1, J1.25, J2.25, J3.25, J4.25, J5.25, J6.25, J7.25, J8.25
/P26: H93.1, H94.1, J1.26, J2.26, J3.26, J4.26, J5.26, J6.26, J7.26, J8.26
/P27: H97.1, H98.1, J1.27, J2.27, J3.27, J4.27, J5.27, J6.27, J7.27, J8.27
/P29: H105.1, H106.1, J1.29, J2.29, J3.29, J4.29, J5.29, J6.29, J7.29, J8.29
/P30: H109.1, H110.1, J1.30, J2.30, J3.30, J4.30, J5.30, J6.30, J7.30, J8.30
/P31: H111.1, H112.1, J1.31, J2.31, J3.31, J4.31, J5.31, J6.31, J7.31, J8.31
/P32: H107.1, H108.1, J1.32, J2.32, J3.32, J4.32, J5.32, J6.32, J7.32, J8.32
/P33: H103.1, H104.1, J1.33, J2.33, J3.33, J4.33, J5.33, J6.33, J7.33, J8.33
/P34: H99.1, H100.1, J1.34, J2.34, J3.34, J4.34, J5.34, J6.34, J7.34, J8.34
/P35: H95.1, H96.1, J1.35, J2.35, J3.35, J4.35, J5.35, J6.35, J7.35, J8.35
/P36: H91.1, H92.1, J1.36, J2.36, J3.36, J4.36, J5.36, J6.36, J7.36, J8.36
/P37: H87.1, H88.1, J1.37, J2.37, J3.37, J4.37, J5.37, J6.37, J7.37, J8.37
/P38: H85.1, H86.1, J1.38, J2.38, J3.38, J4.38, J5.38, J6.38, J7.38, J8.38
/P39: H83.1, H84.1, J1.39, J2.39, J3.39, J4.39, J5.39, J6.39, J7.39, J8.39
/P40: H81.1, H82.1, J1.40, J2.40, J3.40, J4.40, J5.40, J6.40, J7.40, J8.40
/P41: H73.1, H74.1, J1.41, J2.41, J3.41, J4.41, J5.41, J6.41, J7.41, J8.41
/P42: H71.1, H72.1, J1.42, J2.42, J3.42, J4.42, J5.42, J6.42, J7.42, J8.42
/P43: H69.1, H70.1, J1.43, J2.43, J3.43, J4.43, J5.43, J6.43, J7.43, J8.43
/P44: H67.1, H68.1, J1.44, J2.44, J3.44, J4.44, J5.44, J6.44, J7.44, J8.44
/P49: H43.1, H44.1, H45.1, H46.1, H47.1, H48.1, H49.1, H50.1, H51.1, H52.1, H53.1, H54.1, J1.49, J1.50, J1.51, J1.52, J2.49, J2.50, J2.51, J2.52, J3.49, J3.50, J3.51, J3.52, J4.49, J4.50, J4.51, J4.52, J5.49, J5.50, J5.51, J5.52, J6.49, J6.50, J6.51, J6.52, J7.49, J7.50, J7.51, J7.52, J8.49, J8.50, J8.51, J8.52
/P57: H19.1, H20.1, H21.1, H22.1, H23.1, H24.1, H25.1, H26.1, H27.1, H28.1, H29.1, H30.1, J1.57, J1.58, J1.59, J1.60, J2.57, J2.58, J2.59, J2.60, J3.57, J3.58, J3.59, J3.60, J4.57, J4.58, J4.59, J4.60, J5.57, J5.58, J5.59, J5.60, J6.57, J6.58, J6.59, J6.60, J7.57, J7.58, J7.59, J7.60, J8.57, J8.58, J8.59, J8.60
GND: H1.1, H2.1, H3.1, H4.1, H5.1, H6.1, H7.1, H8.1, H15.1, H16.1, H17.1, H18.1, H102.2, H114.2, H116.2, H118.2, H120.2, H121.1, H122.2, H124.1, J1.3, J1.4, J1.7, J1.8, J1.11, J1.12, J1.15, J1.16, J1.19, J1.20, J1.23, J1.24, J1.28, J1.45, J1.46, J1.47, J1.48, J1.53, J1.54, J1.55, J1.56, J2.3, J2.4, J2.7, J2.8, J2.11, J2.12, J2.15, J2.16, J2.19, J2.20, J2.23, J2.24, J2.28, J2.45, J2.46, J2.47, J2.48, J2.53, J2.54, J2.55, J2.56, J3.3, J3.4, J3.7, J3.8, J3.11, J3.12, J3.15, J3.16, J3.19, J3.20, J3.23, J3.24, J3.28, J3.45, J3.46, J3.47, J3.48, J3.53, J3.54, J3.55, J3.56, J4.3, J4.4, J4.7, J4.8, J4.11, J4.12, J4.15, J4.16, J4.19, J4.20, J4.23, J4.24, J4.28, J4.45, J4.46, J4.47, J4.48, J4.53, J4.54, J4.55, J4.56, J5.3, J5.4, J5.7, J5.8, J5.11, J5.12, J5.15, J5.16, J5.19, J5.20, J5.23, J5.24, J5.28, J5.45, J5.46, J5.47, J5.48, J5.53, J5.54, J5.55, J5.56, J6.3, J6.4, J6.7, J6.8, J6.11, J6.12, J6.15, J6.16, J6.19, J6.20, J6.23, J6.24, J6.28, J6.45, J6.46, J6.47, J6.48, J6.53, J6.54, J6.55, J6.56, J7.3, J7.4, J7.7, J7.8, J7.11, J7.12, J7.15, J7.16, J7.19, J7.20, J7.23, J7.24, J7.28, J7.45, J7.46, J7.47, J7.48, J7.53, J7.54, J7.55, J7.56, J8.3, J8.4, J8.7, J8.8, J8.11, J8.12, J8.15, J8.16, J8.19, J8.20, J8.23, J8.24, J8.28, J8.45, J8.46, J8.47, J8.48, J8.53, J8.54, J8.55, J8.56
unnamed: H101.1, H102.1
unnamed: H113.1, H114.1
unnamed: H115.1, H116.1
unnamed: H117.1, H118.1
unnamed: H119.1, H120.1, H122.1, H123.1
