SatelliteApplicationsCatapult/PocketQube/hardware/Electronic/PCB Designs/Breakout/MCU_breakout/MCU_breakout.brd

## EAGLE design hardware/Electronic/PCB Designs/Breakout/MCU_breakout/MCU_breakout.brd (2022-01-14)

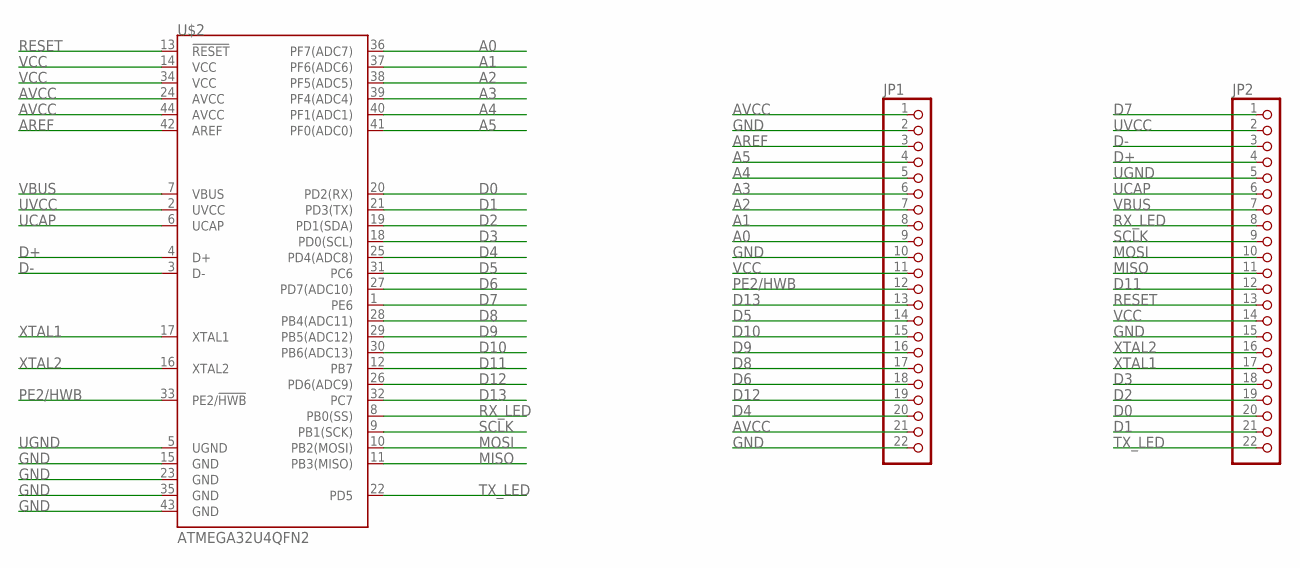
[picture p43: schematic MCU_breakout.sch]

Parts:
JP1, JP2: PINHD-1X22; 1X22
U$2: ATMEGA32U4QFN2; QFN-44-NOPAD

Connections:
A0: JP1.9, U$2.36 (PF7(ADC7))
A1: JP1.8, U$2.37 (PF6(ADC6))
A2: JP1.7, U$2.38 (PF5(ADC5))
A3: JP1.6, U$2.39 (PF4(ADC4))
A4: JP1.5, U$2.40 (PF1(ADC1))
A5: JP1.4, U$2.41 (PF0(ADC0))
AREF: JP1.3, U$2.42 (AREF)
AVCC: JP1.1, JP1.21, U$2.24 (AVCC), U$2.44 (AVCC)
D0: JP2.20, U$2.20 (PD2(RX))
D1: JP2.21, U$2.21 (PD3(TX))
D2: JP2.19, U$2.19 (PD1(SDA))
D3: JP2.18, U$2.18 (PD0(SCL))
D4: JP1.20, U$2.25 (PD4(ADC8))
D5: JP1.14, U$2.31 (PC6)
D6: JP1.18, U$2.27 (PD7(ADC10))
D7: JP2.1, U$2.1 (PE6)
D8: JP1.17, U$2.28 (PB4(ADC11))
D9: JP1.16, U$2.29 (PB5(ADC12))
D10: JP1.15, U$2.30 (PB6(ADC13))
D11: JP2.12, U$2.12 (PB7)
D12: JP1.19, U$2.26 (PD6(ADC9))
D13: JP1.13, U$2.32 (PC7)
D+: JP2.4, U$2.4 (D+)
D-: JP2.3, U$2.3 (D-)
GND: JP1.2, JP1.10, JP1.22, JP2.15, U$2.15 (GND), U$2.23 (GND), U$2.35 (GND), U$2.43 (GND)
MISO: JP2.11, U$2.11 (PB3(MISO))
MOSI: JP2.10, U$2.10 (PB2(MOSI))
PE2/HWB: JP1.12, U$2.33 (PE2/!HWB)
RESET: JP2.13, U$2.13 (!RESET)
RX_LED: JP2.8, U$2.8 (PB0(SS))
SCLK: JP2.9, U$2.9 (PB1(SCK))
TX_LED: JP2.22, U$2.22 (PD5)
UCAP: JP2.6, U$2.6 (UCAP)
UGND: JP2.5, U$2.5 (UGND)
UVCC: JP2.2, U$2.2 (UVCC)
VBUS: JP2.7, U$2.7 (VBUS)
VCC: JP1.11, JP2.14, U$2.14 (VCC), U$2.34 (VCC)
XTAL1: JP2.17, U$2.17 (XTAL1)
XTAL2: JP2.16, U$2.16 (XTAL2)

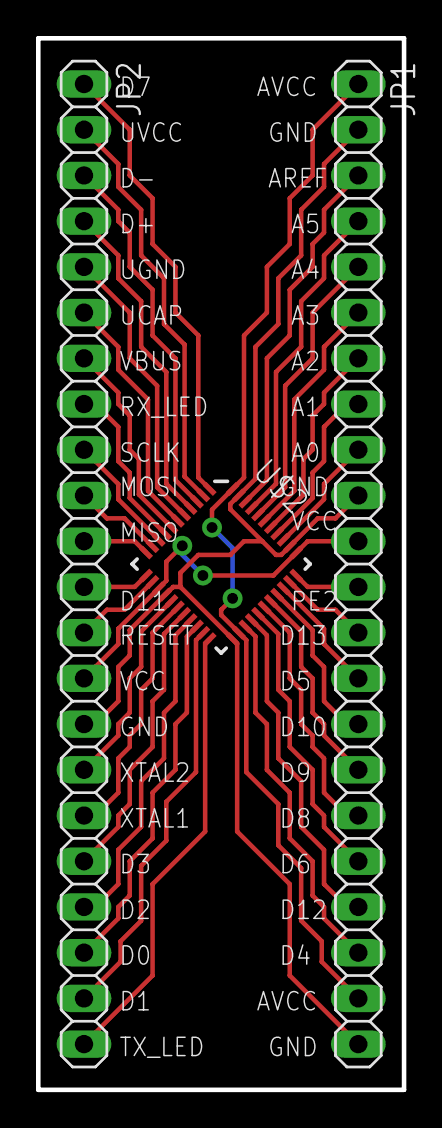
[picture p44: board MCU_breakout.brd from above]

Board: 2 copper layers, 20.3 x 58.4 mm, 3 parts (0 on the bottom side), 39 nets.
