SatelliteApplicationsCatapult/PocketQube/hardware/Electronic/PCB Designs/PSB/PSB.brd

## EAGLE design hardware/Electronic/PCB Designs/PSB/PSB.brd (2022-01-14)

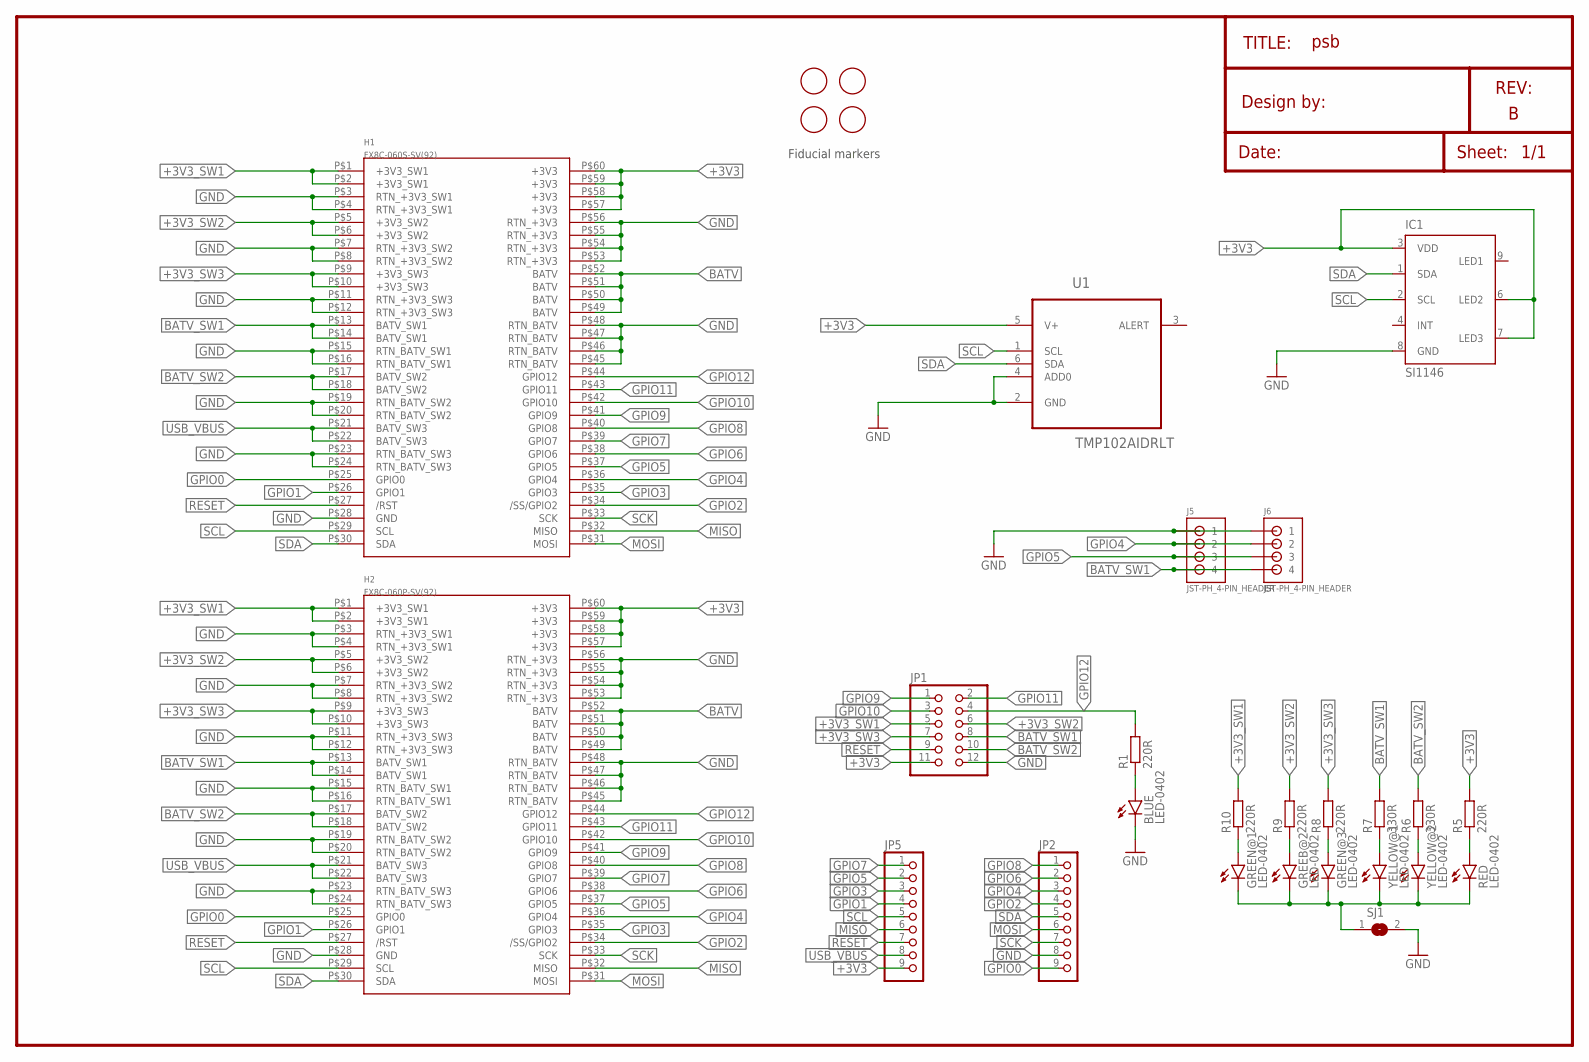
[picture p45: schematic PSB.sch]

Parts:
BLUE: LED-0402; 0402-LED
FD1, FD2, FD3, FD4: FIDUCIAL; FIDUCIAL_1MM
GREEB@2: LED-0402; 0402-LED
GREEN@1, GREEN@3: LED-0402; 0402-LED
H1: FX8C-060S-SV(92)
H2: FX8C-060P-SV(92)
IC1: SI1146; QFN-10
J5, J6: JST-PH_4-PIN_HEADER; JST_B4B-PH_HEADER
JP1: PINHD-2X6; 2X06-CLEANBIG
JP2, JP5: PINHD-1X9; 1X09-BIG
R1, R5, R8, R9, R10: 220R; R0402
R6, R7: 330R; R0402
RED: LED-0402; 0402-LED
SJ1: SJ
U1: TMP102AIDRLT; SOT50P160X60-6N
YELLOW@1, YELLOW@2: LED-0402; 0402-LED

Connections:
+3V3: H1.P$57 (+3V3), H1.P$58 (+3V3), H1.P$59 (+3V3), H1.P$60 (+3V3), H2.P$57 (+3V3), H2.P$58 (+3V3), H2.P$59 (+3V3), H2.P$60 (+3V3), IC1.3 (VDD), IC1.6 (LED2), IC1.7 (LED3), JP1.11, JP5.9, R5.2, U1.5 (V+)
+3V3_SW1: H1.P$1 (+3V3_SW1), H1.P$2 (+3V3_SW1), H2.P$1 (+3V3_SW1), H2.P$2 (+3V3_SW1), JP1.5, R10.2
+3V3_SW2: H1.P$5 (+3V3_SW2), H1.P$6 (+3V3_SW2), H2.P$5 (+3V3_SW2), H2.P$6 (+3V3_SW2), JP1.6, R9.2
+3V3_SW3: H1.P$9 (+3V3_SW3), H1.P$10 (+3V3_SW3), H2.P$9 (+3V3_SW3), H2.P$10 (+3V3_SW3), JP1.7, R8.2
BATV: H1.P$49 (BATV), H1.P$50 (BATV), H1.P$51 (BATV), H1.P$52 (BATV), H2.P$49 (BATV), H2.P$50 (BATV), H2.P$51 (BATV), H2.P$52 (BATV)
BATV_SW1: H1.P$13 (BATV_SW1), H1.P$14 (BATV_SW1), H2.P$13 (BATV_SW1), H2.P$14 (BATV_SW1), J5.P4 (4), J6.P4 (4), JP1.8, R7.2
BATV_SW2: H1.P$17 (BATV_SW2), H1.P$18 (BATV_SW2), H2.P$17 (BATV_SW2), H2.P$18 (BATV_SW2), JP1.10, R6.2
GND: BLUE.C, H1.P$3 (RTN_+3V3_SW1), H1.P$4 (RTN_+3V3_SW1), H1.P$7 (RTN_+3V3_SW2), H1.P$8 (RTN_+3V3_SW2), H1.P$11 (RTN_+3V3_SW3), H1.P$12 (RTN_+3V3_SW3), H1.P$15 (RTN_BATV_SW1), H1.P$16 (RTN_BATV_SW1), H1.P$19 (RTN_BATV_SW2), H1.P$20 (RTN_BATV_SW2), H1.P$23 (RTN_BATV_SW3), H1.P$24 (RTN_BATV_SW3), H1.P$28 (GND), H1.P$45 (RTN_BATV), H1.P$46 (RTN_BATV), H1.P$47 (RTN_BATV), H1.P$48 (RTN_BATV), H1.P$53 (RTN_+3V3), H1.P$54 (RTN_+3V3), H1.P$55 (RTN_+3V3), H1.P$56 (RTN_+3V3), H2.P$3 (RTN_+3V3_SW1), H2.P$4 (RTN_+3V3_SW1), H2.P$7 (RTN_+3V3_SW2), H2.P$8 (RTN_+3V3_SW2), H2.P$11 (RTN_+3V3_SW3), H2.P$12 (RTN_+3V3_SW3), H2.P$15 (RTN_BATV_SW1), H2.P$16 (RTN_BATV_SW1), H2.P$19 (RTN_BATV_SW2), H2.P$20 (RTN_BATV_SW2), H2.P$23 (RTN_BATV_SW3), H2.P$24 (RTN_BATV_SW3), H2.P$28 (GND), H2.P$45 (RTN_BATV), H2.P$46 (RTN_BATV), H2.P$47 (RTN_BATV), H2.P$48 (RTN_BATV), H2.P$53 (RTN_+3V3), H2.P$54 (RTN_+3V3), H2.P$55 (RTN_+3V3), H2.P$56 (RTN_+3V3), IC1.8 (GND), J5.P1 (1), J6.P1 (1), JP1.12, JP2.8, SJ1.2, U1.2 (GND), U1.4 (ADD0)
GPIO0: H1.P$25 (GPIO0), H2.P$25 (GPIO0), JP2.9
GPIO1: H1.P$26 (GPIO1), H2.P$26 (GPIO1), JP5.4
GPIO2: H1.P$34 (/SS/GPIO2), H2.P$34 (/SS/GPIO2), JP2.4
GPIO3: H1.P$35 (GPIO3), H2.P$35 (GPIO3), JP5.3
GPIO4: H1.P$36 (GPIO4), H2.P$36 (GPIO4), J5.P2 (2), J6.P2 (2), JP2.3
GPIO5: H1.P$37 (GPIO5), H2.P$37 (GPIO5), J5.P3 (3), J6.P3 (3), JP5.2
GPIO6: H1.P$38 (GPIO6), H2.P$38 (GPIO6), JP2.2
GPIO7: H1.P$39 (GPIO7), H2.P$39 (GPIO7), JP5.1
GPIO8: H1.P$40 (GPIO8), H2.P$40 (GPIO8), JP2.1
GPIO9: H1.P$41 (GPIO9), H2.P$41 (GPIO9), JP1.1
GPIO10: H1.P$42 (GPIO10), H2.P$42 (GPIO10), JP1.3
GPIO11: H1.P$43 (GPIO11), H2.P$43 (GPIO11), JP1.2
GPIO12: H1.P$44 (GPIO12), H2.P$44 (GPIO12), JP1.4, R1.2
MISO: H1.P$32 (MISO), H2.P$32 (MISO), JP5.6
MOSI: H1.P$31 (MOSI), H2.P$31 (MOSI), JP2.6
unnamed: BLUE.A, R1.1
unnamed: GREEN@1.A, R10.1
unnamed: GREEB@2.A, R9.1
unnamed: GREEN@3.A, R8.1
unnamed: R7.1, YELLOW@1.A
unnamed: R6.1, YELLOW@2.A
unnamed: R5.1, RED.A
unnamed: GREEB@2.C, GREEN@1.C, GREEN@3.C, RED.C, SJ1.1, YELLOW@1.C, YELLOW@2.C
RESET: H1.P$27 (/RST), H2.P$27 (/RST), JP1.9, JP5.7
SCK: H1.P$33 (SCK), H2.P$33 (SCK), JP2.7
SCL: H1.P$29 (SCL), H2.P$29 (SCL), IC1.2 (SCL), JP5.5, U1.1 (SCL)
SDA: H1.P$30 (SDA), H2.P$30 (SDA), IC1.1 (SDA), JP2.5, U1.6 (SDA)
USB_VBUS: H1.P$21 (BATV_SW3), H1.P$22 (BATV_SW3), H2.P$21 (BATV_SW3), H2.P$22 (BATV_SW3), JP5.8

Notes on the sheet:
TITLE:
Date:
REV:
Sheet:
Design by:
Fiducial markers

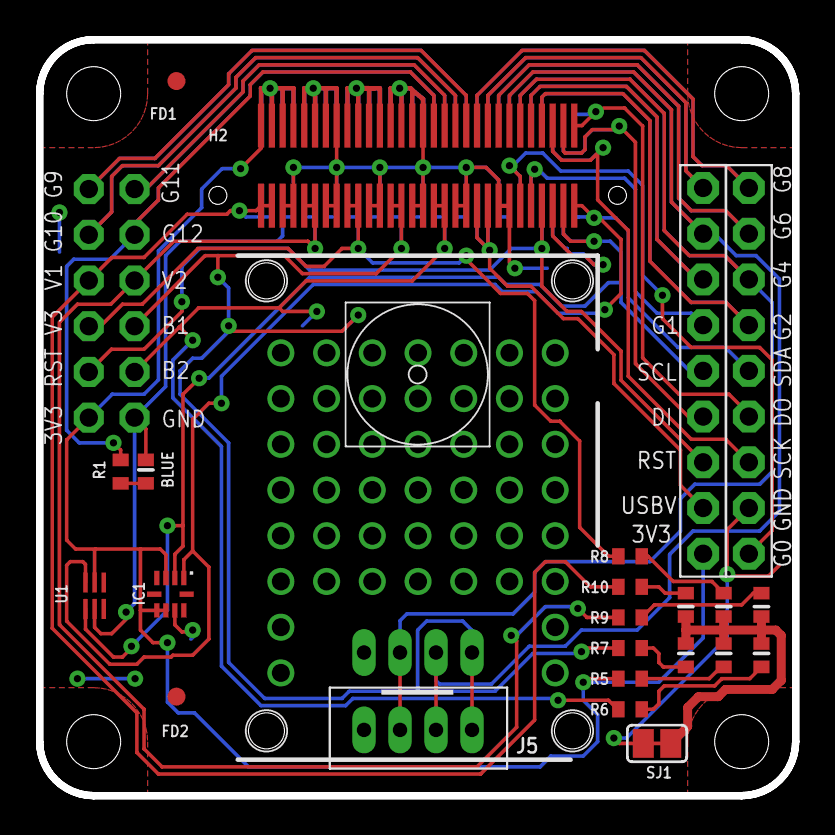
[picture p46: board PSB.brd from above]

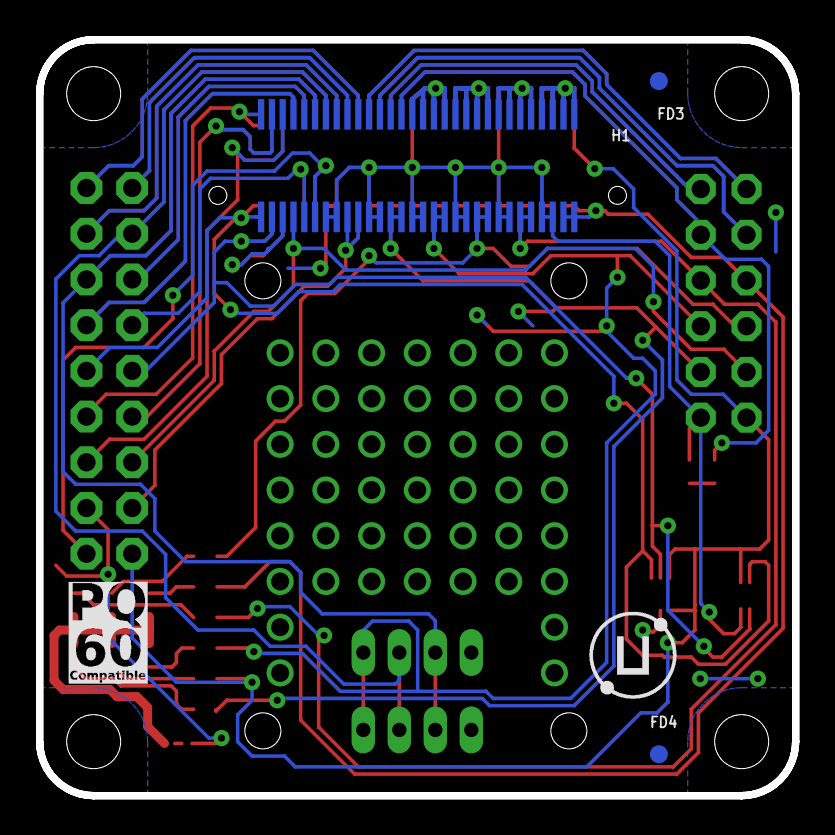
[picture p47: board PSB.brd from below]

Board: 2 copper layers, 42.0 x 42.0 mm, 31 parts (5 on the bottom side), 36 nets.

Other parts of the board:
U$1: SA_LOGO_SMALL
U$2: UBO_LOGO
U$3: PQ60_CMP
