SatelliteApplicationsCatapult/PocketQube/hardware/Electronic/PCB Designs/EPS/EPS.brd

## EAGLE design hardware/Electronic/PCB Designs/EPS/EPS.brd (2022-01-14)

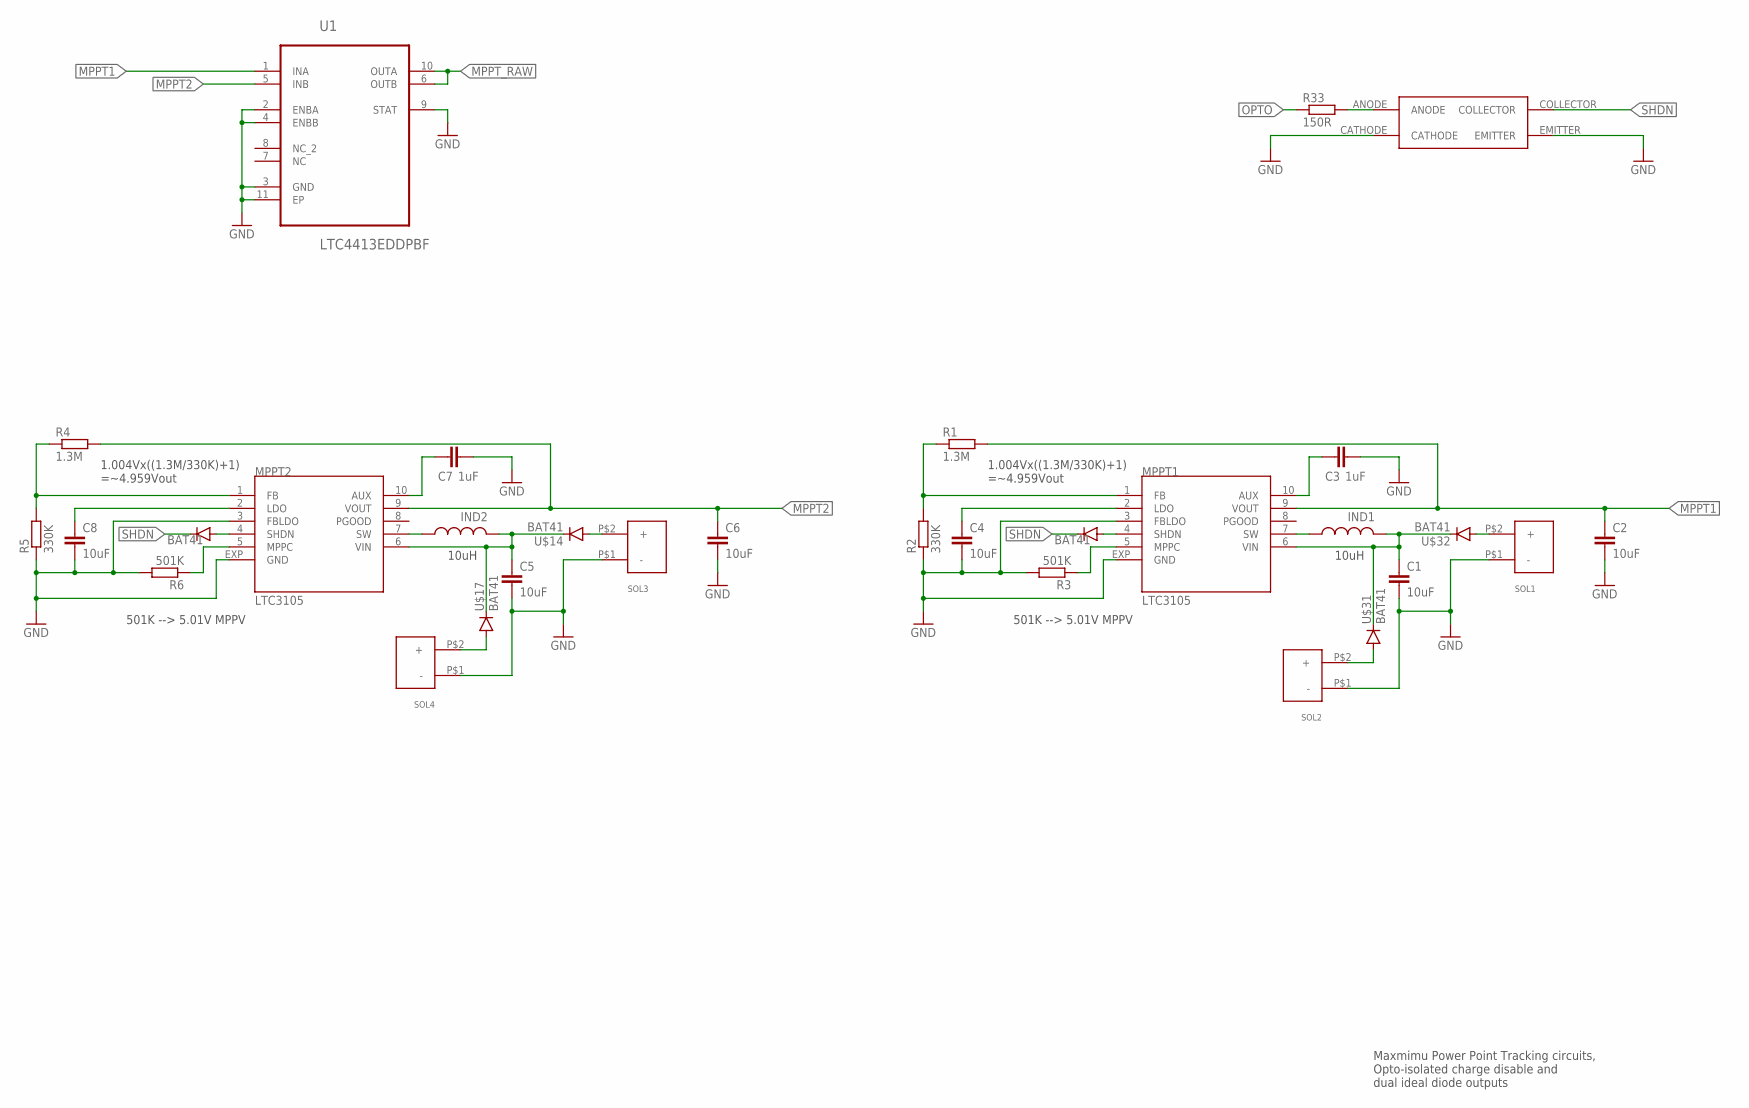
[picture p48: schematic EPS.sch, sheet 1]

Parts:
C1, C2, C4, C5, C6, C8: 10uF; C0603
C3, C7: 1uF; C0402
IND1, IND2: WE-TPC-744031100
MPPT1, MPPT2: LTC3105; DFN-3X3
R1, R4: 1.3M; R0402
R2, R5: 330K; R0402
R3, R6: 501K; R0402
R33: 150R; R0402
SOL1, SOL2, SOL3, SOL4: JST-B2B-ZH; JST-B2B-ZR
U1: LTC4413EDDPBF; DFN300X300X80-11N
U$4, U$10, U$14, U$17, U$31, U$32: BAT41; SOD-123
U$24: EL3H7

Connections:
GND: C1.2, C2.2, C3.2, C4.2, C5.2, C6.2, C7.2, C8.2, MPPT1.3 (FBLDO), MPPT1.EXP (GND), MPPT2.3 (FBLDO), MPPT2.EXP (GND), R2.1, R3.2, R5.1, R6.2, SOL1.P$1 (-), SOL2.P$1 (-), SOL3.P$1 (-), SOL4.P$1 (-), U1.2 (ENBA), U1.3 (GND), U1.4 (ENBB), U1.9 (STAT), U1.11 (EP), U$24.CATHODE, U$24.EMITTER; also elsewhere on the board
MPPT1: C2.1, MPPT1.9 (VOUT), R1.2, U1.1 (INA)
MPPT2: C6.1, MPPT2.9 (VOUT), R4.2, U1.5 (INB)
MPPT_RAW: U1.6 (OUTB), U1.10 (OUTA); also elsewhere on the board
unnamed: IND1.P$1 (1), MPPT1.7 (SW)
unnamed: C1.1, IND1.P$3 (2), MPPT1.6 (VIN), U$31.P$1 (C), U$32.P$1 (C)
unnamed: IND2.P$1 (1), MPPT2.7 (SW)
unnamed: C3.1, MPPT1.10 (AUX)
unnamed: C7.1, MPPT2.10 (AUX)
unnamed: C5.1, IND2.P$3 (2), MPPT2.6 (VIN), U$14.P$1 (C), U$17.P$1 (C)
unnamed: MPPT2.1 (FB), R4.1, R5.2
unnamed: C4.1, MPPT1.2 (LDO)
unnamed: MPPT1.1 (FB), R1.1, R2.2
unnamed: MPPT2.5 (MPPC), R6.1
unnamed: C8.1, MPPT2.2 (LDO)
unnamed: MPPT2.4 (SHDN), U$10.P$2 (A)
unnamed: SOL4.P$2 (+), U$17.P$2 (A)
unnamed: MPPT1.4 (SHDN), U$4.P$2 (A)
unnamed: MPPT1.5 (MPPC), R3.1
unnamed: SOL3.P$2 (+), U$14.P$2 (A)
unnamed: SOL2.P$2 (+), U$31.P$2 (A)
unnamed: SOL1.P$2 (+), U$32.P$2 (A)
unnamed: R33.2, U$24.ANODE
OPTO: R33.1; also elsewhere on the board
SHDN: U$4.P$1 (C), U$10.P$1 (C), U$24.COLLECTOR

Notes on the sheet:
10uH
501K --> 5.01V MPPV
1.004Vx((1.3M/330K)+1) =~4.959Vout
Maxmimu Power Point Tracking circuits, Opto-isolated charge disable and dual ideal diode outputs

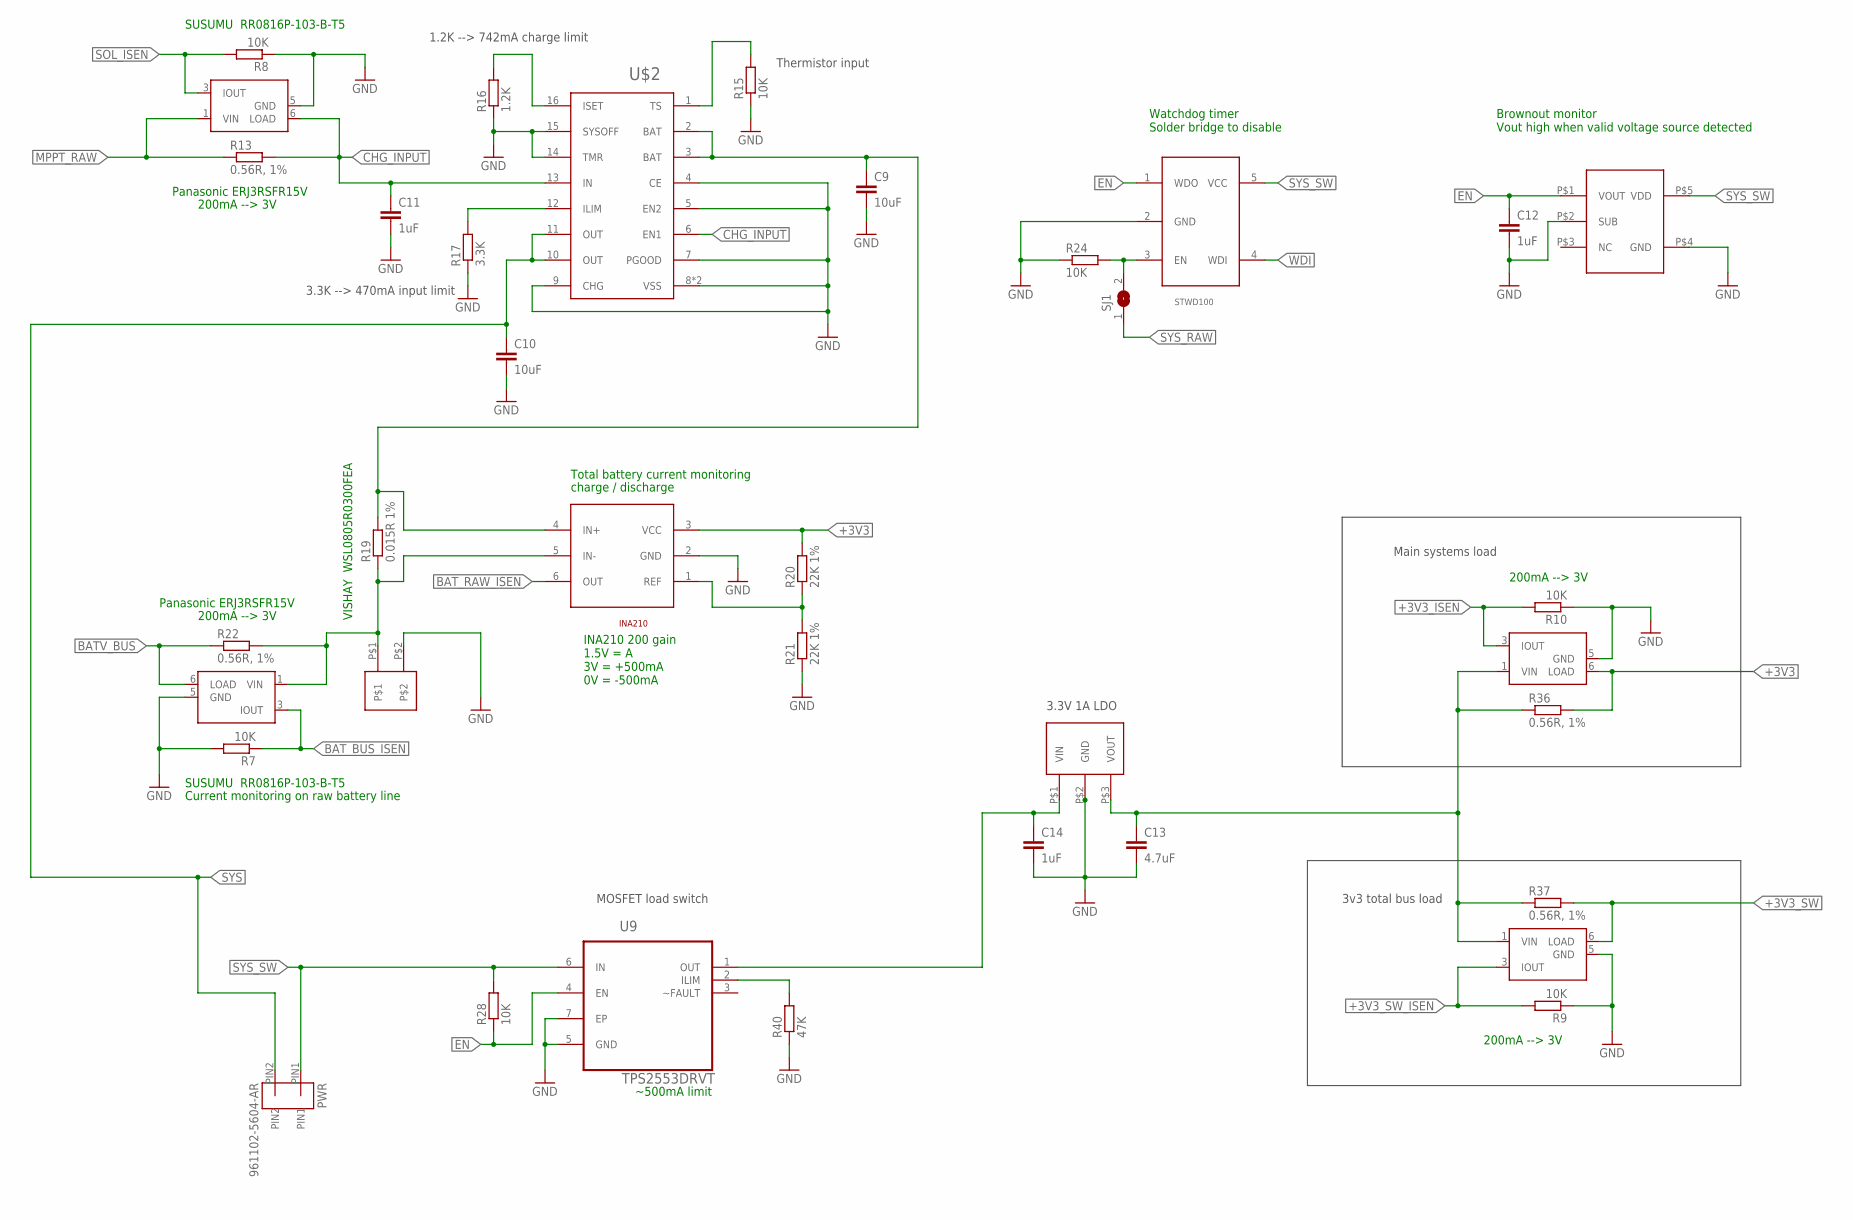
[picture p49: schematic EPS.sch, sheet 2]

Parts:
C9, C10: 10uF; C0805
C11, C12, C14: 1uF; C0603
C13: 4.7uF; C0805
INA210: INA211A; SC-70
PWR: 961102-5604-AR
R7, R8, R9, R10, R15, R24, R28: 10K; R0402
R13, R22, R36, R37: 0.56R, 1%; R0603
R16: 1.2K; R0402
R17: 3.3K; R0402
R19: 0.015R 1%; R0603
R20, R21: 22K 1%; R0402
R40: 47K; R0402
SJ1: SJ
STWD100: STWD100PYW83F; SOT_323-5
U9: TPS2553DRVT; SON65P200X200X80-7N
U$2: BQ24079; PVQFN16-THERM
U$3: PICOBLADE53047
U$18, U$19, U$25, U$26: FAN4010IL6X_F113
U$20: MCP1826S; SOT223-3
U$29: BD4835FVE; VSOF5

Connections:
+3V3: INA210.3 (VCC), R20.2, R36.2, U$25.6 (LOAD); also elsewhere on the board
+3V3_ISEN: R10.2, U$25.3 (IOUT); also elsewhere on the board
+3V3_REG: C13.1, R36.1, R37.1, U$20.P$3 (VOUT), U$25.1 (VIN), U$26.1 (VIN)
+3V3_SW: R37.2, U$26.6 (LOAD); also elsewhere on the board
+3V3_SW_ISEN: R9.2, U$26.3 (IOUT); also elsewhere on the board
BATV_BUS: R22.1, U$19.6 (LOAD); also elsewhere on the board
BAT_BUS_ISEN: R7.1, U$19.3 (IOUT); also elsewhere on the board
BAT_RAW_ISEN: INA210.6 (OUT); also elsewhere on the board
CHG_INPUT: C11.1, R13.2, U$2.6 (EN1), U$2.13 (IN), U$18.6 (LOAD); also elsewhere on the board
EN: C12.1, R28.1, STWD100.1 (WDO), U9.4 (EN), U$29.P$1 (VOUT); also elsewhere on the board
GND: C9.2, C10.2, C11.2, C12.2, C13.2, C14.2, INA210.2 (GND), R7.2, R8.1, R9.1, R10.1, R15.1, R16.1, R17.1, R21.1, R24.1, R40.1, STWD100.2 (GND), U9.5 (GND), U9.7 (EP), U$2.4 (CE), U$2.5 (EN2), U$2.7 (PGOOD), U$2.8 (VSS), U$2.9 (CHG), U$2.14 (TMR), U$2.15 (SYSOFF), U$2.17 (VSS), U$3.P$2, U$18.5 (GND), U$19.5 (GND), U$20.P$2 (GND), U$20.P$4 (GND), U$25.5 (GND), U$26.5 (GND), U$29.P$2 (SUB), U$29.P$4 (GND); also elsewhere on the board
MPPT_RAW: R13.1, U$18.1 (VIN); also elsewhere on the board
unnamed: C14.1, U9.1 (OUT), U$20.P$1 (VIN)
unnamed: C9.1, INA210.4 (IN+), R19.2, U$2.2 (BAT), U$2.3 (BAT)
unnamed: R15.2, U$2.1 (TS)
unnamed: R16.2, U$2.16 (ISET)
unnamed: R17.2, U$2.12 (ILIM)
unnamed: INA210.5 (IN-), R19.1, R22.2, U$3.P$1, U$19.1 (VIN)
unnamed: INA210.1 (REF), R20.1, R21.2
unnamed: R24.2, SJ1.2, STWD100.3 (EN)
unnamed: R40.2, U9.2 (ILIM)
SOL_ISEN: R8.2, U$18.3 (IOUT); also elsewhere on the board
SYS: C10.1, PWR.PIN2, U$2.10 (OUT), U$2.11 (OUT)
SYS_RAW: SJ1.1
SYS_SW: PWR.PIN1, R28.2, STWD100.5 (VCC), U9.6 (IN), U$29.P$5 (VDD)
WDI: STWD100.4 (WDI); also elsewhere on the board

Notes on the sheet:
Panasonic ERJ3RSFR15V
200mA --> 3V
SUSUMU RR0816P-103-B-T5
VISHAY WSL0805R0300FEA
Total battery current monitoring
charge / discharge
INA210 200 gain 1.5V = A 3V = +500mA 0V = -500mA
Current monitoring on raw battery line
Main systems load
3v3 total bus load
~500mA limit
Watchdog timer Solder bridge to disable
Brownout monitor Vout high when valid voltage source detected
MOSFET load switch
3.3V 1A LDO
1.2K --> 742mA charge limit
3.3K --> 470mA input limit
Thermistor input

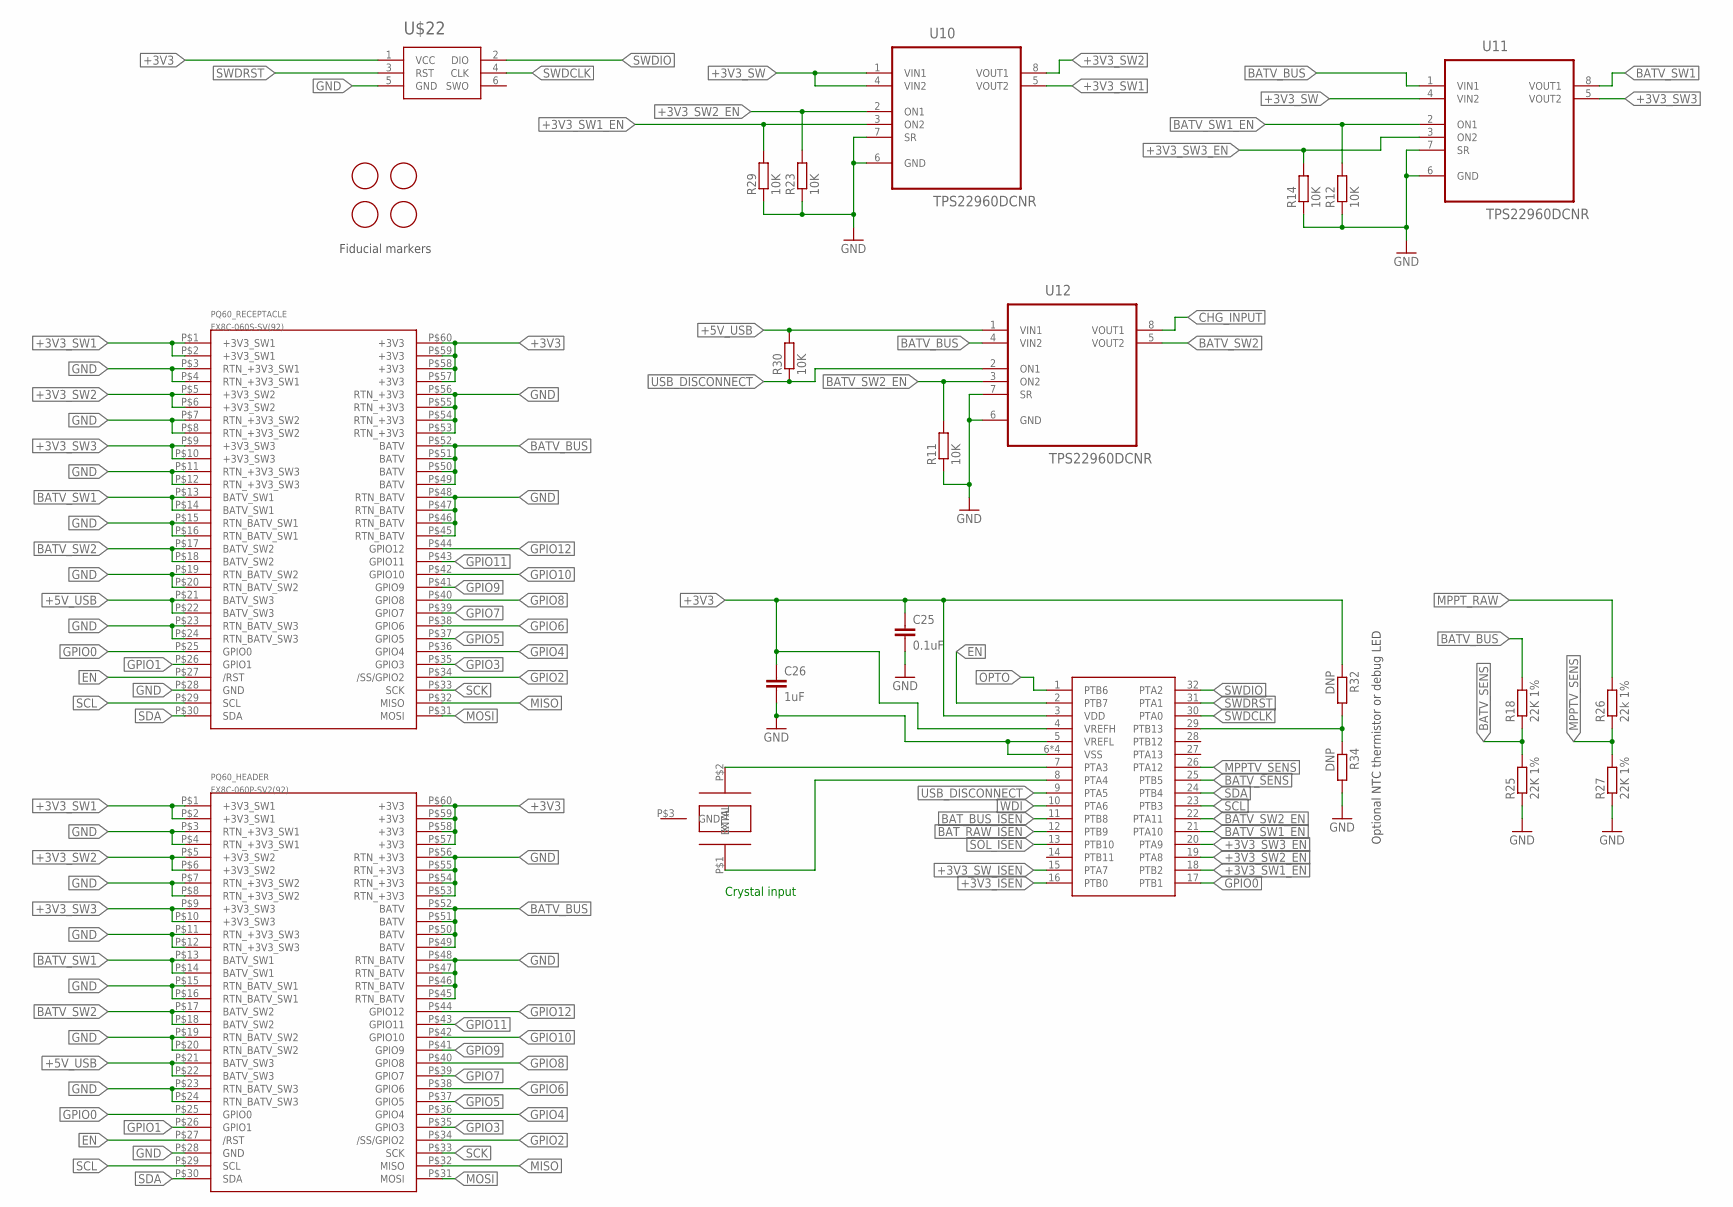
[picture p50: schematic EPS.sch, sheet 3]

Parts:
C25: 0.1uF; C0402
C26: 1uF; C0402
FD1, FD2, FD3, FD4: FIDUCIAL; FIDUCIAL_1MM
PQ60_HEADER: FX8C-060P-SV2(92); FX8C-060P-SV(92)
PQ60_RECEPTACLE: FX8C-060S-SV(92)
R11, R12, R14, R23, R29, R30: 10K; R0402
R18, R25, R27: 22K 1%; R0402
R26: 22k 1%; R0402
R32, R34: DNP; R0402
U10, U11, U12: TPS22960DCNR; SOT65P280X145-8N
U$1: AB26TRQ
U$21: MKL02Z16VFM4
U$22: TAG_CONNECT_NO_HOLES

Connections:
+3V3: C25.1, C26.1, PQ60_HEADER.P$57 (+3V3), PQ60_HEADER.P$58 (+3V3), PQ60_HEADER.P$59 (+3V3), PQ60_HEADER.P$60 (+3V3), PQ60_RECEPTACLE.P$57 (+3V3), PQ60_RECEPTACLE.P$58 (+3V3), PQ60_RECEPTACLE.P$59 (+3V3), PQ60_RECEPTACLE.P$60 (+3V3), R32.1, U$21.3 (VDD), U$21.4 (VREFH), U$22.1 (VCC); also elsewhere on the board
+3V3_ISEN: U$21.16 (PTB0); also elsewhere on the board
+3V3_SW: U10.1 (VIN1), U10.4 (VIN2), U11.4 (VIN2); also elsewhere on the board
+3V3_SW1: PQ60_HEADER.P$1 (+3V3_SW1), PQ60_HEADER.P$2 (+3V3_SW1), PQ60_RECEPTACLE.P$1 (+3V3_SW1), PQ60_RECEPTACLE.P$2 (+3V3_SW1), U10.5 (VOUT2)
+3V3_SW1_EN: R29.2, U10.3 (ON2), U$21.18 (PTB2)
+3V3_SW2: PQ60_HEADER.P$5 (+3V3_SW2), PQ60_HEADER.P$6 (+3V3_SW2), PQ60_RECEPTACLE.P$5 (+3V3_SW2), PQ60_RECEPTACLE.P$6 (+3V3_SW2), U10.8 (VOUT1)
+3V3_SW2_EN: R23.2, U10.2 (ON1), U$21.19 (PTA8)
+3V3_SW3: PQ60_HEADER.P$9 (+3V3_SW3), PQ60_HEADER.P$10 (+3V3_SW3), PQ60_RECEPTACLE.P$9 (+3V3_SW3), PQ60_RECEPTACLE.P$10 (+3V3_SW3), U11.5 (VOUT2)
+3V3_SW3_EN: R14.2, U11.3 (ON2), U$21.20 (PTA9)
+3V3_SW_ISEN: U$21.15 (PTA7); also elsewhere on the board
+5V_USB: PQ60_HEADER.P$21 (BATV_SW3), PQ60_HEADER.P$22 (BATV_SW3), PQ60_RECEPTACLE.P$21 (BATV_SW3), PQ60_RECEPTACLE.P$22 (BATV_SW3), R30.2, U12.1 (VIN1)
BATV_BUS: PQ60_HEADER.P$49 (BATV), PQ60_HEADER.P$50 (BATV), PQ60_HEADER.P$51 (BATV), PQ60_HEADER.P$52 (BATV), PQ60_RECEPTACLE.P$49 (BATV), PQ60_RECEPTACLE.P$50 (BATV), PQ60_RECEPTACLE.P$51 (BATV), PQ60_RECEPTACLE.P$52 (BATV), R18.2, U11.1 (VIN1), U12.4 (VIN2); also elsewhere on the board
BATV_SENS: R18.1, R25.2, U$21.25 (PTB5)
BATV_SW1: PQ60_HEADER.P$13 (BATV_SW1), PQ60_HEADER.P$14 (BATV_SW1), PQ60_RECEPTACLE.P$13 (BATV_SW1), PQ60_RECEPTACLE.P$14 (BATV_SW1), U11.8 (VOUT1)
BATV_SW1_EN: R12.2, U11.2 (ON1), U$21.21 (PTA10)
BATV_SW2: PQ60_HEADER.P$17 (BATV_SW2), PQ60_HEADER.P$18 (BATV_SW2), PQ60_RECEPTACLE.P$17 (BATV_SW2), PQ60_RECEPTACLE.P$18 (BATV_SW2), U12.5 (VOUT2)
BATV_SW2_EN: R11.2, U12.3 (ON2), U$21.22 (PTA11)
BAT_BUS_ISEN: U$21.11 (PTB8); also elsewhere on the board
BAT_RAW_ISEN: U$21.12 (PTB9); also elsewhere on the board
CHG_INPUT: U12.8 (VOUT1); also elsewhere on the board
EN: PQ60_HEADER.P$27 (/RST), PQ60_RECEPTACLE.P$27 (/RST), U$21.2 (PTB7); also elsewhere on the board
GND: C25.2, C26.2, PQ60_HEADER.P$3 (RTN_+3V3_SW1), PQ60_HEADER.P$4 (RTN_+3V3_SW1), PQ60_HEADER.P$7 (RTN_+3V3_SW2), PQ60_HEADER.P$8 (RTN_+3V3_SW2), PQ60_HEADER.P$11 (RTN_+3V3_SW3), PQ60_HEADER.P$12 (RTN_+3V3_SW3), PQ60_HEADER.P$15 (RTN_BATV_SW1), PQ60_HEADER.P$16 (RTN_BATV_SW1), PQ60_HEADER.P$19 (RTN_BATV_SW2), PQ60_HEADER.P$20 (RTN_BATV_SW2), PQ60_HEADER.P$23 (RTN_BATV_SW3), PQ60_HEADER.P$24 (RTN_BATV_SW3), PQ60_HEADER.P$28 (GND), PQ60_HEADER.P$45 (RTN_BATV), PQ60_HEADER.P$46 (RTN_BATV), PQ60_HEADER.P$47 (RTN_BATV), PQ60_HEADER.P$48 (RTN_BATV), PQ60_HEADER.P$53 (RTN_+3V3), PQ60_HEADER.P$54 (RTN_+3V3), PQ60_HEADER.P$55 (RTN_+3V3), PQ60_HEADER.P$56 (RTN_+3V3), PQ60_RECEPTACLE.P$3 (RTN_+3V3_SW1), PQ60_RECEPTACLE.P$4 (RTN_+3V3_SW1), PQ60_RECEPTACLE.P$7 (RTN_+3V3_SW2), PQ60_RECEPTACLE.P$8 (RTN_+3V3_SW2), PQ60_RECEPTACLE.P$11 (RTN_+3V3_SW3), PQ60_RECEPTACLE.P$12 (RTN_+3V3_SW3), PQ60_RECEPTACLE.P$15 (RTN_BATV_SW1), PQ60_RECEPTACLE.P$16 (RTN_BATV_SW1), PQ60_RECEPTACLE.P$19 (RTN_BATV_SW2), PQ60_RECEPTACLE.P$20 (RTN_BATV_SW2), PQ60_RECEPTACLE.P$23 (RTN_BATV_SW3), PQ60_RECEPTACLE.P$24 (RTN_BATV_SW3), PQ60_RECEPTACLE.P$28 (GND), PQ60_RECEPTACLE.P$45 (RTN_BATV), PQ60_RECEPTACLE.P$46 (RTN_BATV), PQ60_RECEPTACLE.P$47 (RTN_BATV), PQ60_RECEPTACLE.P$48 (RTN_BATV), PQ60_RECEPTACLE.P$53 (RTN_+3V3), PQ60_RECEPTACLE.P$54 (RTN_+3V3), PQ60_RECEPTACLE.P$55 (RTN_+3V3), PQ60_RECEPTACLE.P$56 (RTN_+3V3), R11.1, R12.1, R14.1, R23.1, R25.1, R27.1, R29.1, R34.2, U10.6 (GND), U10.7 (SR), U11.6 (GND), U11.7 (SR), U12.6 (GND), U12.7 (SR), U$21.5 (VREFL), U$21.6 (VSS), U$21.GND@1 (VSS), U$21.GND@2 (VSS), U$21.GND@3 (VSS), U$22.5 (GND); also elsewhere on the board
GPIO0: PQ60_HEADER.P$25 (GPIO0), PQ60_RECEPTACLE.P$25 (GPIO0), U$21.17 (PTB1)
GPIO1: PQ60_HEADER.P$26 (GPIO1), PQ60_RECEPTACLE.P$26 (GPIO1)
GPIO2: PQ60_HEADER.P$34 (/SS/GPIO2), PQ60_RECEPTACLE.P$34 (/SS/GPIO2)
GPIO3: PQ60_HEADER.P$35 (GPIO3), PQ60_RECEPTACLE.P$35 (GPIO3)
GPIO4: PQ60_HEADER.P$36 (GPIO4), PQ60_RECEPTACLE.P$36 (GPIO4)
GPIO5: PQ60_HEADER.P$37 (GPIO5), PQ60_RECEPTACLE.P$37 (GPIO5)
GPIO6: PQ60_HEADER.P$38 (GPIO6), PQ60_RECEPTACLE.P$38 (GPIO6)
GPIO7: PQ60_HEADER.P$39 (GPIO7), PQ60_RECEPTACLE.P$39 (GPIO7)
GPIO8: PQ60_HEADER.P$40 (GPIO8), PQ60_RECEPTACLE.P$40 (GPIO8)
GPIO9: PQ60_HEADER.P$41 (GPIO9), PQ60_RECEPTACLE.P$41 (GPIO9)
GPIO10: PQ60_HEADER.P$42 (GPIO10), PQ60_RECEPTACLE.P$42 (GPIO10)
GPIO11: PQ60_HEADER.P$43 (GPIO11), PQ60_RECEPTACLE.P$43 (GPIO11)
GPIO12: PQ60_HEADER.P$44 (GPIO12), PQ60_RECEPTACLE.P$44 (GPIO12)
MISO: PQ60_HEADER.P$32 (MISO), PQ60_RECEPTACLE.P$32 (MISO)
MOSI: PQ60_HEADER.P$31 (MOSI), PQ60_RECEPTACLE.P$31 (MOSI)
MPPTV_SENS: R26.1, R27.2, U$21.26 (PTA12)
MPPT_RAW: R26.2; also elsewhere on the board
unnamed: U$1.P$2 (EXTAL), U$21.7 (PTA3)
unnamed: R32.2, R34.1, U$21.29 (PTB13)
unnamed: U$1.P$1 (XTAL), U$21.8 (PTA4)
OPTO: U$21.1 (PTB6); also elsewhere on the board
SCK: PQ60_HEADER.P$33 (SCK), PQ60_RECEPTACLE.P$33 (SCK)
SCL: PQ60_HEADER.P$29 (SCL), PQ60_RECEPTACLE.P$29 (SCL), U$21.23 (PTB3)
SDA: PQ60_HEADER.P$30 (SDA), PQ60_RECEPTACLE.P$30 (SDA), U$21.24 (PTB4)
SOL_ISEN: U$21.13 (PTB10); also elsewhere on the board
SWDCLK: U$21.30 (PTA0), U$22.4 (CLK)
SWDIO: U$21.32 (PTA2), U$22.2 (DIO)
SWDRST: U$21.31 (PTA1), U$22.3 (RST)
USB_DISCONNECT: R30.1, U12.2 (ON1), U$21.9 (PTA5)
WDI: U$21.10 (PTA6); also elsewhere on the board

Notes on the sheet:
Fiducial markers
Optional NTC thermistor or debug LED
Crystal input

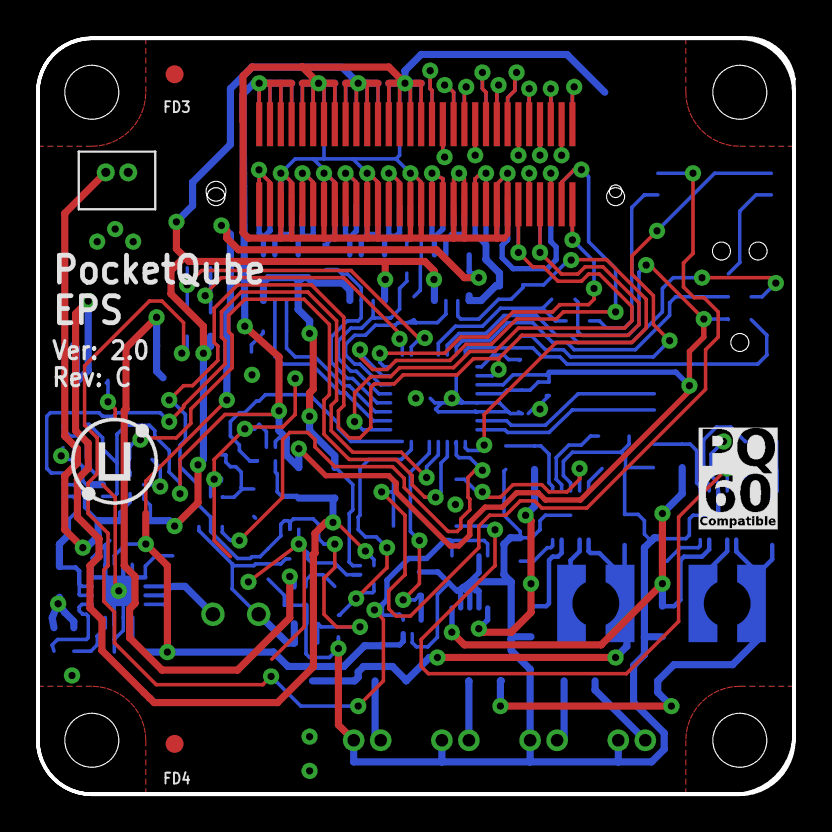
[picture p51: board EPS.brd from above]

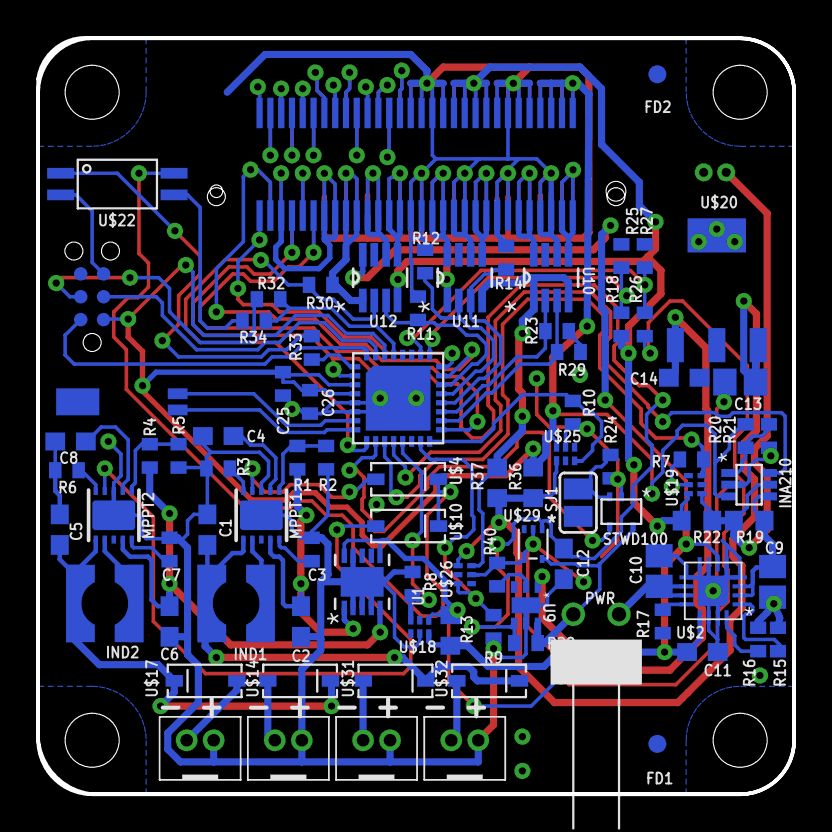
[picture p52: board EPS.brd from below]

Board: 2 copper layers, 42.0 x 42.0 mm, 96 parts (89 on the bottom side), 86 nets.

Other parts of the board:
U$9: SA_LOGO_SMALL
U$13: PQ60_CMP
U$35: UBO_LOGO
