SatelliteApplicationsCatapult/PocketQube/hardware/Electronic/PCB Designs/Breakout/MK20_breakout/MK20_breakout.brd

## EAGLE design hardware/Electronic/PCB Designs/Breakout/MK20_breakout/MK20_breakout.brd (2022-01-14)

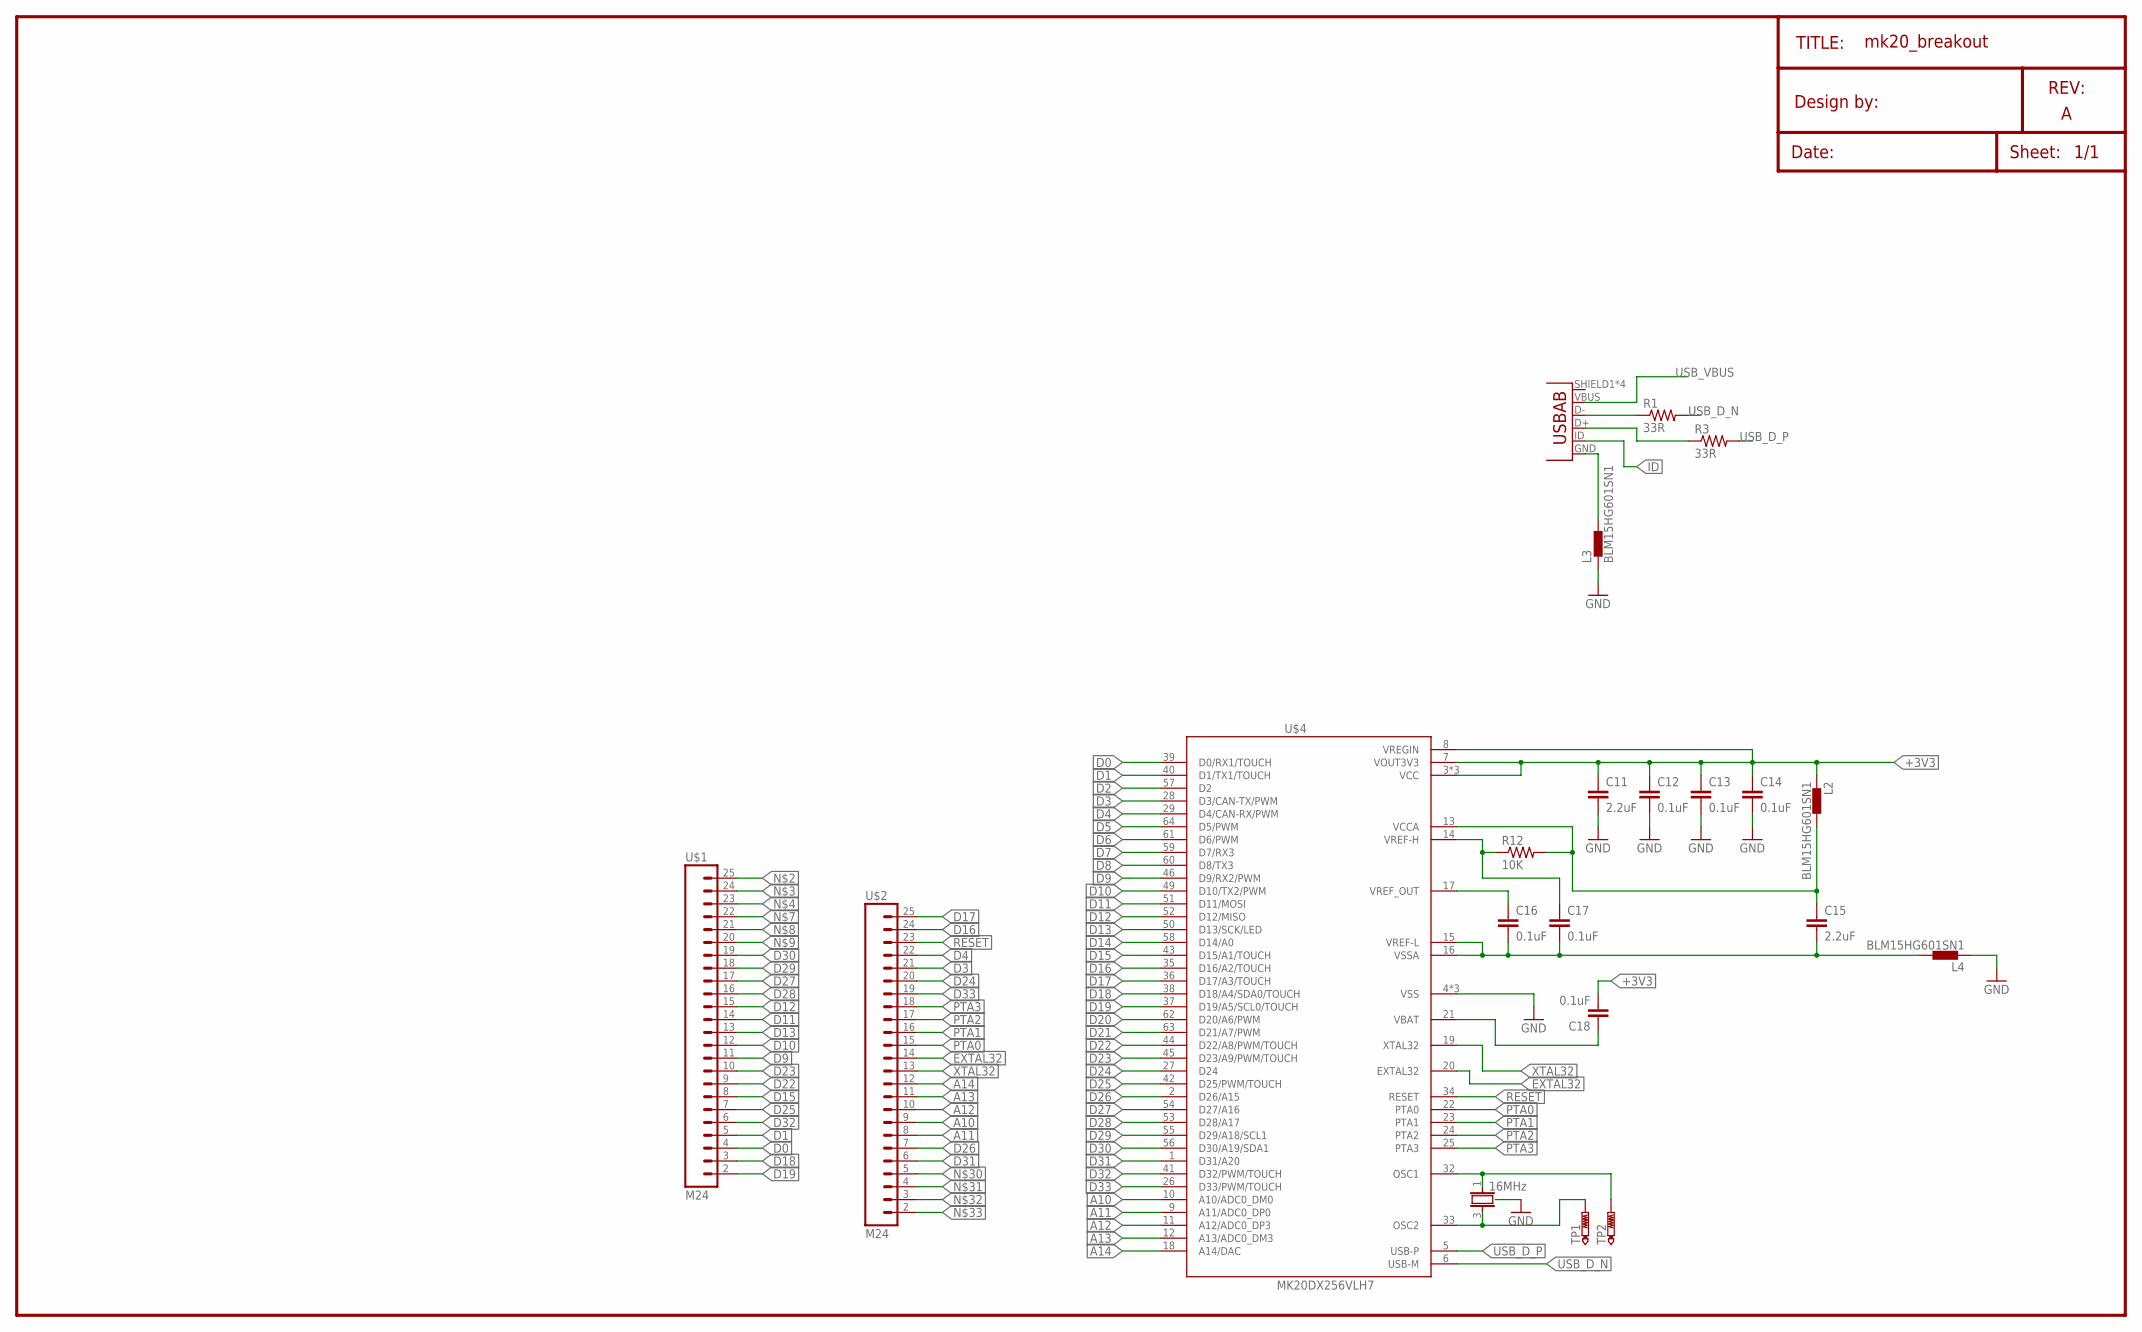
[picture p53: schematic MK20_breakout.sch]

Parts:
C11, C15: 2.2uF; C0603
C12, C13, C14, C16, C17: 0.1uF; C0402
C18: 0.1uF; C0603
JP1: MOLEX 105017-0001; USB-AB-MICRO-SMD
L2, L3, L4: BLM15HG601SN1; 0402
NDK_NX3225SA: 16MHz; 4SMD_DFN_LCC
R1, R3: 33R; 0603-RES
R12: 10K; 0402-RES
TP1, TP2: PTR1TP06R; TP06R
U$1, U$2: M24; 1X24
U$4: MK20DX256VLH7; QFP50P1200X1200X160-64N

Connections:
+3V3: C11.1, C12.1, C13.1, C14.1, C18.2, L2.1, U$4.3 (VCC), U$4.7 (VOUT3V3), U$4.8 (VREGIN), U$4.30 (VCC), U$4.48 (VCC)
A10: U$2.9, U$4.10 (A10/ADC0_DM0)
A11: U$2.8, U$4.9 (A11/ADC0_DP0)
A12: U$2.10, U$4.11 (A12/ADC0_DP3)
A13: U$2.11, U$4.12 (A13/ADC0_DM3)
A14: U$2.12, U$4.18 (A14/DAC)
D0: U$1.4, U$4.39 (D0/RX1/TOUCH)
D1: U$1.5, U$4.40 (D1/TX1/TOUCH)
D2: U$4.57 (D2)
D3: U$2.21, U$4.28 (D3/CAN-TX/PWM)
D4: U$2.22, U$4.29 (D4/CAN-RX/PWM)
D5: U$4.64 (D5/PWM)
D6: U$4.61 (D6/PWM)
D7: U$4.59 (D7/RX3)
D8: U$4.60 (D8/TX3)
D9: U$1.11, U$4.46 (D9/RX2/PWM)
D10: U$1.12, U$4.49 (D10/TX2/PWM)
D11: U$1.14, U$4.51 (D11/MOSI)
D12: U$1.15, U$4.52 (D12/MISO)
D13: U$1.13, U$4.50 (D13/SCK/LED)
D14: U$4.58 (D14/A0)
D15: U$1.8, U$4.43 (D15/A1/TOUCH)
D16: U$2.24, U$4.35 (D16/A2/TOUCH)
D17: U$2.25, U$4.36 (D17/A3/TOUCH)
D18: U$1.3, U$4.38 (D18/A4/SDA0/TOUCH)
D19: U$1.2, U$4.37 (D19/A5/SCL0/TOUCH)
D20: U$4.62 (D20/A6/PWM)
D21: U$4.63 (D21/A7/PWM)
D22: U$1.9, U$4.44 (D22/A8/PWM/TOUCH)
D23: U$1.10, U$4.45 (D23/A9/PWM/TOUCH)
D24: U$2.20, U$4.27 (D24)
D25: U$1.7, U$4.42 (D25/PWM/TOUCH)
D26: U$2.7, U$4.2 (D26/A15)
D27: U$1.17, U$4.54 (D27/A16)
D28: U$1.16, U$4.53 (D28/A17)
D29: U$1.18, U$4.55 (D29/A18/SCL1)
D30: U$1.19, U$4.56 (D30/A19/SDA1)
D31: U$2.6, U$4.1 (D31/A20)
D32: U$1.6, U$4.41 (D32/PWM/TOUCH)
D33: U$2.19, U$4.26 (D33/PWM/TOUCH)
EXTAL32: U$2.14, U$4.20 (EXTAL32)
GND: C11.2, C12.2, C13.2, C14.2, L3.1, L4.1, NDK_NX3225SA.GND, NDK_NX3225SA.GND@1 (GND), NDK_NX3225SA.GND@2 (GND), U$4.4 (VSS), U$4.31 (VSS), U$4.47 (VSS)
ID: JP1.ID (USBID)
unnamed: NDK_NX3225SA.1, TP2.TP, U$4.32 (OSC1)
unnamed: JP1.D+, R3.1
unnamed: JP1.D-, R1.1
unnamed: NDK_NX3225SA.3, TP1.TP, U$4.33 (OSC2)
unnamed: C15.1, L2.2, R12.2, U$4.13 (VCCA)
unnamed: C17.1, R12.1, U$4.14 (VREF-H)
unnamed: C15.2, C16.2, C17.2, L4.2, U$4.15 (VREF-L), U$4.16 (VSSA)
unnamed: C16.1, U$4.17 (VREF_OUT)
unnamed: C18.1, U$4.21 (VBAT)
unnamed: JP1.GND, L3.2
PTA0: U$2.15, U$4.22 (PTA0)
PTA1: U$2.16, U$4.23 (PTA1)
PTA2: U$2.17, U$4.24 (PTA2)
PTA3: U$2.18, U$4.25 (PTA3)
RESET: U$2.23, U$4.34 (RESET)
USB_D_N: R1.2, U$4.6 (USB-M)
USB_D_P: R3.2, U$4.5 (USB-P)
USB_VBUS: JP1.VBUS
XTAL32: U$2.13, U$4.19 (XTAL32)

Notes on the sheet:
TITLE:
Date:
REV:
Sheet:
Design by:

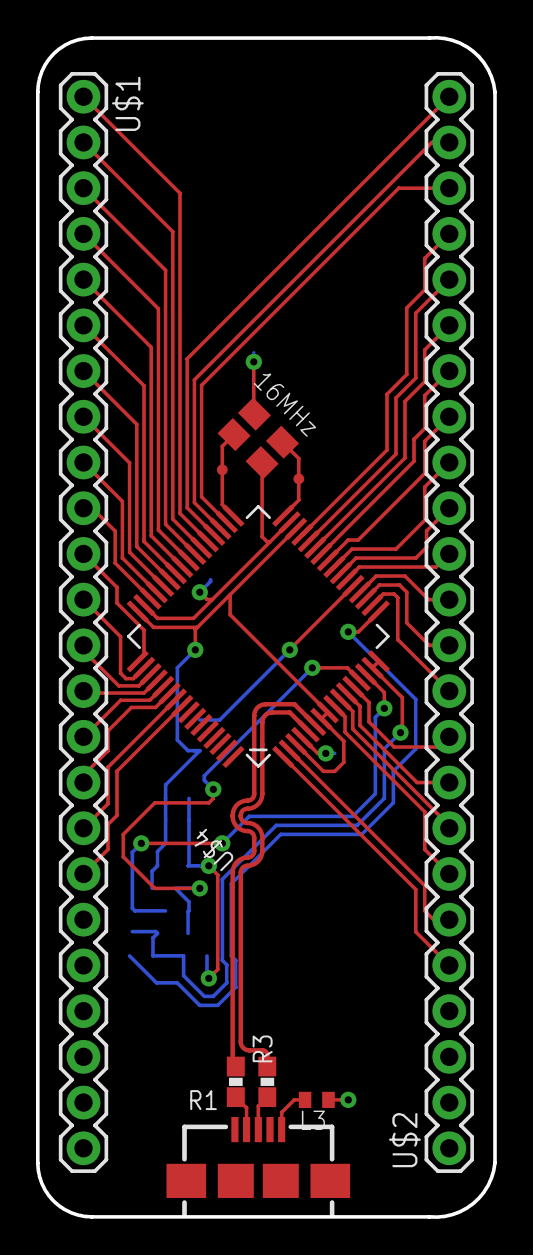
[picture p54: board MK20_breakout.brd from above]

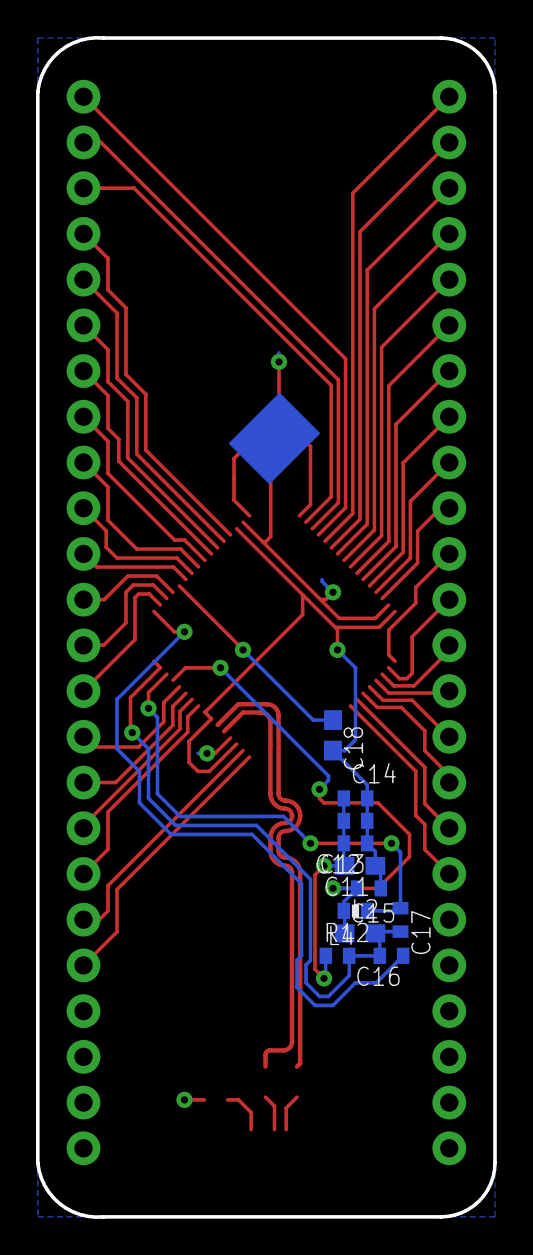
[picture p55: board MK20_breakout.brd from below]

Board: 2 copper layers, 25.4 x 65.5 mm, 21 parts (11 on the bottom side), 52 nets.
