SatelliteApplicationsCatapult/PocketQube/hardware/Electronic/PCB Designs/Breakout/MAX8606_clearance/MAX8606.brd

## EAGLE design hardware/Electronic/PCB Designs/Breakout/MAX8606_clearance/MAX8606.brd (2022-01-14)

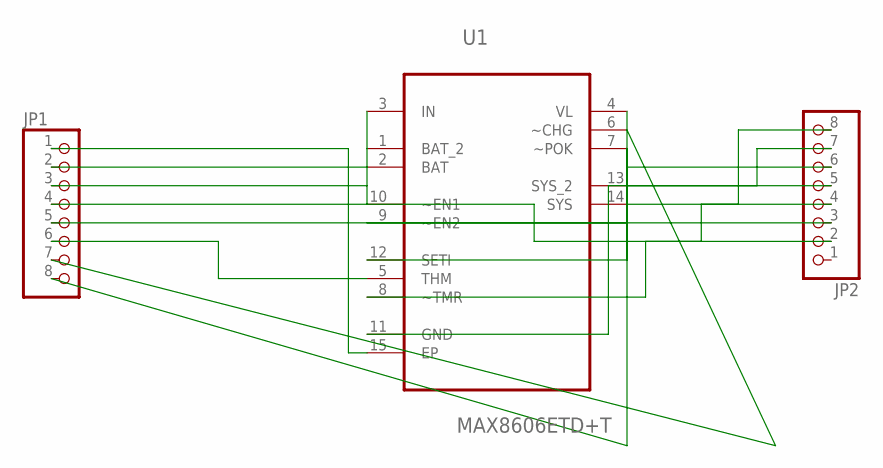
[picture p56: schematic MAX8606.sch]

Parts:
JP1, JP2: PINHD-1X8CLEANBIG; 1X08-CLEANBIG
U1: MAX8606ETD+T; DFN300X300X80-15N

Connections:
GND: JP1.1, JP2.5, U1.11 (GND), U1.15 (EP)
unnamed: JP2.8, U1.14 (SYS)
unnamed: JP2.7, U1.13 (SYS_2)
unnamed: JP2.6, U1.12 (SETI)
unnamed: JP2.4, U1.10 (~EN1)
unnamed: JP2.3, U1.9 (~EN2)
unnamed: JP2.2, U1.8 (~TMR)
unnamed: JP1.8, U1.7 (~POK)
unnamed: JP1.7, U1.6 (~CHG)
unnamed: JP1.5, U1.4 (VL)
unnamed: JP1.2, JP1.3, JP1.4, U1.3 (IN)
unnamed: JP1.6, U1.5 (THM)

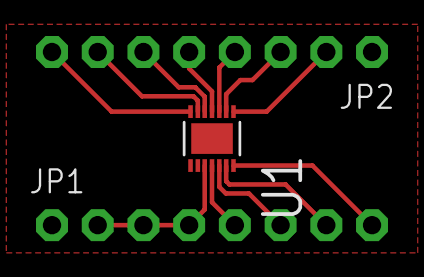
[picture p57: board MAX8606.brd from above]

Board: 2 copper layers, 3 parts (0 on the bottom side), 12 nets.
