SatelliteApplicationsCatapult/PocketQube/hardware/Electronic/PCB Designs/RFP/RFP.brd

## EAGLE design hardware/Electronic/PCB Designs/RFP/RFP.brd (2022-01-14)

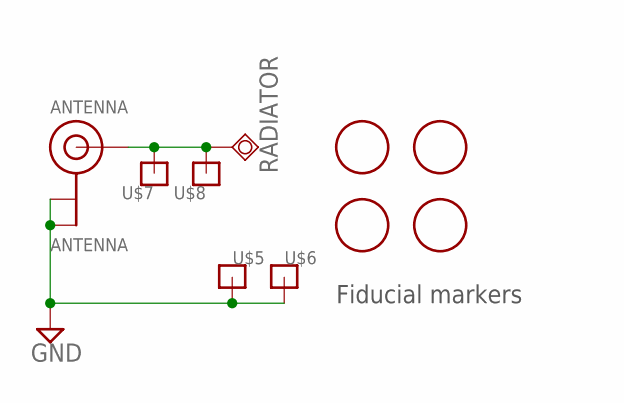
[picture p58: schematic RFP.sch]

Parts:
ANTENNA: ANTENNA; U.FL
FD1, FD2, FD3, FD4: FIDUCIAL; FIDUCIAL_1MM
RADIATOR: TPSQTP20SQ; TP20SQ
U$5, U$6, U$7, U$8: 2MMPILLAR

Connections:
GND: ANTENNA.1 (GND), ANTENNA.2 (GND), U$5.P$1, U$6.P$1
SIGNAL: ANTENNA.3 (SIGNAL), RADIATOR.TP, U$7.P$1, U$8.P$1

Notes on the sheet:
Fiducial markers

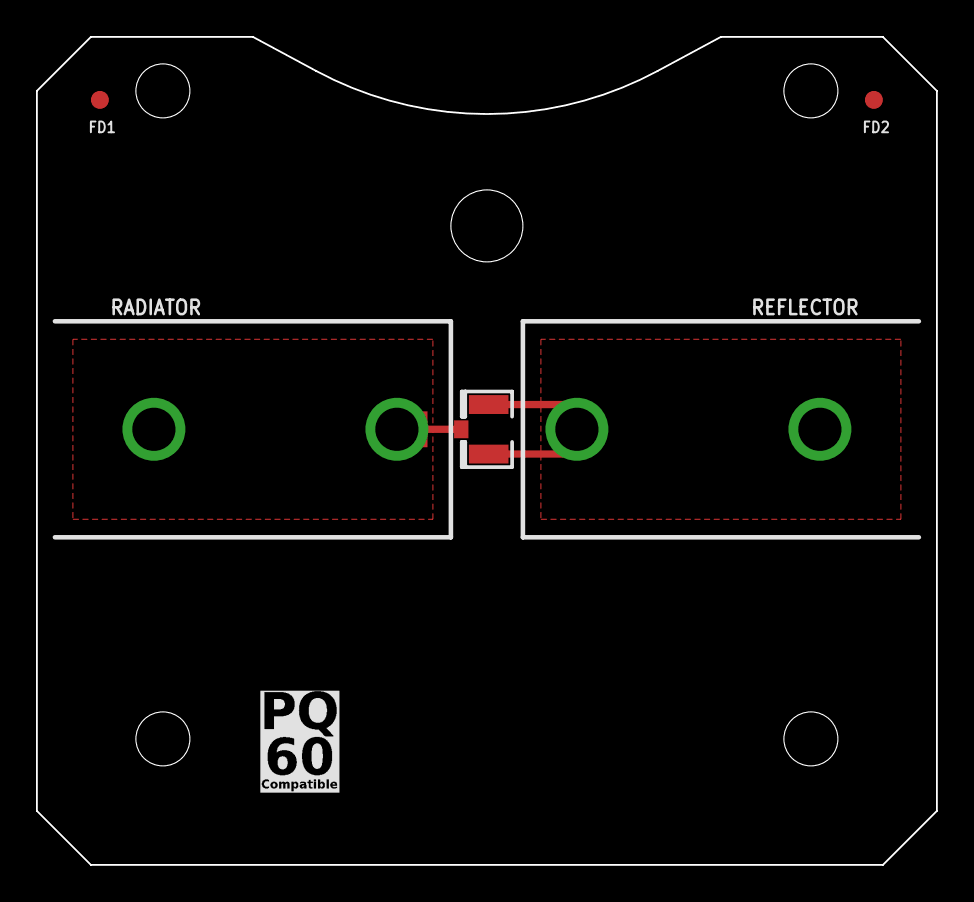
[picture p59: board RFP.brd from above]

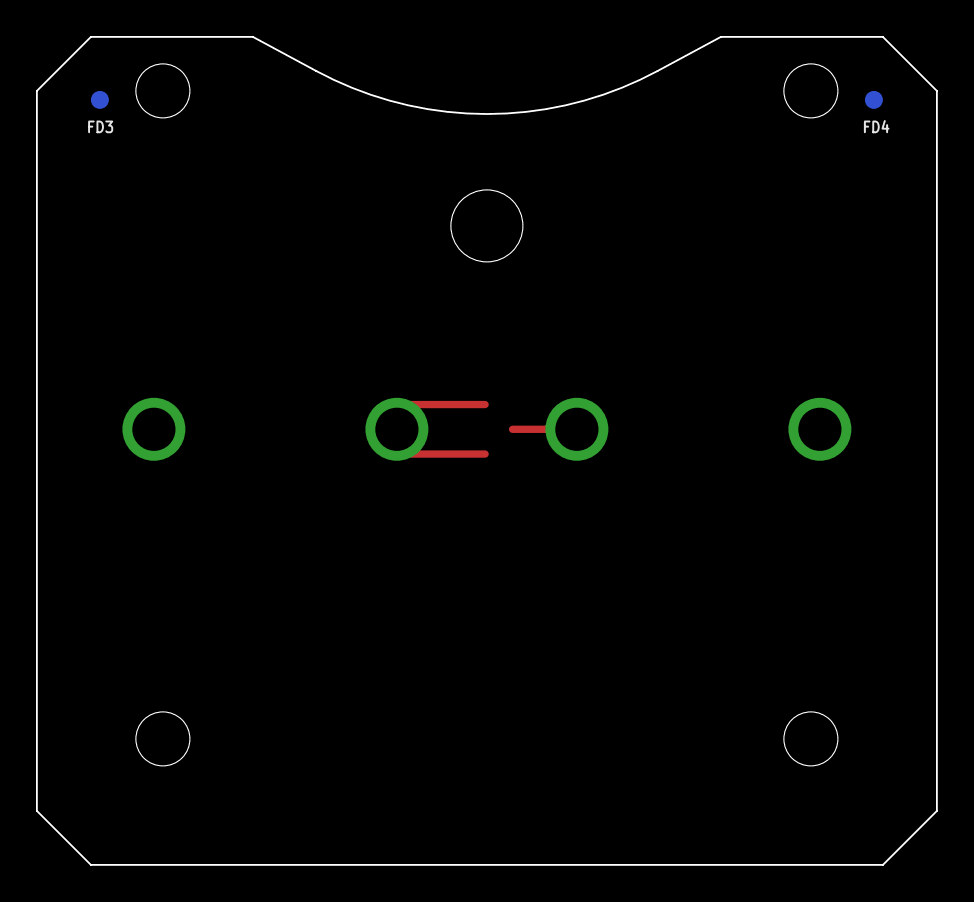
[picture p60: board RFP.brd from below]

Board: 2 copper layers, 50.0 x 46.0 mm, 13 parts (2 on the bottom side), 2 nets.

Other parts of the board:
U$9: SA_LOGO_SMALL
U$10: PQ60_CMP
U$12: UBO_LOGO_LARGE
