SatelliteApplicationsCatapult/PocketQube/hardware/Electronic/PCB Designs/Breakout/MKl02Z_breakout/MKL02Z_breakout.brd

## EAGLE design hardware/Electronic/PCB Designs/Breakout/MKl02Z_breakout/MKL02Z_breakout.brd (2022-01-14)

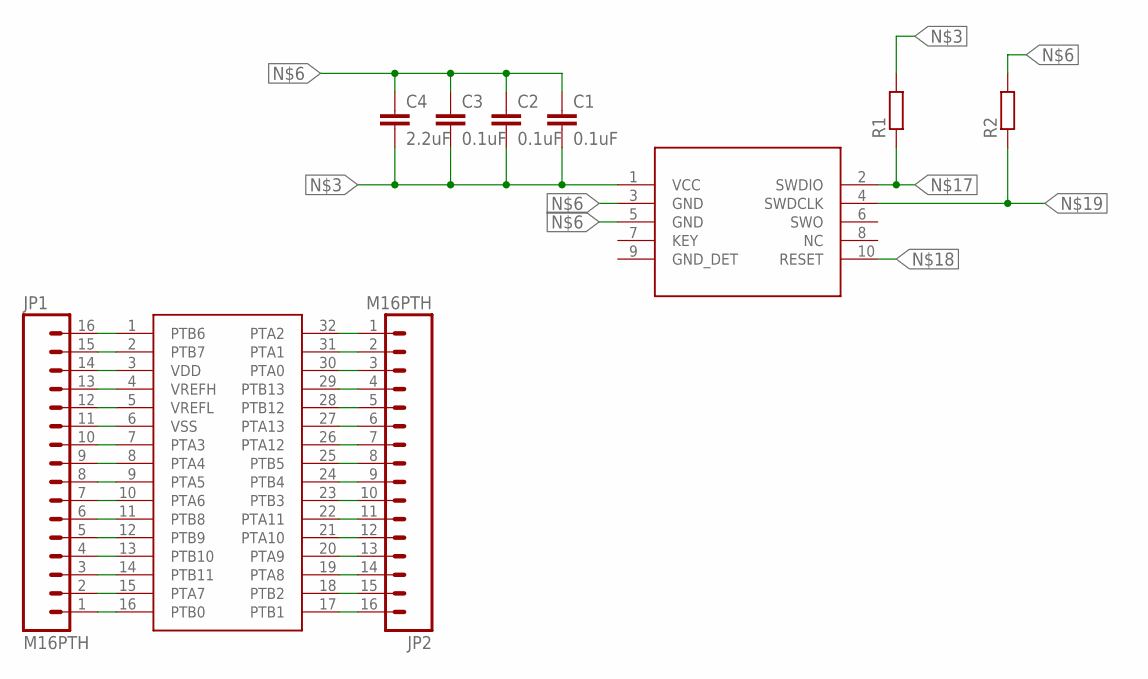
[picture p61: schematic MKL02Z_breakout.sch]

Parts:
C1, C2, C3: 0.1uF; C0603
C4: 2.2uF; C0603
JP1, JP2: M16PTH; 1X16
R1, R2: R-EU_R0603; R0603
U$1: MKL02Z16VFM4
U$2: SWD_10_PIN

Connections:
unnamed: JP1.16, U$1.1 (PTB6)
unnamed: JP1.15, U$1.2 (PTB7)
unnamed: C1.2, C2.2, C3.2, C4.2, JP1.14, R1.2, U$1.3 (VDD), U$2.1 (VCC)
unnamed: JP1.13, U$1.4 (VREFH)
unnamed: JP1.12, U$1.5 (VREFL)
unnamed: C1.1, C2.1, C3.1, C4.1, JP1.11, R2.2, U$1.6 (VSS), U$2.3 (GND), U$2.5 (GND)
unnamed: JP1.10, U$1.7 (PTA3)
unnamed: JP1.9, U$1.8 (PTA4)
unnamed: JP1.8, U$1.9 (PTA5)
unnamed: JP1.7, U$1.10 (PTA6)
unnamed: JP1.6, U$1.11 (PTB8)
unnamed: JP1.5, U$1.12 (PTB9)
unnamed: JP1.4, U$1.13 (PTB10)
unnamed: JP1.3, U$1.14 (PTB11)
unnamed: JP1.2, U$1.15 (PTA7)
unnamed: JP1.1, U$1.16 (PTB0)
unnamed: JP2.1, R1.1, U$1.32 (PTA2), U$2.2 (SWDIO)
unnamed: JP2.2, U$1.31 (PTA1), U$2.10 (RESET)
unnamed: JP2.3, R2.1, U$1.30 (PTA0), U$2.4 (SWDCLK)
unnamed: JP2.4, U$1.29 (PTB13)
unnamed: JP2.5, U$1.28 (PTB12)
unnamed: JP2.6, U$1.27 (PTA13)
unnamed: JP2.7, U$1.26 (PTA12)
unnamed: JP2.8, U$1.25 (PTB5)
unnamed: JP2.9, U$1.24 (PTB4)
unnamed: JP2.10, U$1.23 (PTB3)
unnamed: JP2.11, U$1.22 (PTA11)
unnamed: JP2.12, U$1.21 (PTA10)
unnamed: JP2.13, U$1.20 (PTA9)
unnamed: JP2.14, U$1.19 (PTA8)
unnamed: JP2.15, U$1.18 (PTB2)
unnamed: JP2.16, U$1.17 (PTB1)

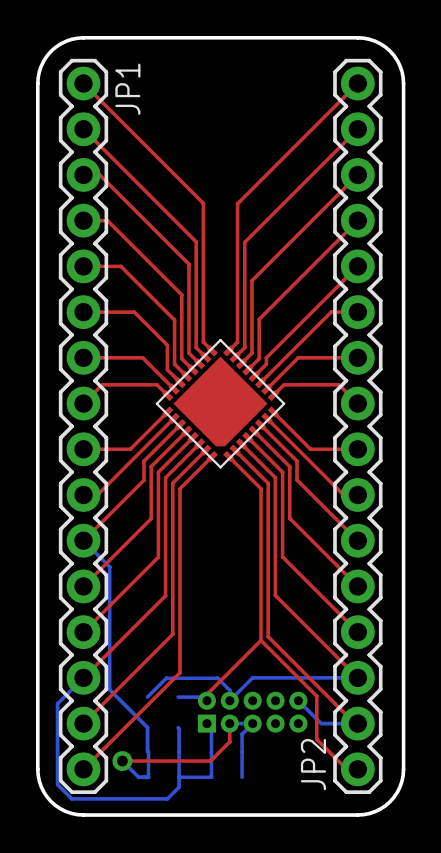
[picture p62: board MKL02Z_breakout.brd from above]

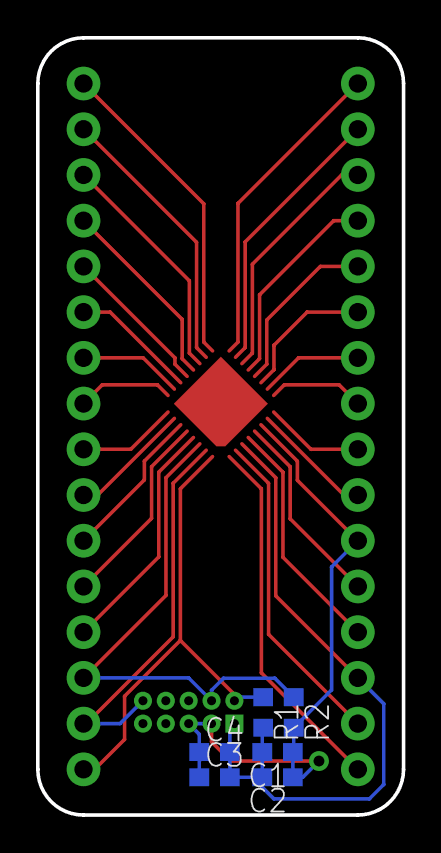
[picture p63: board MKL02Z_breakout.brd from below]

Board: 2 copper layers, 20.3 x 43.2 mm, 10 parts (6 on the bottom side), 32 nets.
