SatelliteApplicationsCatapult/PocketQube/hardware/Electronic/PCB Designs/OBC/OBC.brd

## EAGLE design hardware/Electronic/PCB Designs/OBC/OBC.brd (2022-01-14)

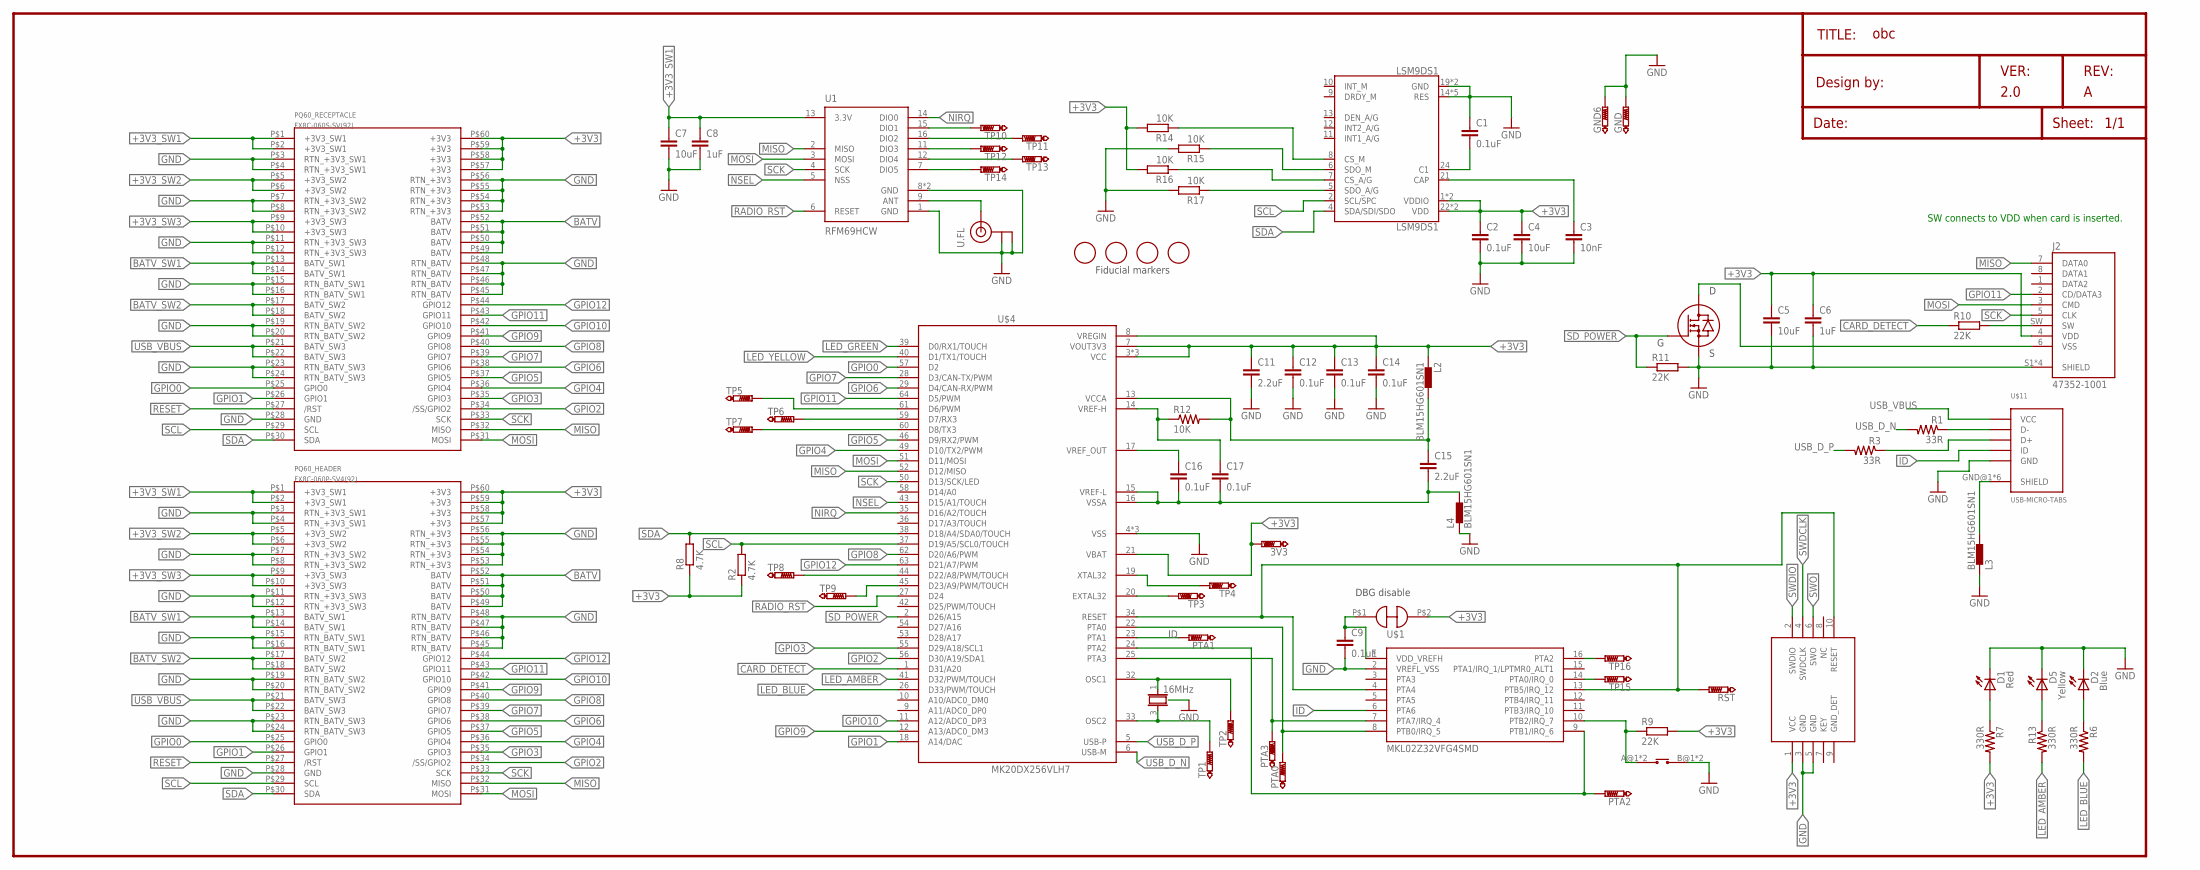
[picture p64: schematic OBC.sch]

Parts:
3V3: PTR1TP06R; TP06R
C1, C2, C9, C12, C13, C14, C16, C17: 0.1uF; C0402
C3: 10nF; C0402
C4, C5, C7: 10uF; C0805
C6, C8: 1uF; C0603
C11, C15: 2.2uF; C0603
D1: Red; CHIPLED_0603
D2: Blue; CHIPLED_0603
D5: Yellow; CHIPLED_0603
ERASE: EVPAF7B70
FD1, FD2, FD3, FD4: FIDUCIAL; FIDUCIAL_1MM
GND, GND6: PTR1TP06R; TP06R
J2: 47352-1001; MOLEX_47352-1001
L2, L3, L4: BLM15HG601SN1; 0402
LSM9DS1: LSM9DS1; LGA24-8X4
NDK_NX3225SA: 16MHz; 4SMD_DFN_LCC
PQ60_HEADER: FX8C-060P-SV4(92)
PQ60_RECEPTACLE: FX8C-060S-SV(92)
PTA0, PTA1, PTA2, PTA3: PTR1TP06R; TP06R
R1, R3: 33R; 0603-RES
R2, R8: 4.7K; R0402
R6, R7, R13: 330R; 0603-RES
R9, R10, R11: 22K; R0402
R12: 10K; 0402-RES
R14, R15, R16, R17: 10K; R0402
RST: PTR1TP06R; TP06R
SJ3: SJNC
TP1, TP2, TP3, TP4, TP5, TP6, TP7, TP8, TP9, TP10, TP11, TP12, TP13, TP14, TP15, TP16: PTR1TP06R; TP06R
U1: RFM69HCW; RFM69HCW-XXXS2
U$1: MKL02Z32VFG4SMD; QFN16
U$3: PMV40UN2; SOT23-3
U$4: MK20DX256VLH7; QFP50P1200X1200X160-64N
U$9: SWD_10_PIN
U$11: USB-MICRO-TABS
U.FL: U.FL

Connections:
+3V3: 3V3.TP, C2.1, C4.1, C5.1, C6.1, C11.1, C12.1, C13.1, C14.1, J2.4 (VDD), L2.1, LSM9DS1.1 (VDDIO), LSM9DS1.3 (VDDIO), LSM9DS1.22 (VDD), LSM9DS1.23 (VDD), PQ60_HEADER.P$57 (+3V3), PQ60_HEADER.P$58 (+3V3), PQ60_HEADER.P$59 (+3V3), PQ60_HEADER.P$60 (+3V3), PQ60_RECEPTACLE.P$57 (+3V3), PQ60_RECEPTACLE.P$58 (+3V3), PQ60_RECEPTACLE.P$59 (+3V3), PQ60_RECEPTACLE.P$60 (+3V3), R2.1, R7.2, R8.1, R9.2, R14.2, R16.2, SJ3.P$2, U$4.3 (VCC), U$4.7 (VOUT3V3), U$4.8 (VREGIN), U$4.21 (VBAT), U$4.30 (VCC), U$4.48 (VCC), U$9.1 (VCC)
+3V3_SW1: C7.1, C8.1, PQ60_HEADER.P$1 (+3V3_SW1), PQ60_HEADER.P$2 (+3V3_SW1), PQ60_RECEPTACLE.P$1 (+3V3_SW1), PQ60_RECEPTACLE.P$2 (+3V3_SW1), U1.13 (3.3V)
+3V3_SW2: PQ60_HEADER.P$5 (+3V3_SW2), PQ60_HEADER.P$6 (+3V3_SW2), PQ60_RECEPTACLE.P$5 (+3V3_SW2), PQ60_RECEPTACLE.P$6 (+3V3_SW2)
+3V3_SW3: PQ60_HEADER.P$9 (+3V3_SW3), PQ60_HEADER.P$10 (+3V3_SW3), PQ60_RECEPTACLE.P$9 (+3V3_SW3), PQ60_RECEPTACLE.P$10 (+3V3_SW3)
BATV: PQ60_HEADER.P$49 (BATV), PQ60_HEADER.P$50 (BATV), PQ60_HEADER.P$51 (BATV), PQ60_HEADER.P$52 (BATV), PQ60_RECEPTACLE.P$49 (BATV), PQ60_RECEPTACLE.P$50 (BATV), PQ60_RECEPTACLE.P$51 (BATV), PQ60_RECEPTACLE.P$52 (BATV)
BATV_SW1: PQ60_HEADER.P$13 (BATV_SW1), PQ60_HEADER.P$14 (BATV_SW1), PQ60_RECEPTACLE.P$13 (BATV_SW1), PQ60_RECEPTACLE.P$14 (BATV_SW1)
BATV_SW2: PQ60_HEADER.P$17 (BATV_SW2), PQ60_HEADER.P$18 (BATV_SW2), PQ60_RECEPTACLE.P$17 (BATV_SW2), PQ60_RECEPTACLE.P$18 (BATV_SW2)
CARD_DETECT: R10.1, U$4.1 (D31/A20)
GND: C1.1, C2.2, C3.2, C4.2, C5.2, C6.2, C7.2, C8.2, C9.2, C11.2, C12.2, C13.2, C14.2, D1.C, D2.C, D5.C, ERASE.B@1, ERASE.B@2, GND.TP, GND6.TP, J2.S1 (SHIELD), J2.S2 (SHIELD), J2.S3 (SHIELD), J2.S4 (SHIELD), L3.1, L4.1, LSM9DS1.14 (RES), LSM9DS1.15 (RES), LSM9DS1.16 (RES), LSM9DS1.17 (RES), LSM9DS1.18 (RES), LSM9DS1.19 (GND), LSM9DS1.20 (GND), NDK_NX3225SA.GND, NDK_NX3225SA.GND@1 (GND), NDK_NX3225SA.GND@2 (GND), PQ60_HEADER.P$3 (RTN_+3V3_SW1), PQ60_HEADER.P$4 (RTN_+3V3_SW1), PQ60_HEADER.P$7 (RTN_+3V3_SW2), PQ60_HEADER.P$8 (RTN_+3V3_SW2), PQ60_HEADER.P$11 (RTN_+3V3_SW3), PQ60_HEADER.P$12 (RTN_+3V3_SW3), PQ60_HEADER.P$15 (RTN_BATV_SW1), PQ60_HEADER.P$16 (RTN_BATV_SW1), PQ60_HEADER.P$19 (RTN_BATV_SW2), PQ60_HEADER.P$20 (RTN_BATV_SW2), PQ60_HEADER.P$23 (RTN_BATV_SW3), PQ60_HEADER.P$24 (RTN_BATV_SW3), PQ60_HEADER.P$28 (GND), PQ60_HEADER.P$45 (RTN_BATV), PQ60_HEADER.P$46 (RTN_BATV), PQ60_HEADER.P$47 (RTN_BATV), PQ60_HEADER.P$48 (RTN_BATV), PQ60_HEADER.P$53 (RTN_+3V3), PQ60_HEADER.P$54 (RTN_+3V3), PQ60_HEADER.P$55 (RTN_+3V3), PQ60_HEADER.P$56 (RTN_+3V3), PQ60_RECEPTACLE.P$3 (RTN_+3V3_SW1), PQ60_RECEPTACLE.P$4 (RTN_+3V3_SW1), PQ60_RECEPTACLE.P$7 (RTN_+3V3_SW2), PQ60_RECEPTACLE.P$8 (RTN_+3V3_SW2), PQ60_RECEPTACLE.P$11 (RTN_+3V3_SW3), PQ60_RECEPTACLE.P$12 (RTN_+3V3_SW3), PQ60_RECEPTACLE.P$15 (RTN_BATV_SW1), PQ60_RECEPTACLE.P$16 (RTN_BATV_SW1), PQ60_RECEPTACLE.P$19 (RTN_BATV_SW2), PQ60_RECEPTACLE.P$20 (RTN_BATV_SW2), PQ60_RECEPTACLE.P$23 (RTN_BATV_SW3), PQ60_RECEPTACLE.P$24 (RTN_BATV_SW3), PQ60_RECEPTACLE.P$28 (GND), PQ60_RECEPTACLE.P$45 (RTN_BATV), PQ60_RECEPTACLE.P$46 (RTN_BATV), PQ60_RECEPTACLE.P$47 (RTN_BATV), PQ60_RECEPTACLE.P$48 (RTN_BATV), PQ60_RECEPTACLE.P$53 (RTN_+3V3), PQ60_RECEPTACLE.P$54 (RTN_+3V3), PQ60_RECEPTACLE.P$55 (RTN_+3V3), PQ60_RECEPTACLE.P$56 (RTN_+3V3), R11.2, R15.2, R17.2, U1.1 (GND), U1.8 (GND), U1.10 (GND), U$1.2 (VREFL_VSS), U$3.2 (S), U$4.4 (VSS), U$4.31 (VSS), U$4.47 (VSS), U$9.3 (GND), U$9.5 (GND), U$11.PIN$5 (GND), U.FL.P$1 (GND), U.FL.P$2 (GND)
GPIO0: PQ60_HEADER.P$25 (GPIO0), PQ60_RECEPTACLE.P$25 (GPIO0), U$4.57 (D2)
GPIO1: PQ60_HEADER.P$26 (GPIO1), PQ60_RECEPTACLE.P$26 (GPIO1), U$4.18 (A14/DAC)
GPIO2: PQ60_HEADER.P$34 (/SS/GPIO2), PQ60_RECEPTACLE.P$34 (/SS/GPIO2), U$4.56 (D30/A19/SDA1)
GPIO3: PQ60_HEADER.P$35 (GPIO3), PQ60_RECEPTACLE.P$35 (GPIO3), U$4.55 (D29/A18/SCL1)
GPIO4: PQ60_HEADER.P$36 (GPIO4), PQ60_RECEPTACLE.P$36 (GPIO4), U$4.49 (D10/TX2/PWM)
GPIO5: PQ60_HEADER.P$37 (GPIO5), PQ60_RECEPTACLE.P$37 (GPIO5), U$4.46 (D9/RX2/PWM)
GPIO6: PQ60_HEADER.P$38 (GPIO6), PQ60_RECEPTACLE.P$38 (GPIO6), U$4.29 (D4/CAN-RX/PWM)
GPIO7: PQ60_HEADER.P$39 (GPIO7), PQ60_RECEPTACLE.P$39 (GPIO7), U$4.28 (D3/CAN-TX/PWM)
GPIO8: PQ60_HEADER.P$40 (GPIO8), PQ60_RECEPTACLE.P$40 (GPIO8), U$4.62 (D20/A6/PWM)
GPIO9: PQ60_HEADER.P$41 (GPIO9), PQ60_RECEPTACLE.P$41 (GPIO9), U$4.12 (A13/ADC0_DM3)
GPIO10: PQ60_HEADER.P$42 (GPIO10), PQ60_RECEPTACLE.P$42 (GPIO10), U$4.11 (A12/ADC0_DP3)
GPIO11: J2.2 (CD/DATA3), PQ60_HEADER.P$43 (GPIO11), PQ60_RECEPTACLE.P$43 (GPIO11), U$4.64 (D5/PWM)
GPIO12: PQ60_HEADER.P$44 (GPIO12), PQ60_RECEPTACLE.P$44 (GPIO12), U$4.63 (D21/A7/PWM)
ID: PTA1.TP, U$1.6 (PTA6), U$4.23 (PTA1), U$11.P$4 (ID)
LED_AMBER: R13.2, U$4.41 (D32/PWM/TOUCH)
LED_BLUE: R6.2, U$4.26 (D33/PWM/TOUCH)
LED_GREEN: U$4.39 (D0/RX1/TOUCH)
LED_YELLOW: U$4.40 (D1/TX1/TOUCH)
MISO: J2.7 (DATA0), PQ60_HEADER.P$32 (MISO), PQ60_RECEPTACLE.P$32 (MISO), U1.2 (MISO), U$4.52 (D12/MISO)
MOSI: J2.3 (CMD), PQ60_HEADER.P$31 (MOSI), PQ60_RECEPTACLE.P$31 (MOSI), U1.3 (MOSI), U$4.51 (D11/MOSI)
unnamed: NDK_NX3225SA.1, TP2.TP, U$4.32 (OSC1)
unnamed: C9.1, SJ3.P$1, U$1.1 (VDD_VREFH)
unnamed: ERASE.A@1, ERASE.A@2, R9.1, U$1.10 (PTB2/IRQ_7)
unnamed: TP4.TP, U$4.19 (XTAL32)
unnamed: R3.1, U$11.P$3 (D+)
unnamed: R1.1, U$11.P$2 (D-)
unnamed: TP3.TP, U$4.20 (EXTAL32)
unnamed: TP5.TP, U$4.61 (D6/PWM)
unnamed: J2.SW, R10.2
unnamed: TP16.TP, U$1.16 (PTA2)
unnamed: TP10.TP, U1.15 (DIO1)
unnamed: U1.9 (ANT), U.FL.P$3 (SIGNAL)
unnamed: TP11.TP, U1.16 (DIO2)
unnamed: J2.6 (VSS), U$3.3 (D)
unnamed: TP12.TP, U1.11 (DIO3)
unnamed: D2.A, R6.1
unnamed: TP13.TP, U1.12 (DIO4)
unnamed: TP14.TP, U1.7 (DIO5)
unnamed: RST.TP, U$1.4 (PTA4), U$1.13 (PTB5/IRQ_12), U$4.34 (RESET), U$9.10 (RESET)
unnamed: TP15.TP, U$1.14 (PTA0/IRQ_0)
unnamed: D1.A, R7.1
unnamed: NDK_NX3225SA.3, TP1.TP, U$4.33 (OSC2)
unnamed: C15.1, L2.2, R12.2, U$4.13 (VCCA)
unnamed: C17.1, R12.1, U$4.14 (VREF-H)
unnamed: C15.2, C16.2, C17.2, L4.2, U$4.15 (VREF-L), U$4.16 (VSSA)
unnamed: C16.1, U$4.17 (VREF_OUT)
unnamed: TP6.TP, U$4.59 (D7/RX3)
unnamed: TP7.TP, U$4.60 (D8/TX3)
unnamed: TP8.TP, U$4.44 (D22/A8/PWM/TOUCH)
unnamed: TP9.TP, U$4.45 (D23/A9/PWM/TOUCH)
unnamed: C1.2, LSM9DS1.24 (C1)
unnamed: C3.1, LSM9DS1.21 (CAP)
unnamed: LSM9DS1.7 (CS_A/G), R16.1
unnamed: LSM9DS1.8 (CS_M), R14.1
unnamed: D5.A, R13.1
unnamed: LSM9DS1.6 (SDO_M), R15.1
unnamed: LSM9DS1.5 (SDO_A/G), R17.1
NIRQ: U1.14 (DIO0), U$4.35 (D16/A2/TOUCH)
NSEL: U1.5 (NSS), U$4.43 (D15/A1/TOUCH)
RADIO_RST: U1.6 (RESET), U$4.27 (D24)
RESET: PQ60_HEADER.P$27 (/RST), PQ60_RECEPTACLE.P$27 (/RST)
SCK: J2.5 (CLK), PQ60_HEADER.P$33 (SCK), PQ60_RECEPTACLE.P$33 (SCK), U1.4 (SCK), U$4.50 (D13/SCK/LED)
SCL: LSM9DS1.2 (SCL/SPC), PQ60_HEADER.P$29 (SCL), PQ60_RECEPTACLE.P$29 (SCL), R2.2, U$4.37 (D19/A5/SCL0/TOUCH)
SDA: LSM9DS1.4 (SDA/SDI/SDO), PQ60_HEADER.P$30 (SDA), PQ60_RECEPTACLE.P$30 (SDA), R8.2, U$4.38 (D18/A4/SDA0/TOUCH)
SD_POWER: R11.1, U$3.1 (G), U$4.2 (D26/A15)
SHIELD: L3.2, U$11.GND@1 (SHIELD), U$11.GND@2 (SHIELD), U$11.GND@3 (SHIELD), U$11.GND@4 (SHIELD), U$11.GND@5 (SHIELD), U$11.GND@6 (SHIELD)
SWDCLK: PTA0.TP, U$1.8 (PTB0/IRQ_5), U$4.22 (PTA0), U$9.4 (SWDCLK)
SWDIO: PTA3.TP, U$1.7 (PTA7/IRQ_4), U$4.25 (PTA3), U$9.2 (SWDIO)
SWO: PTA2.TP, U$1.9 (PTB1/IRQ_6), U$4.24 (PTA2), U$9.6 (SWO)
USB_D_N: R1.2, U$4.6 (USB-M)
USB_D_P: R3.2, U$4.5 (USB-P)
USB_VBUS: PQ60_HEADER.P$21 (BATV_SW3), PQ60_HEADER.P$22 (BATV_SW3), PQ60_RECEPTACLE.P$21 (BATV_SW3), PQ60_RECEPTACLE.P$22 (BATV_SW3), U$11.P$1 (VCC)

Notes on the sheet:
TITLE:
Date:
VER:
2.0
Sheet:
Design by:
REV:
Fiducial markers
DBG disable
SW connects to VDD when card is inserted.

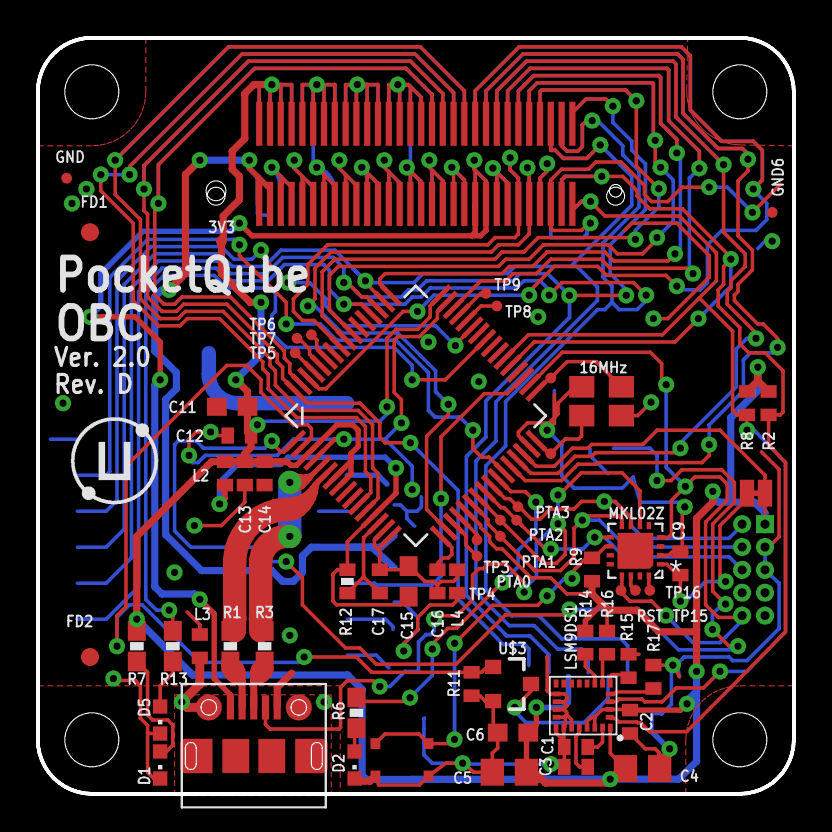
[picture p65: board OBC.brd from above]

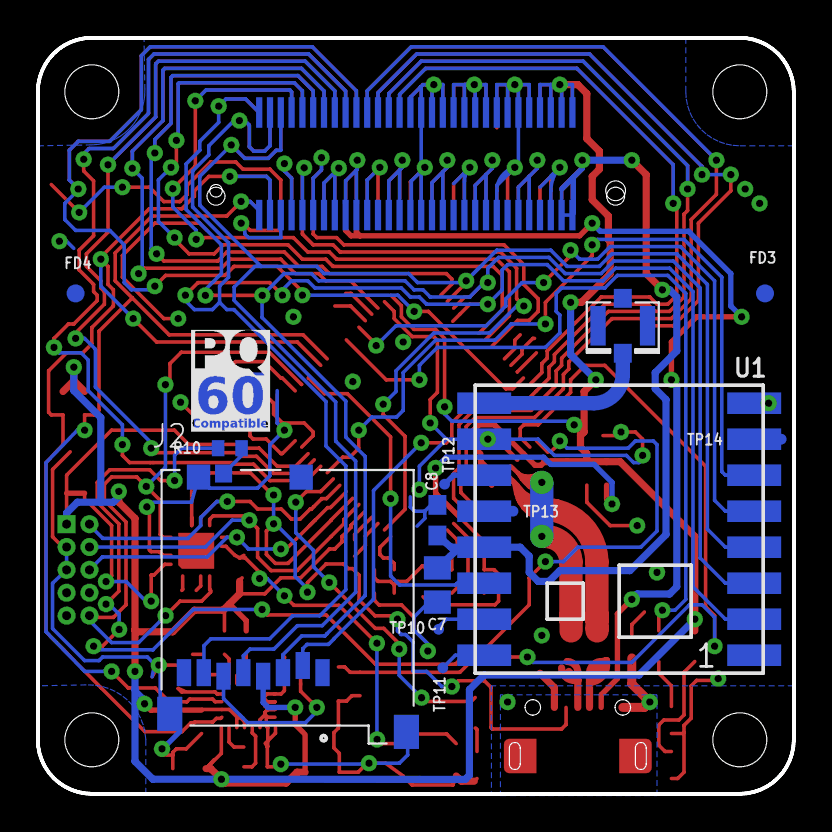
[picture p66: board OBC.brd from below]

Board: 2 copper layers, 42.0 x 42.0 mm, 82 parts (16 on the bottom side), 79 nets.

Other parts of the board:
U$2: PQ60_CMP
U$10: UBO_LOGO
U$13: SA_LOGO_SMALL
