SatelliteApplicationsCatapult/PocketQube/hardware/Electronic/PCB Designs/Breakout/MINI54_breakout/MINI54_breakout.brd

## EAGLE design hardware/Electronic/PCB Designs/Breakout/MINI54_breakout/MINI54_breakout.brd (2022-01-14)

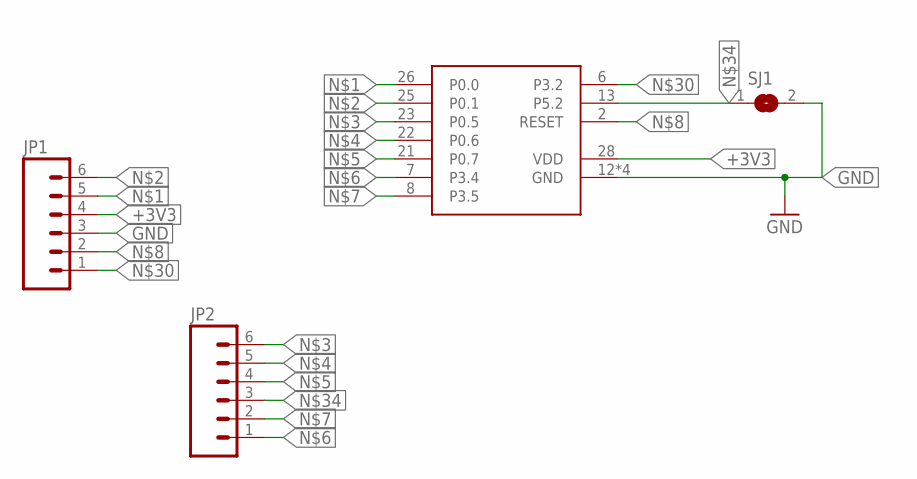
[picture p67: schematic MINI54_breakout.sch]

Parts:
JP1, JP2: M06LONGPADS; 1X06_LONGPADS
SJ1: SJ
U$9: MINITAN54-QFN; QFN50P500X500X100-33N

Connections:
+3V3: JP1.4, U$9.28 (VDD)
GND: JP1.3, SJ1.2, U$9.12 (GND), U$9.17 (GND), U$9.32 (GND), U$9.33 (GND)
unnamed: JP1.5, U$9.26 (P0.0)
unnamed: JP1.6, U$9.25 (P0.1)
unnamed: JP2.6, U$9.23 (P0.5)
unnamed: JP2.5, U$9.22 (P0.6)
unnamed: JP2.4, U$9.21 (P0.7)
unnamed: JP2.1, U$9.7 (P3.4)
unnamed: JP2.2, U$9.8 (P3.5)
unnamed: JP1.2, U$9.2 (RESET)
unnamed: JP1.1, U$9.6 (P3.2)
unnamed: JP2.3, SJ1.1, U$9.13 (P5.2)

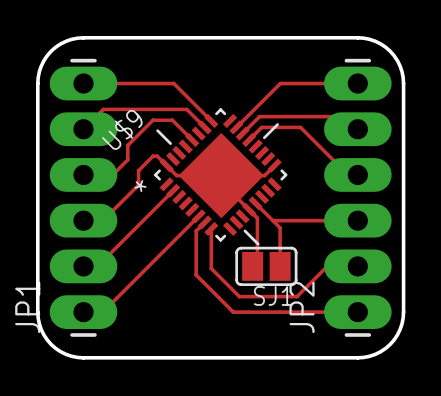
[picture p68: board MINI54_breakout.brd from above]

Board: 2 copper layers, 20.3 x 17.8 mm, 4 parts (0 on the bottom side), 12 nets.
