SatelliteApplicationsCatapult/PocketQube/hardware/Electronic/PCB Designs/Breakout/IMU_breakout/IMU_breakout.brd

## EAGLE design hardware/Electronic/PCB Designs/Breakout/IMU_breakout/IMU_breakout.brd (2022-01-14)

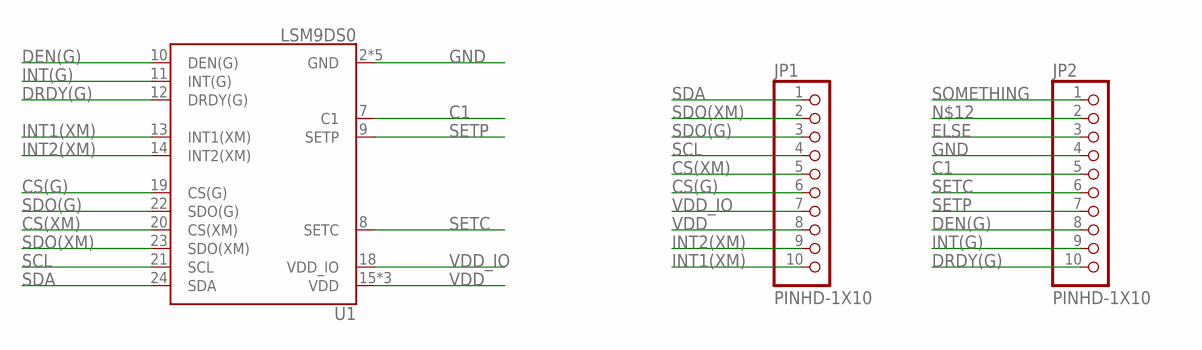
[picture p69: schematic IMU_breakout.sch]

Parts:
JP1, JP2: PINHD-1X10; 1X10-BIG
U1: LSM9DS0; LGA-24

Connections:
C1: JP2.5, U1.7 (C1)
CS(G): JP1.6, U1.19 (CS(G))
CS(XM): JP1.5, U1.20 (CS(XM))
DEN(G): JP2.8, U1.10 (DEN(G))
DRDY(G): JP2.10, U1.12 (DRDY(G))
ELSE: JP2.3
GND: JP2.4, U1.2 (GND), U1.3 (GND), U1.4 (GND), U1.5 (GND), U1.6 (GND)
INT1(XM): JP1.10, U1.13 (INT1(XM))
INT2(XM): JP1.9, U1.14 (INT2(XM))
INT(G): JP2.9, U1.11 (INT(G))
SCL: JP1.4, U1.21 (SCL)
SDA: JP1.1, U1.24 (SDA)
SDO(G): JP1.3, U1.22 (SDO(G))
SDO(XM): JP1.2, U1.23 (SDO(XM))
SETC: JP2.6, U1.8 (SETC)
SETP: JP2.7, U1.9 (SETP)
SOMETHING: JP2.1
VDD: JP1.8, U1.15 (VDD), U1.16 (VDD), U1.17 (VDD)
VDD_IO: JP1.7, U1.18 (VDD_IO)

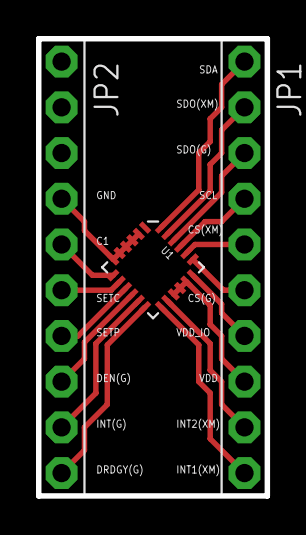
[picture p70: board IMU_breakout.brd from above]

Board: 2 copper layers, 12.7 x 25.4 mm, 3 parts (0 on the bottom side), 17 nets.
