SatelliteApplicationsCatapult/PocketQube/firmware/EPS_Firmware/Sources/config.h

/*
 * config.h
 *
 *  Created on: 17 Nov 2016
 *      Author: ubo
 */

#ifndef SOURCES_CONFIG_H_
#define SOURCES_CONFIG_H_

// Default I2C buffer variable length definitions
#define IN_DATA_LENGTH 5
#define OUT_DATA_LENGTH 4

// Default ADC parameters
#define ADC_SAMPLE_GROUP_SIZE 1U
#define REGULATED_RAIL_VOLTAGE 3.000
#define BATTERY_VOLTAGE_DIVIDER_RATIO 2.0
#define	ADC_FULL_SCALE_RESOLUTION 4096.0


#endif /* SOURCES_CONFIG_H_ */
