SatelliteApplicationsCatapult/PocketQube/firmware/EPS_Dev/Sources/COMS.h

/*
 * COMS.h
 *
 *  Created on: 20 Apr 2016
 *      Author: George Addison
 */

#ifndef SOURCES_COMS_H_
#define SOURCES_COMS_H_

#include "PE_Types.h"
#include "PE_LDD.h"

//typedef struct {
//	volatile bool dataRequestFlg; /* Set TRUE by I2C2_OnSlaveRxRequest() */
//	volatile bool dataReceivedFlg; /* Set TRUE by COMS.c on I2C data receipt */
//	volatile bool dataTransmittedFlg; /* Set TRUE on data transmission */
//	LDD_TDeviceData *handle; /* pointer to the device handle */
//} COMS_TDataState;
//
//uint8_t InpData[1];
//LDD_TError Error;
//LDD_TDeviceData *MyI2CPtr;
//volatile bool DataReceivedFlg = FALSE;
//volatile bool DataTransmittedFlg = FALSE;
//
//uint8_t COMS_I2C_RX(void);
//uint8_t COMS_I2C_TX(void);

#endif /* SOURCES_COMS_H_ */
