SatelliteApplicationsCatapult/PocketQube/cube/examples/Components/SD/SD.ino

#include <SD.h>
#include <SPI.h>

Sd2Card card;
SdVolume volume;
SdFile root;
File myFile;

const byte chipSelect = 5; //ubo SD chip select pin

void setup()
{
  // Open serial communications and wait for port to open:
  Serial.begin(115200);
  while (!Serial) {
   // wait for serial port to connect.
  }

  Serial.print(F("\nInitializing SD card...")); //Due to F(), string is copied from program memory and not via DRAM

  if (!card.init(SPI_HALF_SPEED, chipSelect)) {
    Serial.println(F("initialization failed. Things to check:"));
    Serial.println(F("* is a card inserted?"));
    Serial.println(F("* is your wiring correct?"));
    Serial.println(F("* did you change the chipSelect pin to match your shield or module?"));
    return;
  } 
  
  else {
    Serial.println(F("Wiring is correct and a card is present."));
  }

  if (!SD.begin(chipSelect)) {
    Serial.println(F("initialization failed!"));
    return;
  }
  
  Serial.println(F("initialization done."));

  // open the file. note that only one file can be open at a time,
  // so you have to close this one before opening another.
  myFile = SD.open("test.txt", FILE_WRITE);

  // print the type of card
  Serial.print(F("\nCard type: "));
  switch (card.type()) {
    case SD_CARD_TYPE_SD1:
      Serial.println(F("SD1"));
      break;
    case SD_CARD_TYPE_SD2:
      Serial.println(F("SD2"));
      break;
    case SD_CARD_TYPE_SDHC:
      Serial.println(F("SDHC"));
      break;
    default:
      Serial.println(F("Unknown"));
  }

  // Now we will try to open the 'volume'/'partition' - it should be FAT16 or FAT32
  if (!volume.init(card)) {
    Serial.println(F("Could not find FAT16/FAT32 partition. z\\  sure you've formatted the card"));
    return;
  }

  // print the type and size of the first FAT-type volume
  uint32_t volumesize;
  Serial.print(F("\nVolume type is FAT"));
  Serial.println(volume.fatType(), DEC);
  Serial.println();

  volumesize = volume.blocksPerCluster();    // clusters are collections of blocks
  volumesize *= volume.clusterCount();       // we'll have a lot of clusters
  if (volumesize < 8388608ul) {
    Serial.print(F("Volume size (bytes): "));
    Serial.println(volumesize * 512);        // SD card blocks are always 512 bytes
  }
  Serial.print(F("Volume size (Kbytes): "));
  volumesize /= 2;
  Serial.println(volumesize);
  Serial.print(F("Volume size (Mbytes): "));
  volumesize /= 1024;
  Serial.println(volumesize);


  Serial.println(F("\nFiles found on the card (name, date and size in bytes): "));
  root.openRoot(volume);

  // list all files in the card with date and size
  root.ls(LS_R | LS_DATE | LS_SIZE);
  myFile = SD.open("test.txt", FILE_WRITE);

  // if the file opened okay, write to it:
  if (myFile) {
    Serial.print(F("Writing to test.txt..."));
    myFile.println(F("testing 1, 2, 3."));
    // close the file:
    myFile.close();
    Serial.println(F("done."));
  } else {
    // if the file didn't open, print an error:
    Serial.println(F("error opening test.txt"));
  }

  // re-open the file for reading:
  myFile = SD.open("test.txt");
  if (myFile) {
    Serial.println(F("test.txt:"));

    // read from the file until there's nothing else in it:
    while (myFile.available()) {
      Serial.write(myFile.read());
    }
    // close the file:
    myFile.close();
  } else {
    // if the file didn't open, print an error:
    Serial.println(F("error opening test.txt"));
  }
}

void loop() {

}
