SatelliteApplicationsCatapult/PocketQube/cube/examples/Missions/beaconExampleGroundstation/beaconExampleGroundstation.ino

#include <RFM69.h>    //get it here: https://www.github.com/lowpowerlab/rfm69
#include <SPI.h>

#define NETWORKID     100  //the same on all nodes that talk to each other
#define NODEID        1

#define FREQUENCY     RF69_433MHZ
#define ENCRYPTKEY     null 
#define IS_RFM69HCW    true 

#define SERIAL_BAUD   115200

#define RFM69_CS      8
#define RFM69_IRQ     3
#define RFM69_IRQN    3  // Pin 3 is IRQ 3!
#define RFM69_RST     4

int16_t packetnum = 0;  // packet counter, we increment per xmission

RFM69 radio = RFM69(RFM69_CS, RFM69_IRQ, IS_RFM69HCW, RFM69_IRQN);

void setup() {
  Serial.begin(SERIAL_BAUD);

  Serial.println("Ubo groundstation");

  pinMode(RFM69_RST, OUTPUT);
  digitalWrite(RFM69_RST, HIGH);
  delay(100);
  digitalWrite(RFM69_RST, LOW);
  delay(100);

  // Initialize radio
  radio.initialize(FREQUENCY, NODEID, NETWORKID);
  if (IS_RFM69HCW) {
    radio.setHighPower();    // Only for RFM69HCW & HW!
  }
  radio.setPowerLevel(31); // power output ranges from 0 (5dBm) to 31 (20dBm)

  radio.encrypt(ENCRYPTKEY);

  Serial.print("\nListening at ");
  Serial.print(FREQUENCY == RF69_433MHZ ? 433 : FREQUENCY == RF69_868MHZ ? 868 : 915);
  Serial.println(" MHz");
}

void loop() {
  //check if something was received (could be an interrupt from the radio)
  if (radio.receiveDone())
  {
    //print message received to serial
    Serial.print('['); Serial.print(radio.SENDERID); Serial.print("] ");
    Serial.print("[RX_RSSI:"); Serial.print(radio.RSSI); Serial.print("] ");
    Serial.println((char*)radio.DATA);
  }

  radio.receiveDone(); //put radio in RX mode
  Serial.flush(); //make sure all serial data is clocked out before sleeping the MCU
}
