SatelliteApplicationsCatapult/PocketQube/(notices)

Notices in the files:
firmware/EPS_Firmware/Sources/stdbool.h:
GCC is free software; you can redistribute it and/or modify
it under the terms of the GNU General Public License as published by
the Free Software Foundation; either version 3, or (at your option)
hardware/Electronic/PCB Designs/EPS/KiCAD/EPS/modified_eagle_files/EPS.brd:
Copyright 2016 Satellite Applications Catapult
hardware/Electronic/PCB Designs/OBC/OBC.brd:
Copyright 2019 Satellite Applications Catapult
hardware/Electronic/PCB Designs/RFP/RFP.brd:
Copyright Satellite Applications Catapult 2019
parts and their libraries:
SparkFun-DigitalIC: Licensing: Creative Commons ShareAlike 4.0 International - https://creativecommons.org/licenses/by-sa/4.0
